MeghanaMadhuri/jetsonuarteyes/nina/controllers/hoverboard_axis_drive.py

"""
Drive Nina locomotion by tilting hoverboard driver modules via Dynamixel MX-28.

Primary Nina locomotion: lean servos on the Dynamixel bus (joint mode). API subset
matches ``NavigationManager`` as used by ``DriveController``, autonomy, and goto.

**Straight-line prime:** before each new symmetric straight FWD/BACK ``set_wheels``,
both lean servos move to ``NINA_HOVER_STRAIGHT_PRIME_POS`` (default 2048) for up to
``NINA_HOVER_STRAIGHT_PRIME_SEC`` (default 2 s). **Timed Turn left/right** do **not**
use this prime—they go straight to pivot ``set_wheels`` from the current pose.
D-pad pivots also skip the explicit prime.

After a pivot the brake pose is **already** at the prime ticks, so the prime
returns immediately and can look like it was skipped to the operator. Set
``NINA_HOVER_POST_TURN_SETTLE_SEC`` (default 0.0) to add a visible pause inside
``start_pulse_straight_forward`` / ``start_pulse_straight_backward`` after the
prime so the lean stack truly relaxes before the next pulse series fires—useful
when "Straight back" right after "Turn left/right" felt like it jumped straight
into the back stroke without slowing down.

**Pivot / turn:** lean ID ``id_left`` (often 12) and ``id_right`` (often 13) use
opposite forward/back goals. **Turn left** = left forward lean + right backward
lean. **Timed** ``turn_left`` / ``turn_right`` use full pivot goals (100% blend).
**Held** D-pad L/R use ``pulse_turn_micro_step`` at :data:`_HELD_DPAD_PIVOT_BLEND_PCT`
(30% of full pivot by default). Legacy unequal-duty path uses
``NINA_HOVER_TURN_SLOW_WHEEL_PCT`` vs outer ``speed_percent``. **Turn right** mirrors left.

**Straight FWD/BACK (drive-then-check):** ``start_pulse_straight_forward`` and
``start_pulse_straight_backward`` spawn :meth:`_drift_correct_loop` — the method
names are legacy. Each cycle: command full forward/back lean for
``NINA_HOVER_STRAIGHT_LEG_SEC`` (default **0.5 s**), brake, wait for standstill
(active settle on IMU yaw rate when wired), sample **cumulative** drift from the
integrator, run iterative left/right micro-step pivots when ``|drift|`` exceeds
``NINA_HOVER_STRAIGHT_CORR_DEADBAND_DEG``, then repeat until the operator
releases (``_halt_pulse_series``) or abort drift fires. The old coast↔forward
pulse ramp series is removed. Cancel with ``stop()`` / ``emergency_stop()`` /
``set_wheels`` / ``drive_continuous``.

**IMU hooks:** call :meth:`set_imu_hooks` once at construction with a yaw-drift
sampler, yaw-rate sampler (for active settle), and begin/end straight callbacks
(``NinaService`` wires :class:`Mpu9250DriftMonitor` here). Without hooks the
straight loop still runs 0.5 s legs but skips drift correction
(``no IMU sample, skipping drift check`` in logs). Tune standstill correction
via ``NINA_HOVER_STRAIGHT_CORR_*``; legacy ``NINA_HOVER_IMU_CORR_*`` knobs
below apply to other paths (e.g. held-turn micro-steps), not the straight loop.

Bail behaviour (defends against an un-flipped ``INVERT_SIGN`` on a new
chassis without false-tripping on momentum or correct-direction overshoot):
- The first ``NINA_HOVER_IMU_CORR_BAIL_WARMUP_STEPS`` samples are ignored
  for the bail — the bot is still bleeding off angular momentum from the
  pre-brake forward lean, so drift growth during this window does not
  imply a wrong pivot direction.
- The bail only fires when drift is **still in the same sign as the
  original drift**. If the realign over-corrects past zero, the
  ``overshoot guard`` handles it (cleanly exits with reason "over-shot
  zero"); the wrong-direction bail does not fire on opposite-sign growth
  (that would mis-attribute a too-strong-but-correct pivot as a wrong
  direction).
- Past warmup, with same-sign drift, the bail pins ``yaw_after_warmup``
  on the first qualifying sample and only fires once
  ``|drift| > |yaw_after_warmup| + NINA_HOVER_IMU_CORR_BAIL_MARGIN_DEG``
  for two consecutive same-sign samples. Margin defaults to 5° so a
  single noisy read or minor momentum overshoot can't kill an otherwise
  correct realign.

Tuning env vars (defaults make each step visibly authoritative on the
hoverboard chassis; lower them only if the realign is over-shooting):

  ``NINA_HOVER_IMU_CORR_ENABLE``                default 1
  ``NINA_HOVER_IMU_CORR_THRESHOLD_DEG``         default 4.0   (only fire when drift gets noticeable)
  ``NINA_HOVER_IMU_CORR_DEADBAND_DEG``          default 1.5   (stop realign when drift returns inside this)
  ``NINA_HOVER_IMU_CORR_PIVOT_BLEND_PCT``       (legacy; in-motion pivots use held-D-pad blend)
  ``NINA_HOVER_IMU_CORR_PIVOT_MAX_SEC``         (legacy; in-motion uses ``NINA_HOVER_TURN_STEP_*``)
  ``NINA_HOVER_IMU_CORR_STEP_MIN_SEC``          (legacy; in-motion uses ``NINA_HOVER_TURN_STEP_*``)
  ``NINA_HOVER_IMU_CORR_STEP_RATE_DEG_PER_SEC`` (legacy; in-motion uses ``NINA_HOVER_TURN_STEP_RATE``)
  ``NINA_HOVER_IMU_CORR_STEP_SETTLE_SEC``       (legacy; standstill drift-correct only)

  In-motion left/right yaw realign during forward/back pulse holds uses the **same**
  lean pacing as held D-pad L/R (``NINA_HOVER_TURN_STEP_DUR_CAP_SEC`` default 0.26 s,
  ``NINA_HOVER_TURN_STEP_MIN_SEC`` 0.10 s, ``NINA_HOVER_TURN_STEP_SETTLE_SEC`` 0.12 s,
  ``NINA_HOVER_TURN_STEP_RATE_DEG_PER_SEC`` 22 dps, 30% pivot blend,
  ``NINA_HOVER_TURN_PRE_SETTLE_SEC`` / ``NINA_HOVER_TURN_POST_SETTLE_SEC``).
  ``NINA_HOVER_IMU_CORR_MAX_STEPS``             default 15    (hard cap on micro-step iterations;
                                                                with proportional sizing typical
                                                                events terminate in 1-3 steps)
  ``NINA_HOVER_IMU_CORR_PROGRESS_CHECK_STEPS``  default 4     (check progress after N steps;
                                                                set 0 to disable)
  ``NINA_HOVER_IMU_CORR_PROGRESS_MIN_DEG``      default 1.0   (min cumulative improvement in
                                                                ``|drift|`` required by the
                                                                progress-check step; below this
                                                                the realign exits as "no progress"
                                                                so the cooldown + next event can
                                                                try fresh instead of burning
                                                                MAX_STEPS on a stuck loop)
  ``NINA_HOVER_IMU_CORR_BAIL_WARMUP_STEPS``     default 3     (steps before wrong-direction bail
                                                                can fire — absorbs pre-brake momentum)
  ``NINA_HOVER_IMU_CORR_BAIL_MARGIN_DEG``       default 5.0   (drift growth past post-warmup baseline
                                                                required to actually bail; must be
                                                                exceeded on 2 consecutive samples)
  ``NINA_HOVER_IMU_CORR_SETTLE_SEC``            default 0.25  (brake settle BEFORE the first step AND
                                                                AFTER the loop, before re-priming)
  ``NINA_HOVER_IMU_CORR_COOLDOWN_SEC``          default 1.0   (rest period after each correction before
                                                                the next IMU sample; persists across
                                                                pulse cycles so corrections don't fire
                                                                back-to-back)
  ``NINA_HOVER_IMU_CORR_POLL_HZ``               default 5     (drift sample rate inside pulse holds)
  ``NINA_HOVER_IMU_CORR_INVERT_SIGN``           default 0     (flip drift sign interpretation)
  ``NINA_HOVER_IMU_CORR_SWAP_PIVOT_DIR``        deprecated — yaw correction uses
                                                                ``NINA_HOVER_TURN_SWAP_PIVOT_DIR`` (same
                                                                as held D-pad / closed-loop turns)

Backward-direction overrides (THRESHOLD and STEP_RATE ship with their own
backward-optimised defaults baked in after field testing; COOLDOWN still
inherits from forward unless explicitly set):

  ``NINA_HOVER_IMU_CORR_BACK_THRESHOLD_DEG``     default 6.0
                                                                (vs forward 4.0; higher because the
                                                                chassis naturally drifts to a ~+8 deg
                                                                rest pose in reverse and the forward
                                                                threshold fires spuriously on that
                                                                bias. Lower this to react earlier;
                                                                raise to let small drift slide.)
  ``NINA_HOVER_IMU_CORR_BACK_COOLDOWN_SEC``      default = forward cooldown
                                                                (1.0 s works for both directions per
                                                                field testing; lower this if backward
                                                                natural drift outpaces the gap)
  ``NINA_HOVER_IMU_CORR_BACK_STEP_RATE_DEG_PER_SEC`` default 60.0
                                                                (vs forward 30.0; higher because
                                                                backward pivots are physically more
                                                                authoritative on this chassis -- the
                                                                forward 30.0 calibration over-shoots
                                                                when reused in reverse. Raise this if
                                                                backward still over-corrects; lower
                                                                if backward under-corrects.)

Stuck detector (defends against a feedback loop where the chassis is
stationary, the pivot lean can't rotate stationary wheels, every realign
exits as "no progress", and the regular short cooldown immediately fires
another equally-doomed realign — locking the bot in place):

  ``NINA_HOVER_IMU_CORR_STUCK_STREAK``           default 3     (consecutive ``no progress`` exits before
                                                                the stuck cooldown kicks in; set to 0 to
                                                                disable the detector entirely)
  ``NINA_HOVER_IMU_CORR_STUCK_COOLDOWN_SEC``     default 8.0   (cooldown applied when the detector fires;
                                                                long enough that the pulse loop gets at
                                                                least one full hold cycle to build wheel
                                                                momentum and break the chassis out of the
                                                                stationary state. Resets back to the
                                                                regular direction-aware cooldown on the
                                                                first successful realign — any non-
                                                                no-progress exit clears the streak)

Drift-abort (catastrophic-drift safety stop with spoken alert; sits
above the realign loop so a sign-flipped IMU mount, a failed wheel, or
any condition that puts the bot into a runaway spin terminates the
pulse leg cleanly instead of spending pulse cycles snaking off course):

  ``NINA_HOVER_IMU_CORR_ABORT_DRIFT_DEG``        default 30.0  (abort the pulse series when ``|drift|``
                                                                first crosses this magnitude on a fresh
                                                                IMU sample. Brakes the lean stack, sets
                                                                the pulse halt event, and queues a
                                                                single TTS announcement via
                                                                :func:`nina.services.sensor_alert_audio.maybe_speak_cant_move_alert`
                                                                — the exact phrase is
                                                                :data:`_IMU_CORR_ABORT_PHRASE`. The
                                                                operator must issue a fresh drive
                                                                command to resume — there is no
                                                                automatic retry. Set to ``0`` to
                                                                disable. Fires on both the forward
                                                                and backward pulse loops.)

Logging convention: every IMU-correction log line emitted from inside the
pulse hold (``hover IMU correction (forward): ...`` or
``hover IMU correction (backward): ...``) carries the direction tag of the
pulse loop that triggered it. The correction geometry is identical for
both directions (the pivot command is decided from the SIGN of the world-
frame drift sample, not from the chassis motion direction), but tagging
lets the operator confirm via ``grep`` that the backward pulse loop is
actually firing corrections — and at what rate / magnitude relative to
forward — without needing to cross-reference timestamps against the
``hover backward pulse series`` banner. The realign banner reports the
*effective* threshold / step_rate for the direction in which the
correction is firing, so a backward correction running under
``NINA_HOVER_IMU_CORR_BACK_THRESHOLD_DEG=3.0`` will print ``>= 3.00 deg
threshold`` even when forward is configured for 4.0.
"""

from __future__ import annotations

import logging
import math
import os
import threading
import time
import traceback
from typing import Callable, Dict, Optional, Tuple

from nina.config.settings import HoverboardAxisSettings
from nina.controllers.dynamixel_manager import REG_PRESENT_POS, DynamixelManager
from nina.services.sensor_alert_audio import maybe_speak_cant_move_alert

log = logging.getLogger("nina.hoverboard_axis")

# Spoken when the drift-abort fires; kept as a module constant so tests can
# assert on the exact phrase the operator will hear and so the bldc speech
# alerts cooldown (12 s default) coalesces repeated aborts within one leg.
_IMU_CORR_ABORT_PHRASE = "I can't move steadily any further, stopping now."

# Yaw drift sampler — returns signed degrees ``+`` = bot drifted right, ``-`` = left,
# or ``None`` when the integrator is paused / calibrating / unavailable.
ImuYawDriftFn = Callable[[], Optional[float]]
# Instantaneous yaw rate sampler — returns signed deg/s (sign convention matches
# the drift sampler) or ``None`` when the gyro is unavailable. Used by the new
# active-settle (wait-until-chassis-is-actually-still) helper in the forward
# straight loop; if not wired the loop falls back to a fixed timer.
ImuYawRateFn = Callable[[], Optional[float]]
# Optional begin/end hooks called when the drive enters / leaves a straight leg.
ImuStraightHook = Callable[[], None]

_POS_SPAN_DEG = 300.0


def _smoothstep01(t: float) -> float:
    """Hermite smoothstep; zero derivative at 0 and 1 (soft turnarounds)."""
    t = max(0.0, min(1.0, float(t)))
    return t * t * (3.0 - 2.0 * t)


def _smootherstep01(t: float) -> float:
    """Quintic Perlin smootherstep; zero 1st and 2nd derivative at 0 and 1."""
    t = max(0.0, min(1.0, float(t)))
    return t * t * t * (t * (t * 6.0 - 15.0) + 10.0)


def _cubic_ease_in_out01(t: float) -> float:
    """Symmetric cubic ease-in-out; slower ends, faster middle than smoothstep."""
    t = max(0.0, min(1.0, float(t)))
    if t < 0.5:
        return 4.0 * t * t * t
    u = 2.0 * t - 2.0
    return 1.0 + 0.5 * u * u * u


def _trapezoid_blend01(t: float, edge_frac: float) -> float:
    """Blend parameter 0->1 with trapezoidal *velocity* (ease accel / cruise / decel).

    *edge_frac* is the fraction of total time for symmetric accel+decel (each ``edge_frac``).
    """
    t = max(0.0, min(1.0, float(t)))
    e = max(0.08, min(0.35, float(edge_frac)))
    if 2.0 * e >= 0.999:
        return _smootherstep01(t)
    a = e / (2.0 * (1.0 - e))
    if t <= e:
        return a * (t / e) * (t / e)
    if t >= 1.0 - e:
        u = (1.0 - t) / e
        return 1.0 - a * u * u
    return a + (1.0 - 2.0 * a) * (t - e) / (1.0 - 2.0 * e)


def _pulse_ramp_blend_u(t: float, profile: str, trap_edge: float) -> float:
    """Map uniform time *t* in [0,1] to position blend *u* in [0,1] for servo ramps."""
    p = (profile or "smootherstep").strip().lower()
    if p == "smoothstep":
        return _smoothstep01(t)
    if p == "smootherstep":
        return _smootherstep01(t)
    if p in ("cubic_io", "cubic", "cubic-ease"):
        return _cubic_ease_in_out01(t)
    if p in ("trapezoid", "trap", "velocity"):
        return _trapezoid_blend01(t, trap_edge)
    return _smootherstep01(t)


def _nudge_goal_from_brake(goal: int, brake: int, push: int) -> int:
    """Move *goal* *push* raw ticks away from *brake* (signed).

    Positive *push* moves further from brake (i.e. MORE lean, in
    whichever direction *goal* already sits relative to *brake*).
    Negative *push* pulls back toward brake (LESS lean). ``push == 0``
    is a no-op. If *goal* is exactly at *brake* there's no defined
    "away" direction so we return *goal* unchanged regardless of
    *push*.

    Used by:
    - the forward straight branch (per-side raw delta on ``forward_pos_*``,
      then ``_STRAIGHT_FWD_EXTRA_TICKS`` away from brake),
    - the turn pivot helper (positive ``turn_push_ticks`` /
      ``_TURN_PIVOT_GOAL_OFFSET_TICKS``),
    - the backward straight branch (signed per-side
      ``_STRAIGHT_BACK_{LEFT,RIGHT}_TICKS_OFFSET`` — operator can
      either reinforce the calibrated lean (positive) or trim it back
      toward neutral (negative) without re-tuning ``backward_pos_*``).
    """
    if push == 0:
        return goal
    if goal > brake:
        return goal + push
    if goal < brake:
        return goal - push
    return goal


def apply_hoverboard_brake_positions(dxl: DynamixelManager, axis_cfg: HoverboardAxisSettings) -> None:
    """Command lean servos to the configured brake pose (boot / stopped)."""
    dxl._require_initialized()
    lid = int(axis_cfg.id_left)
    rid = int(axis_cfg.id_right)
    left = dxl._clamp_pos(int(axis_cfg.brake_pos_left))
    right = dxl._clamp_pos(int(axis_cfg.brake_pos_right))
    ms = max(0, min(1023, int(axis_cfg.moving_speed)))
    dxl.sync_write_moving_speed_subset({lid: ms, rid: ms})
    dxl.sync_write_goal_position({lid: left, rid: right})


_POS_SCALE = 4096.0 / _POS_SPAN_DEG

# Extra raw ticks past calibrated ``forward_pos_*`` toward drive (symmetric straight FWD only).
_STRAIGHT_FWD_EXTRA_TICKS = 14

# Per-side raw tick delta added to ``forward_pos_*`` before the straight
# FWD extra nudge. Matches operator bench language (±N ticks on the goal).
# Fleet bench (FWD 2022/2080, brake 2048, +14 nudge): motor 12 → 2010,
# motor 13 → 2104.
_STRAIGHT_FWD_LEFT_TICKS_OFFSET = 2
_STRAIGHT_FWD_RIGHT_TICKS_OFFSET = 10


def _straight_fwd_left_ticks_offset() -> int:
    """Raw tick delta on ``forward_pos_left`` for straight FWD (env:
    ``NINA_HOVER_STRAIGHT_FWD_LEFT_TICKS_OFFSET``, default +2 — with fleet
    ``NINA_HOVER_FWD_POS_LEFT=2022`` yields straight goal **2010**)."""
    try:
        return max(
            -50,
            min(
                50,
                int(
                    os.environ.get(
                        "NINA_HOVER_STRAIGHT_FWD_LEFT_TICKS_OFFSET",
                        str(_STRAIGHT_FWD_LEFT_TICKS_OFFSET),
                    )
                ),
            ),
        )
    except ValueError:
        return _STRAIGHT_FWD_LEFT_TICKS_OFFSET


def _straight_fwd_right_ticks_offset() -> int:
    """Signed trim on ``forward_pos_right`` for straight FWD (env:
    ``NINA_HOVER_STRAIGHT_FWD_RIGHT_TICKS_OFFSET``, default +10 — with fleet
    ``NINA_HOVER_FWD_POS_RIGHT=2080`` yields straight goal **2104**)."""
    try:
        return max(
            -50,
            min(
                50,
                int(
                    os.environ.get(
                        "NINA_HOVER_STRAIGHT_FWD_RIGHT_TICKS_OFFSET",
                        str(_STRAIGHT_FWD_RIGHT_TICKS_OFFSET),
                    )
                ),
            ),
        )
    except ValueError:
        return _STRAIGHT_FWD_RIGHT_TICKS_OFFSET


# Per-side SIGNED nudge magnitudes for the straight BACK leg, applied
# via :func:`_nudge_goal_from_brake` (same mechanism the forward branch
# uses, just with independent per-side magnitudes). Positive value =
# MORE backward lean for that side; negative = LESS lean (pulled
# toward brake). This direction-of-lean-aware nudge is required
# because ``backward_pos_left`` and ``backward_pos_right`` can sit on
# OPPOSITE sides of brake on the same chassis — a raw integer
# ``goal + offset`` would push one side's lean further out and the
# other side's lean closer to neutral for the SAME positive offset,
# which is exactly the bug that produced the "motor 12 leans, motor 13
# doesn't get pushed, chassis spins" symptom in the field.
#
# Defaults are 0 / 0 — i.e. drive the bare calibrated
# ``backward_pos_*`` straight through with no per-side trim.
# Operator's bench-validated calibration on the reference chassis
# (``backward_pos_left = 2005``, ``backward_pos_right = 1995``, both
# BELOW brake=2048) already carries the asymmetric lean it needs
# baked into the calibrated source itself, so no additional per-side
# bias is needed by default.
#
# Operators can re-tune per-bot via
# ``NINA_HOVER_STRAIGHT_BACK_LEFT_TICKS_OFFSET`` and
# ``NINA_HOVER_STRAIGHT_BACK_RIGHT_TICKS_OFFSET`` (signed, clamped to
# ``[-50, 50]``). Positive values add lean (further from brake);
# negative trim the calibrated lean closer to neutral without
# re-tuning ``backward_pos_*`` itself.
_STRAIGHT_BACK_LEFT_TICKS_OFFSET = 0
_STRAIGHT_BACK_RIGHT_TICKS_OFFSET = 0


def _straight_back_left_ticks_offset() -> int:
    """Signed raw tick offset added to ``backward_pos_left`` for the
    straight BACK leg (env: ``NINA_HOVER_STRAIGHT_BACK_LEFT_TICKS_OFFSET``,
    default :data:`_STRAIGHT_BACK_LEFT_TICKS_OFFSET`).

    Clamped to ``[-50, 50]`` so a typo can't drive the lean stack into
    a saturated corner. Garbage falls back to the documented default.
    See the module-level comment near
    :data:`_STRAIGHT_BACK_LEFT_TICKS_OFFSET` for the wheel-asymmetry
    rationale.
    """
    try:
        return max(
            -50,
            min(
                50,
                int(
                    os.environ.get(
                        "NINA_HOVER_STRAIGHT_BACK_LEFT_TICKS_OFFSET",
                        str(_STRAIGHT_BACK_LEFT_TICKS_OFFSET),
                    )
                ),
            ),
        )
    except ValueError:
        return _STRAIGHT_BACK_LEFT_TICKS_OFFSET


def _straight_back_right_ticks_offset() -> int:
    """Signed raw tick offset added to ``backward_pos_right`` for the
    straight BACK leg (env: ``NINA_HOVER_STRAIGHT_BACK_RIGHT_TICKS_OFFSET``,
    default :data:`_STRAIGHT_BACK_RIGHT_TICKS_OFFSET`).

    Clamped to ``[-50, 50]``. See the per-side asymmetric-trim notes
    near :data:`_STRAIGHT_BACK_LEFT_TICKS_OFFSET`.
    """
    try:
        return max(
            -50,
            min(
                50,
                int(
                    os.environ.get(
                        "NINA_HOVER_STRAIGHT_BACK_RIGHT_TICKS_OFFSET",
                        str(_STRAIGHT_BACK_RIGHT_TICKS_OFFSET),
                    )
                ),
            ),
        )
    except ValueError:
        return _STRAIGHT_BACK_RIGHT_TICKS_OFFSET

# Pivot only (L/R yaw): extra nudge away from each side's brake (after
# ``turn_push_ticks``). Must use directional nudge — a raw +Δ on both goals
# can land on brake and wipe blended timed-turn motion for that axis.
_TURN_PIVOT_GOAL_OFFSET_TICKS = 100

# IMU drift correction + closed-loop 90° turns: full calibrated pivot goals.
_PIVOT_MICROSTEP_BLEND_PCT = 100

# Held D-pad left/right (``pulse_turn_micro_step``) and timed turn_* fallback:
# 30% = 70% reduction from full pivot (mechanical shock).
_HELD_DPAD_PIVOT_BLEND_PCT = 30


def hover_computed_turn_pivot_goals(
    axis: HoverboardAxisSettings,
    *,
    turn_left: bool,
) -> tuple[int, int]:
    """Full pivot (id_left, id_right) raw goals from FWD/REV + push ticks + pivot offset.

    Used by :meth:`HoverboardAxisDrive._goals_for_wheels` when optional
    per-turn overrides are unset.
    """
    def _cg(t: int) -> int:
        return max(0, min(4095, int(t)))

    nl = _cg(int(axis.brake_pos_left))
    nr = _cg(int(axis.brake_pos_right))
    fl = _cg(int(axis.forward_pos_left))
    fr = _cg(int(axis.forward_pos_right))
    bl = _cg(int(axis.backward_pos_left))
    br = _cg(int(axis.backward_pos_right))
    if turn_left:
        l_tgt, r_tgt = fl, br
    else:
        l_tgt, r_tgt = bl, fr
    if axis.swap_turn_lr:
        l_tgt, r_tgt = r_tgt, l_tgt
    push = int(axis.turn_push_ticks)
    if push > 0:
        l_tgt = _nudge_goal_from_brake(l_tgt, nl, push)
        r_tgt = _nudge_goal_from_brake(r_tgt, nr, push)
    extra = int(_TURN_PIVOT_GOAL_OFFSET_TICKS)
    if extra > 0:
        l_tgt = _cg(_nudge_goal_from_brake(l_tgt, nl, extra))
        r_tgt = _cg(_nudge_goal_from_brake(r_tgt, nr, extra))
    return l_tgt, r_tgt


def _straight_prime_goal_ticks() -> int:
    try:
        return max(0, min(4095, int(os.environ.get("NINA_HOVER_STRAIGHT_PRIME_POS", "2048"))))
    except ValueError:
        return 2048


def _straight_prime_timeout_sec() -> float:
    try:
        return max(0.05, min(5.0, float(os.environ.get("NINA_HOVER_STRAIGHT_PRIME_SEC", "2.0"))))
    except ValueError:
        return 2.0


def _straight_prime_tol_ticks() -> int:
    try:
        return max(1, min(512, int(os.environ.get("NINA_HOVER_STRAIGHT_PRIME_TOL_TICKS", "32"))))
    except ValueError:
        return 32


def _post_turn_settle_sec() -> float:
    """Extra dwell after the straight prime inside ``start_pulse_straight_*``.

    When ``stop()`` from a pivot leaves the lean stack at the brake pose AND the
    prime goal equals brake, ``_prime_straight_neutral`` returns immediately on
    the first present-position read—so the operator can't see priming happen
    before the next pulse series fires. Setting this >0 inserts a visible pause
    (logged) after the prime, before the back / forward pulse begins.
    """
    raw = (os.environ.get("NINA_HOVER_POST_TURN_SETTLE_SEC") or "").strip()
    if not raw:
        return 0.0
    try:
        return max(0.0, min(2.0, float(raw)))
    except ValueError:
        return 0.0


def _imu_corr_enabled() -> bool:
    raw = (os.environ.get("NINA_HOVER_IMU_CORR_ENABLE") or "").strip().lower()
    if raw == "":
        return True  # default ON when hooks are wired
    return raw in ("1", "true", "yes", "y", "on")


def _imu_corr_threshold_deg() -> float:
    """At/above this |drift|, pause forward motion and run the incremental
    realign. Higher = less twitchy but each correction does more work.
    """
    try:
        return max(
            0.1,
            min(45.0, float(os.environ.get("NINA_HOVER_IMU_CORR_THRESHOLD_DEG", "4.0"))),
        )
    except ValueError:
        return 4.0


def _imu_corr_deadband_deg() -> float:
    """The micro-step realign exits once ``|drift| <= deadband``. Smaller =
    tighter heading hold but more micro-steps per correction.
    """
    try:
        return max(
            0.0,
            min(10.0, float(os.environ.get("NINA_HOVER_IMU_CORR_DEADBAND_DEG", "1.5"))),
        )
    except ValueError:
        return 1.5


def _imu_corr_pivot_blend_pct() -> int:
    """Per-micro-step pivot blend % — always full pivot (:data:`_PIVOT_MICROSTEP_BLEND_PCT`)."""
    return _PIVOT_MICROSTEP_BLEND_PCT


def _imu_corr_pivot_max_sec() -> float:
    """**Per-micro-step** pivot duration cap. Default 0.18 s so each step
    rotates the bot a visible 1.5-2° at the 20 % blend (the MX-28 needs
    >100 ms of commanded goal to actually slew there). The realign loop
    reads the live drift after every step, so total correction time
    auto-scales with the magnitude of the drift instead of being decided
    up-front.
    """
    try:
        return max(
            0.02,
            min(3.0, float(os.environ.get("NINA_HOVER_IMU_CORR_PIVOT_MAX_SEC", "0.18"))),
        )
    except ValueError:
        return 0.18


def _imu_corr_step_settle_sec() -> float:
    """Brake dwell BETWEEN micro-steps so the IMU re-samples on a still bot.

    Smaller = faster total realign, but the integrator can be noisy if the
    chassis is still rotating from the last step. 0.08 s is the default.
    """
    try:
        return max(
            0.0,
            min(1.0, float(os.environ.get("NINA_HOVER_IMU_CORR_STEP_SETTLE_SEC", "0.08"))),
        )
    except ValueError:
        return 0.08


def _imu_corr_max_steps() -> int:
    """Hard cap on micro-step iterations inside one realign. Worst-case the
    routine corrects ``max_steps * step_rotation`` of drift before giving
    up. Default 15 keeps the routine bounded to ~4 s at the default per-step
    timings while still giving ~20-30° of correction head-room.
    """
    try:
        return max(
            1,
            min(200, int(float(os.environ.get("NINA_HOVER_IMU_CORR_MAX_STEPS", "15")))),
        )
    except ValueError:
        return 15


def _imu_corr_step_rate_deg_per_sec() -> float:
    """Empirical chassis rotation rate (deg/s) at the configured per-step
    blend. Used to make the realign **proportional**: each step's duration
    is scaled by the remaining drift so small drifts get short pulses and
    big drifts get the full ``PIVOT_MAX_SEC`` cap. Default 30 deg/s
    matches the 20 % blend on the current hoverboard build (bench
    measured); tune up if the bot still over-shoots small drifts, or down
    if it visibly under-corrects.
    """
    try:
        return max(
            1.0,
            min(360.0, float(os.environ.get("NINA_HOVER_IMU_CORR_STEP_RATE_DEG_PER_SEC", "30.0"))),
        )
    except ValueError:
        return 30.0


def _imu_corr_step_min_sec() -> float:
    """Floor on the per-step duration. The MX-28 has ~50 ms of slew
    latency before any visible rotation; pulses below this floor are
    effectively no-ops. Default 0.08 s puts a little headroom above the
    slew latency so even the smallest proportional step produces measurable
    rotation.
    """
    try:
        return max(
            0.01,
            min(1.0, float(os.environ.get("NINA_HOVER_IMU_CORR_STEP_MIN_SEC", "0.08"))),
        )
    except ValueError:
        return 0.08


def _imu_corr_progress_check_steps() -> int:
    """Number of micro-steps the realign will run before checking that it's
    actually making progress. If, after this many steps, drift hasn't
    improved by at least ``PROGRESS_MIN_DEG``, the realign exits cleanly
    with reason "no progress" so the cooldown + next-event cycle can try
    fresh instead of burning ``MAX_STEPS`` worth of ineffective pulses.

    Set to 0 to disable the check entirely (legacy max-steps-only behaviour).
    """
    try:
        return max(
            0,
            min(50, int(float(os.environ.get("NINA_HOVER_IMU_CORR_PROGRESS_CHECK_STEPS", "4")))),
        )
    except ValueError:
        return 4


def _imu_corr_progress_min_deg() -> float:
    """Minimum improvement in ``|drift|`` (deg) the realign must show by
    step ``PROGRESS_CHECK_STEPS``, otherwise it bails as "no progress".

    Defaults to 1.0 — very lenient (only 0.25 deg/step on average after
    4 steps). Tighter than this would be too noisy.
    """
    try:
        return max(
            0.0,
            min(20.0, float(os.environ.get("NINA_HOVER_IMU_CORR_PROGRESS_MIN_DEG", "1.0"))),
        )
    except ValueError:
        return 1.0


def _imu_corr_bail_warmup_steps() -> int:
    """Micro-steps to skip at the START of a realign before the wrong-direction
    bail can fire. The bot has angular momentum from the forward lean when
    the realign brakes; the first 1-3 samples can show drift growth that
    has nothing to do with the pivot direction — they're just the chassis
    bleeding off its pre-brake rotation. Default 3 absorbs that, then the
    bail is allowed to fire on real sign-mismatch evidence.
    Set to a very large number to effectively disable the bail.
    """
    try:
        return max(
            0,
            min(50, int(float(os.environ.get("NINA_HOVER_IMU_CORR_BAIL_WARMUP_STEPS", "3")))),
        )
    except ValueError:
        return 3


def _imu_corr_bail_margin_deg() -> float:
    """How far ``|drift|`` must exceed the post-warmup baseline before the
    wrong-direction bail fires. The 2-consecutive-growth check then has to
    BOTH be growing AND beyond this margin to bail, so a single noisy
    sample or a brief momentum overshoot can't kill an otherwise correct
    realign. Default 5° (much larger than the typical per-step rotation).
    """
    try:
        return max(
            0.5,
            min(45.0, float(os.environ.get("NINA_HOVER_IMU_CORR_BAIL_MARGIN_DEG", "5.0"))),
        )
    except ValueError:
        return 5.0


def _imu_corr_settle_sec() -> float:
    """Brake settle dwell applied both before and after each correction pivot."""
    try:
        return max(
            0.0,
            min(2.0, float(os.environ.get("NINA_HOVER_IMU_CORR_SETTLE_SEC", "0.25"))),
        )
    except ValueError:
        return 0.25


def _imu_corr_cooldown_sec() -> float:
    """Mandatory primed-forward rest after each correction before sampling again.

    Persists across pulse cycles via ``self._imu_corr_next_sample_at`` so two
    corrections never fire back-to-back. The bot must spend at least this long
    actually moving forward (or backward) primed before the next pivot can be
    triggered.
    """
    try:
        return max(
            0.0,
            min(10.0, float(os.environ.get("NINA_HOVER_IMU_CORR_COOLDOWN_SEC", "1.0"))),
        )
    except ValueError:
        return 1.0


def _imu_corr_invert_sign() -> bool:
    """Flip the IMU drift sign before choosing a pivot direction.

    Defaults to off so behaviour matches the original convention
    ("positive drift = drifted right, pivot left"). Set to ``1`` on chassis
    where the MPU mount orientation and / or ``NINA_HOVER_SWAP_TURN_LR``
    combination cause every correction to **add** drift in the same
    direction (a sure sign the pivot is going the wrong way for that
    geometry).
    """
    raw = (os.environ.get("NINA_HOVER_IMU_CORR_INVERT_SIGN") or "").strip().lower()
    return raw in ("1", "true", "yes", "y", "on")


def _imu_corr_poll_hz() -> float:
    """How often the pulse hold samples yaw drift. Lower = calmer / fewer pivots."""
    try:
        return max(
            1.0,
            min(60.0, float(os.environ.get("NINA_HOVER_IMU_CORR_POLL_HZ", "5.0"))),
        )
    except ValueError:
        return 5.0


# ----------------------------------------------------------------------
# Backward-direction overrides
#
# The forward pulse and the backward pulse share the same IMU correction
# code path (see ``_imu_corrective_hold`` / ``_perform_pivot_correction``)
# because the pivot direction is derived from the SIGN of the world-frame
# drift sample, not from the chassis motion direction. The mechanics,
# however, are NOT symmetric — on a typical hoverboard build the natural
# yaw rate while reversing can be one to two orders of magnitude higher
# than while going forward (mismatched brake / coast lean per wheel in
# reverse, hub-motor freewheel asymmetry, weight transfer onto the
# trailing wheel, etc.). The forward-only tunables that work well at
# ~0.2 deg/s natural drift produce a visible "snake" pattern at the
# ~30 deg/s natural drift rate observed during reverse.
#
# THRESHOLD and STEP_RATE have their own backward-optimised defaults baked
# in after field testing on the hoverboard chassis (operator "Option B"
# run: bot translated cleanly with smooth correction cycles). COOLDOWN
# still inherits from forward because the forward 1.0 s default also gave
# healthy backward rhythm during field testing. The operator can override
# any of the three via env vars; these constants are only the fallback
# when the env is unset / unparseable.
_IMU_CORR_BACK_DEFAULT_THRESHOLD_DEG = 6.0       # vs forward 4.0
_IMU_CORR_BACK_DEFAULT_STEP_RATE_DPS = 60.0      # vs forward 30.0
# ----------------------------------------------------------------------


def _imu_corr_back_threshold_deg(default: float) -> float:
    """Backward drift threshold (env: ``NINA_HOVER_IMU_CORR_BACK_THRESHOLD_DEG``).

    When unset or unparseable, returns *default*. The call site passes
    :data:`_IMU_CORR_BACK_DEFAULT_THRESHOLD_DEG` (6.0 — backward-optimised)
    rather than the forward threshold, because the backward leg behaves
    qualitatively differently: a forward-tuned 4.0 threshold fires
    spuriously at the chassis's natural backward rest pose (typically
    ~+8 deg) and locks the bot in a thrashing loop. Lower this to react
    to drift sooner; raise it to let small drift slide.

    Clamped to ``[0.1, 45]`` (same range as the forward helper).
    """
    raw = os.environ.get("NINA_HOVER_IMU_CORR_BACK_THRESHOLD_DEG")
    if raw is None or raw.strip() == "":
        return default
    try:
        return max(0.1, min(45.0, float(raw)))
    except ValueError:
        return default


def _imu_corr_back_cooldown_sec(default: float) -> float:
    """Backward cooldown override (env: ``NINA_HOVER_IMU_CORR_BACK_COOLDOWN_SEC``).

    Unlike threshold and step_rate, cooldown still defaults to the
    *forward* value (call site passes ``self._imu_corr_cooldown_sec``)
    because field testing showed forward's 1.0 s default also produces a
    healthy backward correction rhythm. Set this env var lower if the
    chassis's natural backward drift rate is so high that 1 s lets too
    much drift accumulate between corrections.

    Clamped to ``[0.0, 10.0]`` (same range as the forward helper).
    """
    raw = os.environ.get("NINA_HOVER_IMU_CORR_BACK_COOLDOWN_SEC")
    if raw is None or raw.strip() == "":
        return default
    try:
        return max(0.0, min(10.0, float(raw)))
    except ValueError:
        return default


def _imu_corr_back_step_rate_deg_per_sec(default: float) -> float:
    """Backward per-step rotation rate (env: ``NINA_HOVER_IMU_CORR_BACK_STEP_RATE_DEG_PER_SEC``).

    The proportional micro-step duration is computed as
    ``|drift| / step_rate``, so a HIGHER rate produces SHORTER pulses.
    The call site passes :data:`_IMU_CORR_BACK_DEFAULT_STEP_RATE_DPS`
    (60.0) rather than the forward 30.0, because backward pivots on this
    chassis are physically more authoritative than forward pivots — the
    forward calibration over-shoots when reused in reverse. Raise this
    if backward still over-corrects; lower it if backward under-corrects.

    Clamped to ``[1.0, 360.0]`` (same range as the forward helper).
    """
    raw = os.environ.get("NINA_HOVER_IMU_CORR_BACK_STEP_RATE_DEG_PER_SEC")
    if raw is None or raw.strip() == "":
        return default
    try:
        return max(1.0, min(360.0, float(raw)))
    except ValueError:
        return default


# ----------------------------------------------------------------------
# Stuck detector
#
# The iterative realign assumes the pivot lean can actually rotate the
# chassis. That assumption breaks when the bot is STATIONARY (friction
# locks the wheels in place; commanded lean changes the goal positions
# but the chassis doesn't move). Symptom in the log: a streak of
# realigns that all exit with reason "no progress" and ``drift_now``
# essentially equal to ``drift_start``. With the default 1 s (forward)
# or 0.3 s (backward) cooldown, the next correction fires immediately
# after the failed one, never giving the pulse loop enough uninterrupted
# time to build wheel momentum and break the chassis free.
#
# The stuck detector counts consecutive "no progress" exits across
# realigns. When the count reaches ``STUCK_STREAK`` the next cooldown
# is replaced with ``STUCK_COOLDOWN_SEC`` (much longer) so the pulse
# loop gets a clean window to drive the chassis. Any non-no-progress
# exit (deadband reached, overshoot past zero, wrong-direction bail,
# max-steps cap) resets the streak immediately. The streak is also
# reset at the start of every fresh straight leg (see
# ``_imu_begin_straight``).
# ----------------------------------------------------------------------


def _imu_corr_stuck_streak() -> int:
    """Consecutive ``no progress`` exits before the stuck cooldown kicks in.

    Read from ``NINA_HOVER_IMU_CORR_STUCK_STREAK``. Default 3 — a single
    no-progress exit is usually a transient drift burst, but 3 in a row
    is a strong signal the pivots aren't rotating the chassis at all
    (typically because the bot is stationary). Set to 0 to disable the
    stuck detector and fall back to the legacy "always use the
    direction-aware cooldown" behaviour.

    Clamped to ``[0, 50]``.
    """
    try:
        return max(
            0,
            min(50, int(float(os.environ.get("NINA_HOVER_IMU_CORR_STUCK_STREAK", "3")))),
        )
    except ValueError:
        return 3


def _imu_corr_stuck_cooldown_sec() -> float:
    """Cooldown applied when the stuck detector fires (seconds).

    Read from ``NINA_HOVER_IMU_CORR_STUCK_COOLDOWN_SEC``. Default 8.0 —
    long enough for the pulse loop to complete at least one full hold
    cycle (typically 1-2 s per cycle on the default ``pulse_series_*``
    settings) so the chassis can actually build wheel momentum and
    break out of the stationary state. Field testing showed 8 s lets
    the bot translate noticeably further between stuck cycles than the
    previous 5 s default. Lower this if the bot ends up drifting too
    far during the stuck window; raise it if the bot still can't break
    free.

    Clamped to ``[0.0, 60.0]``.
    """
    try:
        return max(
            0.0,
            min(60.0, float(os.environ.get("NINA_HOVER_IMU_CORR_STUCK_COOLDOWN_SEC", "8.0"))),
        )
    except ValueError:
        return 8.0


# ----------------------------------------------------------------------
# Drift-corrected straight forward (replaces the pulse-series + in-motion
# realign for forward motion). The chassis drives in fixed-duration legs
# (NINA_HOVER_STRAIGHT_LEG_SEC each) separated by brake + settle dwells.
# Drift is read at standstill after every leg — much more reliable than
# during motion because the integrator is no longer racing with active
# wheel rotation. Above ABORT_DRIFT_DEG the bot speaks the cant_move
# alert and halts.
# ----------------------------------------------------------------------


def _straight_leg_sec() -> float:
    """Forward-leg duration (seconds) between brake + drift-check pauses.

    Each press of Straight forward (or D-pad forward in pulse mode)
    drives the chassis at full FWD lean for this duration, brakes,
    samples drift, optionally corrects, and repeats until the operator
    releases the button.

    Default 0.5 s. The reference chassis accumulates ~10–25° of drift
    in a 1 s leg (the 0.5 s default halves the per-cycle drift the
    correction loop has to chase, keeps each unsupervised excursion
    short, and roughly doubles the rate of drift sampling). Clamped
    to ``[0.1, 5.0]`` — override with
    ``NINA_HOVER_STRAIGHT_LEG_SEC=<seconds>``.
    """
    try:
        return max(
            0.1,
            min(5.0, float(os.environ.get("NINA_HOVER_STRAIGHT_LEG_SEC", "0.5"))),
        )
    except ValueError:
        return 0.5


def _straight_back_leg_sec() -> float:
    """Backward-leg duration (seconds) between brake + drift-check pauses.

    Mirror of :func:`_straight_leg_sec` but scoped to *backward*
    motion. Default **0.5 s** (matches forward) — once the per-side
    asymmetric trim
    (:func:`_straight_back_left_ticks_offset` /
    :func:`_straight_back_right_ticks_offset`) compensates for the
    BLDC-side wheel asymmetry, backward travels at a similar
    rate to forward and there's no reason to make legs longer.

    Independent of :func:`_straight_leg_sec` — overriding one direction
    must not bleed into the other. Clamped to ``[0.1, 5.0]``. Override
    with ``NINA_HOVER_STRAIGHT_BACK_LEG_SEC=<seconds>``.
    """
    try:
        return max(
            0.1,
            min(
                5.0,
                float(
                    os.environ.get("NINA_HOVER_STRAIGHT_BACK_LEG_SEC", "0.5")
                ),
            ),
        )
    except ValueError:
        return 0.5


def _straight_brake_settle_sec() -> float:
    """Brake settle dwell after each forward leg, before sampling drift.

    Lets the chassis stop rotating from any residual motion so the IMU
    integrator sample is a clean post-leg drift measurement. Default
    0.30 s. Clamped to ``[0.0, 2.0]``.
    """
    try:
        return max(
            0.0,
            min(
                2.0,
                float(os.environ.get("NINA_HOVER_STRAIGHT_BRAKE_SETTLE_SEC", "0.30")),
            ),
        )
    except ValueError:
        return 0.30


def _imu_corr_swap_pivot_dir() -> bool:
    """Deprecated alias for :func:`_imu_turn_swap_pivot_dir`.

    Yaw correction (standstill and in-motion) picks pivot goals with the
    same ``remaining``-sign rule as held D-pad L/R. Prefer
    ``NINA_HOVER_TURN_SWAP_PIVOT_DIR``; this env var is ignored unless set
    explicitly for backward compatibility on older deploys.
    """
    if "NINA_HOVER_IMU_CORR_SWAP_PIVOT_DIR" not in os.environ:
        return _imu_turn_swap_pivot_dir()
    val = os.environ["NINA_HOVER_IMU_CORR_SWAP_PIVOT_DIR"]
    return val.strip().lower() not in ("0", "false", "no", "off", "")


def _explicit_yaw_corr_swap_pivot() -> Optional[bool]:
    """Legacy per-path swap overrides; ``None`` → use turn swap default."""
    if "NINA_HOVER_STRAIGHT_CORR_SWAP_PIVOT_DIR" in os.environ:
        return _straight_corr_swap_pivot_dir()
    if "NINA_HOVER_IMU_CORR_SWAP_PIVOT_DIR" in os.environ:
        return _imu_corr_swap_pivot_dir()
    return None


def _straight_corr_swap_pivot_dir() -> bool:
    """Deprecated alias for :func:`_imu_turn_swap_pivot_dir`.

    Standstill drift correction uses the same pivot-goal rule as held
    D-pad L/R. Prefer ``NINA_HOVER_TURN_SWAP_PIVOT_DIR``; this env var is
    only honoured when set explicitly (remove ``=1`` from older deploys
    that added it while debugging wrong-way correction).
    """
    if "NINA_HOVER_STRAIGHT_CORR_SWAP_PIVOT_DIR" not in os.environ:
        return _imu_turn_swap_pivot_dir()
    val = os.environ["NINA_HOVER_STRAIGHT_CORR_SWAP_PIVOT_DIR"]
    return val.strip().lower() not in ("0", "false", "no", "off", "")


def _straight_settle_rate_dps() -> float:
    """Yaw-rate threshold (deg/s) below which the chassis is "still".

    The drift-corrected forward loop polls the IMU's instantaneous yaw
    rate after braking; once ``|rate|`` drops below this for
    ``SETTLE_STABLE_SEC`` continuous, the chassis is treated as
    stationary and we can sample drift / start a correction step.
    Default **3.0 °/s** — small enough that any residual rotation
    won't corrupt the drift sample over the next sampling window,
    large enough not to chase gyro noise on a quiet IMU. Clamped to
    ``[0.1, 30.0]``.
    """
    try:
        return max(
            0.1,
            min(
                30.0,
                float(os.environ.get("NINA_HOVER_STRAIGHT_SETTLE_RATE_DPS", "3.0")),
            ),
        )
    except ValueError:
        return 3.0


def _straight_settle_stable_sec() -> float:
    """Continuous window (seconds) the yaw rate must stay below the
    settle threshold before the chassis is declared still.

    Default **0.10 s** — a 100 ms quiet window filters out brief gyro
    noise dips without forcing the loop to wait excessively after a
    real stop. Clamped to ``[0.0, 2.0]`` (set to 0 to declare stillness
    on a single sub-threshold sample).
    """
    try:
        return max(
            0.0,
            min(
                2.0,
                float(
                    os.environ.get("NINA_HOVER_STRAIGHT_SETTLE_STABLE_SEC", "0.10")
                ),
            ),
        )
    except ValueError:
        return 0.10


def _straight_settle_max_sec() -> float:
    """Hard cap (seconds) on the active-settle wait before bailing.

    If the chassis hasn't settled within this many seconds after a
    brake command, the loop logs a warning, skips the drift sample
    for this cycle, and moves on to the next forward leg rather than
    sampling stale / moving-chassis drift. Default **1.50 s** —
    several times longer than a normal hoverboard stops but short
    enough that a stuck wheel or runaway condition doesn't block the
    loop indefinitely. Clamped to ``[0.05, 10.0]``.
    """
    try:
        return max(
            0.05,
            min(
                10.0,
                float(os.environ.get("NINA_HOVER_STRAIGHT_SETTLE_MAX_SEC", "1.50")),
            ),
        )
    except ValueError:
        return 1.50


def _straight_settle_poll_sec() -> float:
    """Polling interval (seconds) for the active-settle yaw-rate loop.

    Default **0.02 s** = 50 Hz. Matches the typical MPU-9250 sample
    cadence so we don't oversample stale values nor under-sample and
    miss a brief sub-threshold window. Clamped to ``[0.001, 0.5]``.
    """
    try:
        return max(
            0.001,
            min(
                0.5,
                float(os.environ.get("NINA_HOVER_STRAIGHT_SETTLE_POLL_SEC", "0.02")),
            ),
        )
    except ValueError:
        return 0.02


def _straight_corr_blend_pct() -> int:
    """Standstill drift-correction micro-step blend % — always full pivot."""
    return _PIVOT_MICROSTEP_BLEND_PCT


def _straight_corr_step_dur_cap_sec() -> float:
    """Per-step pivot duration cap (seconds) for drift correction.

    Each correction step pivots at the configured blend for
    ``min(cap, max(step_min, |drift| / step_rate_dps))`` seconds.

    Default **0.030 s** — matches ``step_min`` so every correction
    step is the same controlled magnitude. Bigger drifts converge
    by doing *more* equal-sized kicks (with active-settle + drift
    re-sample between each) rather than one over-strong kick. The
    earlier 0.05 s cap meant a 7° drift fired one 0.05 s kick that,
    with the chassis's pre-correction momentum getting released,
    produced 10–26° of rotation and badly overshot. Forcing every
    kick to 0.030 s caps that release energy regardless of drift
    magnitude.

    The legacy ``NINA_HOVER_IMU_CORR_PIVOT_MAX_SEC`` (0.18 s, for
    the 20%-blend in-motion backward correction) is **not** changed
    by this knob. Bump back up if a chassis pivots so slowly that
    even 0.030 s isn't enough to make progress; reduce further if
    it over-rotates per step. Clamped to ``[0.005, 1.0]``.
    """
    try:
        return max(
            0.005,
            min(
                1.0,
                float(
                    os.environ.get("NINA_HOVER_STRAIGHT_CORR_STEP_DUR_CAP_SEC", "0.030")
                ),
            ),
        )
    except ValueError:
        return 0.030


def _straight_corr_step_min_sec() -> float:
    """Per-step pivot duration floor (seconds) for drift correction.

    Default **0.030 s** — empirically the smallest single kick that
    reliably overcomes chassis static friction + asymmetric
    forward-leg residual on the reference chassis. Field log showed
    a 0.044 s kick achieving 5.23° of clean rotation (cycle 1 of a
    test run), while clusters of 0.015 s kicks rocked the chassis
    unpredictably — some steps moved the right way, others the wrong
    way, often netting a *worse* drift after 15 attempts. The 0.030 s
    floor sits in the proven-reliable regime.

    Paired with the target-zero step-duration formula and the 3.0°
    deadband, every correction that fires is a single decisive kick
    (or at most two for drifts >7°) instead of a 15-step chase that
    fights the chassis bias. Slight overshoot into the opposite-
    direction half of the deadband is bounded and absorbed on the
    next leg's drift sample.

    The legacy ``NINA_HOVER_IMU_CORR_STEP_MIN_SEC`` (0.08 s, tuned
    for 20%-blend in-motion correction) is **not** changed by this
    knob. Clamped to ``[0.005, 1.0]``.
    """
    try:
        return max(
            0.005,
            min(
                1.0,
                float(
                    os.environ.get("NINA_HOVER_STRAIGHT_CORR_STEP_MIN_SEC", "0.030")
                ),
            ),
        )
    except ValueError:
        return 0.030


def _straight_corr_back_step_dur_cap_sec() -> float:
    """Per-step pivot duration cap (seconds) for **backward** drift correction.

    Mirror of :func:`_straight_corr_step_dur_cap_sec` but scoped to
    correction cycles that fire after a *backward* leg. Default
    **0.020 s** vs the forward default **0.030 s** — field testing
    on the reference chassis showed the same 0.030 s kick that
    produces a clean ~2.5° rotation when correcting from a forward
    leg produces 5–8° of rotation when correcting from a backward
    leg (same step blend, step rate, brake settle — only the prior
    leg direction differs). The mechanical explanation: the
    pre-pivot momentum profile is asymmetric on this chassis, so
    the calibrated 84 dps step rate underestimates the actual
    backward-correction rotation rate, and the empirical floor of
    0.030 s ends up over-pushing per step on backward.

    Independent of :func:`_straight_corr_step_dur_cap_sec` so the
    operator can tune forward and backward correction separately —
    the forward path is unaffected by overrides to this knob, and
    vice versa. Forward defaults stay 0.030 s; backward defaults
    drop to 0.020 s.

    Pair with :func:`_straight_corr_back_step_min_sec` (default
    0.015 s) so the proportional formula
    ``max(min, min(cap, |drift|/rate))`` actually shrinks for small
    drifts on backward (with the forward 0.030/0.030 the formula
    floors and caps at the same value, defeating proportional
    scaling). Clamped to ``[0.005, 1.0]``.
    """
    try:
        return max(
            0.005,
            min(
                1.0,
                float(
                    os.environ.get(
                        "NINA_HOVER_STRAIGHT_CORR_BACK_STEP_DUR_CAP_SEC", "0.020"
                    )
                ),
            ),
        )
    except ValueError:
        return 0.020


def _straight_corr_back_step_min_sec() -> float:
    """Per-step pivot duration floor (seconds) for **backward** drift correction.

    Mirror of :func:`_straight_corr_step_min_sec` but scoped to
    correction cycles that fire after a *backward* leg. Default
    **0.015 s** vs the forward default **0.030 s**. See
    :func:`_straight_corr_back_step_dur_cap_sec` for the chassis-
    asymmetry rationale; in short, the backward correction
    over-pushes at the forward floor, so backward needs a lower
    floor to let the proportional formula actually scale small
    drifts down.

    Independent of :func:`_straight_corr_step_min_sec` — the forward
    path is unaffected by overrides here. Clamped to ``[0.005, 1.0]``.
    """
    try:
        return max(
            0.005,
            min(
                1.0,
                float(
                    os.environ.get(
                        "NINA_HOVER_STRAIGHT_CORR_BACK_STEP_MIN_SEC", "0.015"
                    )
                ),
            ),
        )
    except ValueError:
        return 0.015


def _straight_corr_step_rate_dps() -> float:
    """Expected chassis pivot rate (deg/s) used to size each step's duration.

    The standstill correction picks each step's duration as
    ``|drift| / step_rate_dps`` (clamped to ``[step_min, step_dur_cap]``).
    Default **84 °/s** — empirical 140 °/s at 100% lean scaled by
    the 60% default blend (``140 × 0.60 = 84``). Tune per chassis
    *and* per blend: do one full-blend pivot pulse at the blend
    you're using, measure ``Δyaw / pulse_sec``, plug it in.

    Note this value is mostly cosmetic now that ``step_min`` and
    ``step_dur_cap`` are both 0.030 s by default — every kick is
    clamped to 0.030 s regardless of what the formula computes. The
    rate still matters if you raise the cap or lower the floor.

    The legacy ``NINA_HOVER_IMU_CORR_STEP_RATE_DPS`` (30 °/s, tuned
    for 20%-blend in-motion backward correction) is **not** changed
    by this knob. Clamped to ``[1.0, 500.0]``.
    """
    try:
        return max(
            1.0,
            min(
                500.0,
                float(
                    os.environ.get("NINA_HOVER_STRAIGHT_CORR_STEP_RATE_DPS", "84.0")
                ),
            ),
        )
    except ValueError:
        return 84.0


def _straight_corr_residual_deg() -> float:
    """Drift magnitude (deg) at which the correction loop EXITS.

    Decouples the *trigger* threshold (``deadband``) from the *exit*
    threshold so the bot doesn't stop correcting at the deadband
    edge and leave 2–3° of residual heading drift that compounds
    cycle-after-cycle into a mild curve. Once correction fires
    (because ``|drift| > deadband``), it continues until
    ``|drift| <= residual`` — i.e. all the way back to near zero.

    Default **1.0°**. This is hysteresis: drift can wander up to
    ``deadband`` (3.0°) before correction fires, then is pulled
    back inside ``residual`` (1.0°) — giving a 2° "buffer" before
    the next correction can fire and preventing chattering at the
    boundary.

    Should be < ``deadband`` (otherwise correction enters then
    immediately exits). Clamped to ``[0.1, 30.0]``.

    Override via ``NINA_HOVER_STRAIGHT_CORR_RESIDUAL_DEG=<deg>``.
    """
    try:
        return max(
            0.1,
            min(
                30.0,
                float(
                    os.environ.get("NINA_HOVER_STRAIGHT_CORR_RESIDUAL_DEG", "1.0")
                ),
            ),
        )
    except ValueError:
        return 1.0


def _straight_corr_deadband_deg() -> float:
    """Drift magnitude (deg) below which no correction step fires.

    Default **3.0°** — a compromise between responsiveness (catch
    drifts before they're visible to the operator: steady-state
    per-leg drift on the reference chassis is ±1–2°, so 3.0° is
    well above noise) and not chasing noise.

    Paired with the **target-zero** step-duration formula (aim to
    land at zero drift, not at half-deadband short of zero) the
    minimum auto-computed step duration at deadband-edge is now
    3.0° / 140 dps = 0.021 s — comfortably above the 0.015 s floor,
    so every correction that DOES fire is a single decisive kick
    that overcomes chassis stiction. Slight overshoot past zero is
    bounded by the deadband (next sample exits naturally).

    Historical defaults: legacy in-motion 1.5°; this knob shipped at
    2.5° (chased noise); then 3.5° (catch the wobble at fag-end);
    now 3.0° + zero-target formula.

    The legacy ``NINA_HOVER_IMU_CORR_DEADBAND_DEG`` (1.5°) is **not**
    changed by this knob — backward and the in-motion correction
    keep their finer deadband. Clamped to ``[0.1, 30.0]``.
    """
    try:
        return max(
            0.1,
            min(
                30.0,
                float(
                    os.environ.get("NINA_HOVER_STRAIGHT_CORR_DEADBAND_DEG", "3.0")
                ),
            ),
        )
    except ValueError:
        return 3.0


def _straight_bench_cycles() -> int:
    """Forward-leg cycle count used to size the Straight bench watchdog.

    The drift-corrected forward loop has no natural upper bound — it
    cycles for as long as the operator holds the button. The bench
    "Straight forward" command still needs a max-duration watchdog,
    so we cap it at ``NINA_HOVER_STRAIGHT_BENCH_CYCLES``
    (default **12**) × ``(leg + brake_settle)``. Clamped to
    ``[1, 60]``.
    """
    try:
        return max(
            1,
            min(
                60,
                int(os.environ.get("NINA_HOVER_STRAIGHT_BENCH_CYCLES", "12")),
            ),
        )
    except ValueError:
        return 12


def _straight_abort_drift_deg() -> float:
    """Drift magnitude (deg) above which the straight loop halts + speaks.

    When the post-leg drift sample crosses this threshold, the loop
    brakes the chassis, queues the bundled ``cant_move.mp3`` alert via
    :func:`nina.services.sensor_alert_audio.maybe_speak_cant_move_alert`,
    sets the pulse halt event, and exits. The operator must issue a
    fresh drive command to resume. Default 90° — the bot can't
    realistically come back from a half-rotation accumulated in one
    1 s leg, and continuing would only spin further. Set 0 to disable
    the abort. Clamped to ``[0.0, 180.0]``.
    """
    try:
        return max(
            0.0,
            min(
                180.0,
                float(os.environ.get("NINA_HOVER_STRAIGHT_ABORT_DRIFT_DEG", "90.0")),
            ),
        )
    except ValueError:
        return 90.0


def _imu_corr_abort_drift_deg() -> float:
    """Drift magnitude (deg) above which a pulse leg aborts with a spoken alert.

    Read from ``NINA_HOVER_IMU_CORR_ABORT_DRIFT_DEG``. Default 30.0 — well
    past the largest drift the iterative realign has been observed to
    recover from on the production chassis (~26°), but small enough to
    catch a runaway spin within one or two correction cycles. Set to
    ``0`` (or any non-positive value) to disable the abort entirely and
    fall back to the legacy "let the realign keep retrying" behaviour.

    When the abort fires, ``_imu_corrective_hold`` brakes, sets the pulse
    halt event so the pulse loop exits cleanly, and queues a single
    :data:`_IMU_CORR_ABORT_PHRASE` TTS announcement via
    :func:`nina.services.sensor_alert_audio.maybe_speak_cant_move_alert` (which
    enforces its own per-message cooldown so back-to-back aborts in the
    same leg do not chatter). The operator must issue a fresh drive
    command to resume — there is no automatic retry.

    Clamped to ``[0.0, 180.0]``.
    """
    try:
        return max(
            0.0,
            min(
                180.0,
                float(
                    os.environ.get("NINA_HOVER_IMU_CORR_ABORT_DRIFT_DEG", "30.0")
                ),
            ),
        )
    except ValueError:
        return 30.0


def _hover_turn_slow_wheel_pct() -> int:
    """Backward-side lean for held D-pad pivots (1–100, default 8)."""
    try:
        return max(1, min(100, int(os.environ.get("NINA_HOVER_TURN_SLOW_WHEEL_PCT", "8"))))
    except ValueError:
        return 8


def _drive_turn_micro_step_deg() -> float:
    """Yaw budget (deg) for one held D-pad L/R step or one Turn left/right click."""
    deg_raw = (os.environ.get("NINA_DRIVE_TURN_PIVOT_DEG") or "15").strip()
    if deg_raw:
        try:
            return max(1.0, min(45.0, float(deg_raw)))
        except ValueError:
            pass
    return 15.0


def _timed_turn_pivot_blend_pct() -> int:
    """Timed ``turn_left`` / ``turn_right`` blend % — always full pivot."""
    return _PIVOT_MICROSTEP_BLEND_PCT


# ----------------------------------------------------------------------
# Closed-loop 90° turn (Drive screen "Turn left" / "Turn right" buttons)
#
# These knobs configure :meth:`HoverboardAxisDrive.pulse_turn_90`, which
# reuses the iterative proportional micro-step algorithm from
# :meth:`_perform_pivot_correction` — same per-step geometry
# (``_goals_for_wheels`` with opposite leans), same per-step duration
# formula (``rotation_target / step_rate_dps`` clamped to
# ``[step_min, step_dur_cap]``), same brake-between-steps for clean IMU
# re-sampling — but DRIVEN BY A YAW BUDGET (target ±90°) rather than
# straight-line drift correction.
#
# Defaults are intentionally close to the forward straight-leg correction
# values so a fresh deploy inherits the tuning the operator has already
# validated for forward motion; only knobs that are genuinely
# turn-specific (target deg, step cap headroom, settle dwells, progress
# / fallback) get their own env name.
# ----------------------------------------------------------------------


def _imu_turn_target_deg() -> float:
    """Yaw budget (deg) the closed-loop turn must traverse.

    Default 90.0 — the operator-facing "Turn left" / "Turn right" buttons
    are documented as 90° turns. Override only for special calibration
    runs (e.g. 45° staircase profiles); clamped to ``[5.0, 180.0]`` so a
    typo can't request more than half a full rotation.
    """
    try:
        return max(
            5.0,
            min(180.0, float(os.environ.get("NINA_HOVER_TURN_TARGET_DEG", "90.0"))),
        )
    except ValueError:
        return 90.0


def _imu_turn_max_steps() -> int:
    """Hard cap on micro-steps inside one closed-loop 90° turn.

    A 90° target at the default 30 deg/s step rate × 0.18 s cap rotates
    up to ~5.4°/step at saturation, so ~17 saturated steps would cover
    90° before any deceleration / fine-tuning at the end. Default 40
    leaves comfortable headroom for proportional slow-down near the
    target plus a few extra for noisy IMU samples or a sticky chassis.
    """
    try:
        return max(
            1,
            min(200, int(float(os.environ.get("NINA_HOVER_TURN_MAX_STEPS", "40")))),
        )
    except ValueError:
        return 40


def _imu_turn_step_rate_deg_per_sec() -> float:
    """Empirical chassis rotation rate (deg/s) for closed-loop turns.

    Default **22 dps** (gentler than in-motion IMU correction's 30 dps).
    Override with ``NINA_HOVER_TURN_STEP_RATE_DEG_PER_SEC``.
    """
    raw = (os.environ.get("NINA_HOVER_TURN_STEP_RATE_DEG_PER_SEC") or "").strip()
    if raw:
        try:
            return max(1.0, min(360.0, float(raw)))
        except ValueError:
            pass
    return 22.0


def _turn_step_dur_cap_sec() -> float:
    """Per-micro-step lean hold cap for D-pad / Turn closed-loop pivots.

    Default **0.26 s** (vs ``NINA_HOVER_IMU_CORR_PIVOT_MAX_SEC`` 0.18 s for
    in-motion correction). Override ``NINA_HOVER_TURN_STEP_DUR_CAP_SEC``.
    """
    try:
        return max(
            0.02,
            min(3.0, float(os.environ.get("NINA_HOVER_TURN_STEP_DUR_CAP_SEC", "0.26"))),
        )
    except ValueError:
        return 0.26


def _turn_step_min_sec() -> float:
    """Floor on per-step lean hold for closed-loop turns. Default **0.10 s**."""
    try:
        return max(
            0.01,
            min(1.0, float(os.environ.get("NINA_HOVER_TURN_STEP_MIN_SEC", "0.10"))),
        )
    except ValueError:
        return 0.10


def _turn_step_settle_sec() -> float:
    """Brake dwell between closed-loop turn micro-steps. Default **0.12 s**."""
    try:
        return max(
            0.0,
            min(1.0, float(os.environ.get("NINA_HOVER_TURN_STEP_SETTLE_SEC", "0.12"))),
        )
    except ValueError:
        return 0.12


def _imu_turn_step_blend_pct() -> int:
    """Closed-loop 90° turn micro-step blend % — always full pivot."""
    return _PIVOT_MICROSTEP_BLEND_PCT


def _held_dpad_pivot_blend_pct() -> int:
    """Blend % for held D-pad L/R micro-steps (``pulse_turn_micro_step``)."""
    return _HELD_DPAD_PIVOT_BLEND_PCT


def _straight_corr_max_drift_correct_deg() -> float:
    """Skip standstill micro-pivots during saved sequences when |drift| exceeds this.

    After a bad turn the cumulative heading error can be tens or hundreds of
    degrees; iterative correction pivots every 0.5 s leg will overload the
    BLDC motors. During :meth:`HoverboardAxisDrive.begin_saved_sequence` the
    straight loop logs a warning and skips correction until the next leg.

    Default **45°**. Override ``NINA_HOVER_STRAIGHT_CORR_MAX_DRIFT_CORRECT_DEG``.
    """
    try:
        return max(
            5.0,
            min(
                180.0,
                float(
                    os.environ.get(
                        "NINA_HOVER_STRAIGHT_CORR_MAX_DRIFT_CORRECT_DEG", "45.0"
                    )
                ),
            ),
        )
    except ValueError:
        return 45.0


def _sequence_turn_max_steps_for_deg(target_deg: float) -> int:
    """Cap closed-loop turn steps during saved movement sequences.

    Uses the same per-step yaw budget as straight drift correction
    (``NINA_HOVER_STRAIGHT_CORR_STEP_DEG``) so a 180° U-turn needs at most
    ~36 micro-steps, not the 160 steps a raw 360°/90° scaling would allow.
    """
    per_step = _straight_corr_step_deg()
    return max(3, min(80, int(round(float(target_deg) / per_step)) + 2))


def _hold_turn_dir_for_remaining(remaining_intent_deg: float) -> str:
    """Map signed remaining yaw (intent frame) to ``'left'`` / ``'right'`` micro-step.

    Must follow the sign of ``remaining``, not the operator's original turn
    label — otherwise a saved U-turn that overshoots keeps applying the same
    pivot direction and the chassis can spin in place at high speed.
    """
    swap = _imu_turn_swap_pivot_dir()
    pivot_right = float(remaining_intent_deg) > 0.0
    apply_right = not pivot_right if swap else pivot_right
    return "right" if apply_right else "left"


def _turn_overshoot_abort_margin_deg(target_deg: float, *, sequence: bool) -> float:
    """Max |yaw| past the turn target before the spin guard fires.

    Default: sequence **+35°** on top of target (180° → stop by 215° intent yaw);
    manual turns **+50°**. Override ``NINA_HOVER_TURN_OVERSHOOT_ABORT_DEG`` or
    ``NINA_HOVER_SEQUENCE_TURN_OVERSHOOT_ABORT_DEG``.
    """
    env_key = (
        "NINA_HOVER_SEQUENCE_TURN_OVERSHOOT_ABORT_DEG"
        if sequence
        else "NINA_HOVER_TURN_OVERSHOOT_ABORT_DEG"
    )
    default = 35.0 if sequence else 50.0
    try:
        return max(10.0, min(120.0, float(os.environ.get(env_key, str(default)))))
    except ValueError:
        return default


def _spin_abort_rate_dps() -> float:
    """Abort closed-loop turns when |yaw rate| stays above this (deg/s).

    Catches runaway in-place spins that outpace per-step settle. Default **45**.
    Set ``0`` to disable. Override ``NINA_HOVER_SPIN_ABORT_RATE_DPS``.
    """
    try:
        return max(
            0.0,
            min(
                200.0,
                float(os.environ.get("NINA_HOVER_SPIN_ABORT_RATE_DPS", "45.0")),
            ),
        )
    except ValueError:
        return 45.0


def _sequence_straight_abort_drift_deg() -> float:
    """Straight-leg drift abort during saved sequences (tighter than kiosk default).

    Default **45°** vs ``NINA_HOVER_STRAIGHT_ABORT_DRIFT_DEG`` 90° on Drive.
    Override ``NINA_HOVER_SEQUENCE_STRAIGHT_ABORT_DRIFT_DEG``.
    """
    try:
        return max(
            0.0,
            min(
                180.0,
                float(
                    os.environ.get(
                        "NINA_HOVER_SEQUENCE_STRAIGHT_ABORT_DRIFT_DEG", "45.0"
                    )
                ),
            ),
        )
    except ValueError:
        return 45.0


def _straight_corr_step_deg() -> float:
    """Yaw budget per standstill drift-correction step (straight FWD/BACK only).

    Smaller than :func:`_drive_turn_micro_step_deg` (held D-pad L/R and Turn click)
    so each correction bite is gentler and less likely to oscillate past zero.
    Lean goals still match held L/R at 30% blend; only hold duration scales with
    this angle via :func:`_hold_turn_step_duration_sec`.

    Default **2.5°** (half the prior 5° default; vs 15° operator turn micro-step).
    Override ``NINA_HOVER_STRAIGHT_CORR_STEP_DEG``.
    """
    raw = (os.environ.get("NINA_HOVER_STRAIGHT_CORR_STEP_DEG") or "").strip()
    if raw:
        try:
            return max(1.0, min(15.0, float(raw)))
        except ValueError:
            pass
    return 2.5


def _hold_turn_step_duration_sec(rotation_deg: Optional[float] = None) -> float:
    """Lean-hold duration from a yaw budget, turn step rate, cap, and floor.

    Held L/R and Turn micro-steps pass ``NINA_DRIVE_TURN_PIVOT_DEG`` (default 15°).
    Straight FWD/BACK drift correction passes :func:`_straight_corr_step_deg`
    (default 2.5°) so each correction rotates less per step than operator turns.
    """
    if rotation_deg is None:
        rotation_deg = _drive_turn_micro_step_deg()
    target = max(0.5, abs(float(rotation_deg)))
    rate = _imu_turn_step_rate_deg_per_sec()
    cap = _turn_step_dur_cap_sec()
    floor = _turn_step_min_sec()
    return max(floor, min(cap, target / rate))


def _imu_turn_pre_settle_sec() -> float:
    """Brake dwell BEFORE the first micro-step fires.

    Lets any forward / backward pulse leg we just halted bleed off
    chassis momentum so the integrator anchors a stable zero. Default
    0.28 s — long enough for the MX-28 to land on brake before the first
    lean step without feeling sluggish on held D-pad turns.
    """
    try:
        return max(
            0.0,
            min(2.0, float(os.environ.get("NINA_HOVER_TURN_PRE_SETTLE_SEC", "0.28"))),
        )
    except ValueError:
        return 0.28


def _imu_turn_post_settle_sec() -> float:
    """Brake dwell AFTER the last micro-step fires.

    Holds the bot stationary after reaching the target so the chassis
    doesn't keep rotating from residual lean momentum (the lean servos
    are commanded to brake but the wheels coast a touch). Default
    0.40 s.
    """
    try:
        return max(
            0.0,
            min(2.0, float(os.environ.get("NINA_HOVER_TURN_POST_SETTLE_SEC", "0.40"))),
        )
    except ValueError:
        return 0.40


def _imu_turn_progress_check_steps() -> int:
    """Steps to run before the closed-loop turn checks for progress.

    Same idea as :func:`_imu_corr_progress_check_steps` but tuned for
    the much larger angular budget (90° vs ~5°): default 6 lets the
    realign do real work before bailing on "no progress" exits. Set 0
    to disable the check entirely.
    """
    try:
        return max(
            0,
            min(50, int(float(os.environ.get("NINA_HOVER_TURN_PROGRESS_CHECK_STEPS", "6")))),
        )
    except ValueError:
        return 6


def _imu_turn_progress_min_deg() -> float:
    """Minimum |yaw| advance (deg) required by ``PROGRESS_CHECK_STEPS``.

    Default 3.0° — at the saturated 5.4°/step rotation rate this is half
    a step's worth; if the chassis hasn't moved that much in 6 steps the
    pivots aren't actually rotating it (stuck wheel, no torque, etc.).
    """
    try:
        return max(
            0.0,
            min(45.0, float(os.environ.get("NINA_HOVER_TURN_PROGRESS_MIN_DEG", "3.0"))),
        )
    except ValueError:
        return 3.0


def _imu_turn_swap_pivot_dir() -> bool:
    """Swap the pivot-direction-to-goals mapping in the closed-loop 90° turn.

    Same chassis-physics fix as :func:`_straight_corr_swap_pivot_dir`,
    but scoped to :meth:`HoverboardAxisDrive.pulse_turn_90` and the
    timed :meth:`HoverboardAxisDrive.turn_left` /
    :meth:`HoverboardAxisDrive.turn_right` fallback. On the reference
    chassis, commanding what the code labels "pivot LEFT" (L=FWD,
    R=BACK at the dynamixel-lean level) physically rotates the
    chassis to the **RIGHT** (CW), not the left as the label
    suggests. The 90° turn is in-place, so the same mapping question
    applies — without the swap, pressing "Turn Left" on the operator
    UI commands ``L=FWD, R=BACK`` and the chassis rotates right
    (then the no-progress safeguard bails the turn).

    When True, a turn-LEFT request applies ``L=BACK, R=FWD`` goals and a
    turn-RIGHT request applies ``L=FWD, R=BACK`` goals — i.e. the
    label-to-goals mapping is inverted relative to the conventional
    convention. Default **off** after the fleet hall FWD/REV swap;
    set ``NINA_HOVER_TURN_SWAP_PIVOT_DIR=1`` if timed / closed-loop
    turns still rotate the wrong way.

    Independent of :func:`_straight_corr_swap_pivot_dir` so the
    operator can tune turn vs standstill correction separately;
    defaults match because the same chassis-physics fix applies to
    both.

    Unrelated to ``NINA_HOVER_IMU_CORR_INVERT_SIGN`` — that knob
    flips the **integrator sign interpretation** (whether positive
    yaw means CW or CCW). This knob flips the **pivot command
    mapping** (whether a chassis-frame "right" turn uses one set of
    goals or the other). On chassis with both inversions you'd set
    both.
    """
    val = os.environ.get("NINA_HOVER_TURN_SWAP_PIVOT_DIR", "0")
    return val.strip().lower() not in ("0", "false", "no", "off", "")


def _counter_drift_pivot_remaining_deg(effective_drift_deg: float) -> float:
    """Intent-frame remaining yaw for one counter-drift micro-pivot.

    Positive *effective_drift_deg* means the chassis has yawed right and
    needs a physical left correction. On the reference mount with
    ``NINA_HOVER_TURN_SWAP_PIVOT_DIR=0`` (the default), that physical
    left rotation is a **positive** remaining (``L=BACK, R=FWD`` via
    :meth:`HoverboardAxisDrive._pivot_step_goals_for_remaining`); with
    swap enabled the same pose is a **negative** remaining. Mapping through
    remaining keeps counter-yaw correct regardless of the D-pad label swap.
    """
    if _imu_turn_swap_pivot_dir():
        return -effective_drift_deg
    return effective_drift_deg


def estimate_forward_pulse_series_duration_sec(axis: HoverboardAxisSettings) -> float:
    """Bench watchdog upper-bound for the drift-corrected forward loop.

    The new :meth:`HoverboardAxisDrive.start_pulse_straight_forward`
    has no fixed series count — it cycles forward-leg → brake → drift
    check until the operator releases the button (or the 90° abort
    fires). For bench tests we still need a finite watchdog, so this
    helper returns::

        prime_timeout + bench_cycles × (leg_sec + brake_settle_sec)

    using the new ``NINA_HOVER_STRAIGHT_*`` env getters. Increase
    ``NINA_HOVER_STRAIGHT_BENCH_CYCLES`` (default 12) for a longer
    run, or set ``NINA_STRAIGHT_TEST_MS`` to bypass this estimate
    entirely from the bench UI.

    The ``axis`` argument is unused (kept for signature compatibility
    with :func:`estimate_backward_pulse_series_duration_sec`, which
    now uses the same drift-corrected algorithm and the same formula).
    """
    _ = axis  # reserved for compatibility
    cycles = _straight_bench_cycles()
    leg = _straight_leg_sec()
    settle = _straight_brake_settle_sec()
    prime = _straight_prime_timeout_sec()
    return prime + float(cycles) * (leg + settle)


def estimate_backward_pulse_series_duration_sec(axis: HoverboardAxisSettings) -> float:
    """Upper-bound seconds for ``start_pulse_straight_backward`` until the loop exits.

    The backward path now uses the **exact same drift-corrected
    algorithm** as forward (cumulative IMU tracking, drive-then-check
    cycles with at-standstill micro-step pivot correction), so the
    duration model is identical to
    :func:`estimate_forward_pulse_series_duration_sec`. The ``axis``
    argument is kept for signature compatibility but is no longer
    consulted.
    """
    _ = axis  # reserved for compatibility
    cycles = _straight_bench_cycles()
    leg = _straight_leg_sec()
    settle = _straight_brake_settle_sec()
    prime = _straight_prime_timeout_sec()
    return prime + float(cycles) * (leg + settle)
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
