MeghanaMadhuri/jetsonuarteyes/nina/controllers/dynamixel_manager.py

import json
import logging
import threading
import time
from pathlib import Path
from typing import Any, Dict, List, Optional

from nina.config.motor_ids import ACTION_MOTOR_IDS
from nina.models.types import HealthReport


log = logging.getLogger("nina.dynamixel")


HEADER = 0xFF
PING = 0x01
READ_DATA = 0x02
WRITE_DATA = 0x03
SYNC_WRITE = 0x83
BROADCAST_ID = 0xFE

REG_TORQUE_ENABLE = (24, 1)
# Protocol 1.0: joint limits (L, H). Both zero => wheel/endless-turn mode — Goal
# Position drives speed, not angle; position-style hover commands appear dead.
REG_CW_ANGLE_LIMIT = (6, 2)
REG_CCW_ANGLE_LIMIT = (8, 2)
REG_GOAL_POSITION = (30, 2)
REG_MOVING_SPEED = (32, 2)
REG_PRESENT_POS = (36, 2)

POS_MIN = 0
POS_MAX = 4095

BUS_SETTLE_SEC = 0.25
INTER_PACKET_SEC = 0.004
PING_RETRIES = 3
READ_RETRIES = 4
PING_TIMEOUT_SEC = 0.08
READ_TIMEOUT_SEC = 0.05
WRITE_STATUS_TIMEOUT_SEC = 0.03


class DynamixelManager:
    """
    High-level arm motor manager for Nina's Dynamixel Protocol 1.0 bus.
    """

    def __init__(self, serial_port: str, baudrate: int, expected_motor_ids: List[int]) -> None:
        self.serial_port = serial_port
        self.baudrate = baudrate
        self.expected_motor_ids = expected_motor_ids
        self._serial: Optional[Any] = None
        self._is_initialized = False

    def initialize_bus(self) -> None:
        if self._serial and getattr(self._serial, "is_open", False):
            return

        serial = self._load_serial_module()
        self._serial = serial.Serial(port=self.serial_port, baudrate=self.baudrate, timeout=0.1)
        self._serial.reset_input_buffer()
        self._serial.reset_output_buffer()
        time.sleep(BUS_SETTLE_SEC)
        self._robust_clear()
        self._is_initialized = True

    def close(self) -> None:
        if self._serial and getattr(self._serial, "is_open", False):
            self._serial.close()
        self._is_initialized = False

    def ensure_joint_mode_for_ids(self, motor_ids: List[int]) -> None:
        """If any listed servo is in wheel mode (CW/CCW limits both 0), set joint limits.

        MX / AX servos on Protocol 1 share this layout. Torque is toggled off only
        for motors that need a limit rewrite, then the caller should run
        ``set_torque_all(True)`` again.
        """
        self._require_initialized()
        for sid in motor_ids:
            if sid not in self.expected_motor_ids:
                continue
            cw = self.read_reg(sid, *REG_CW_ANGLE_LIMIT)
            ccw = self.read_reg(sid, *REG_CCW_ANGLE_LIMIT)
            if cw is None or ccw is None:
                log.warning(
                    "Dynamixel id=%s: cannot read angle limits (id/baud/wiring or "
                    "non-Protocol 1.0 device)",
                    sid,
                )
                continue
            if cw != 0 or ccw != 0:
                continue
            log.warning(
                "Dynamixel id=%s: wheel/endless mode (angle limits 0/0); "
                "enabling joint mode 0..%s for position control",
                sid,
                POS_MAX,
            )
            self.write_reg(sid, *REG_TORQUE_ENABLE, 0)
            time.sleep(0.02)
            self.write_reg(sid, *REG_CW_ANGLE_LIMIT, 0)
            self.write_reg(sid, *REG_CCW_ANGLE_LIMIT, POS_MAX)
            time.sleep(0.02)

    def run_health_check(self) -> HealthReport:
        self._require_initialized()
        reachable = [sid for sid in self.expected_motor_ids if self.ping(sid)]
        missing = [sid for sid in self.expected_motor_ids if sid not in reachable]
        connected = len(missing) == 0
        detail = "All expected motors reachable." if connected else f"Missing motor IDs: {missing}"
        return HealthReport(
            connected=connected,
            detected_motors=len(reachable),
            expected_motors=len(self.expected_motor_ids),
            detail=detail,
        )

    def set_torque_for_ids(self, motor_ids: List[int], enable: bool) -> None:
        """Broadcast SyncWrite to flip torque on the given motor IDs."""
        self._require_initialized()
        value = 1 if enable else 0
        payload = {
            sid: [value]
            for sid in motor_ids
            if sid in self.expected_motor_ids
        }
        if payload:
            self.sync_write(*REG_TORQUE_ENABLE, payload)

    def set_torque_all(self, enable: bool) -> None:
        """Broadcast a single SyncWrite to flip torque on every motor.

        Earlier this looped through `write_reg` once per motor. On a
        slightly noisy bus (typical when running off a Jetson Nano with
        a long FTDI lead) any one of those 11 individual writes could
        be missed - the affected motor would then keep holding torque,
        which made manual posing during a recording impossible. A
        SyncWrite is a single bus packet, so either every motor sees
        the update or none do. Use `set_torque_all_verified()` if you
        need the stronger "every motor confirms" guarantee.
        """
        self.set_torque_for_ids(self.expected_motor_ids, enable)

    def set_torque_for_ids_verified(
        self,
        motor_ids: List[int],
        enable: bool,
        *,
        max_attempts: int = 4,
    ) -> List[int]:
        """Like `set_torque_for_ids`, but read back and retry stragglers.

        Returns motor IDs that could not be confirmed after `max_attempts`.
        """
        self._require_initialized()
        ids = [sid for sid in motor_ids if sid in self.expected_motor_ids]
        if not ids:
            return []
        target = 1 if enable else 0
        for attempt in range(max(1, max_attempts)):
            self.set_torque_for_ids(ids, enable)
            time.sleep(0.01)
            stragglers: List[int] = []
            for sid in ids:
                actual = self.read_reg(sid, *REG_TORQUE_ENABLE)
                if actual is None or actual != target:
                    stragglers.append(sid)
            if not stragglers:
                return []
            for sid in stragglers:
                self.write_reg(sid, *REG_TORQUE_ENABLE, target)
            time.sleep(0.01 * (attempt + 1))
        unresolved: List[int] = []
        for sid in ids:
            actual = self.read_reg(sid, *REG_TORQUE_ENABLE)
            if actual is None or actual != target:
                unresolved.append(sid)
        return unresolved

    def set_torque_all_verified(
        self,
        enable: bool,
        *,
        max_attempts: int = 4,
    ) -> List[int]:
        """Like `set_torque_all`, but read back and retry stragglers.

        Returns the list of motor IDs that we could not confirm were in
        the requested state after `max_attempts` rounds. The bus stays
        usable either way; the caller can decide whether to abort or
        continue with a warning.
        """
        return self.set_torque_for_ids_verified(
            self.expected_motor_ids, enable, max_attempts=max_attempts
        )

    def execute_action_file(self, action_path: Path) -> None:
        self._require_initialized()
        action = json.loads(action_path.read_text(encoding="utf-8"))
        frames = action.get("frames", [])
        for frame in frames:
            self._execute_frame(frame)

    def play_smooth(
        self,
        action_path: Path,
        sub_hz: float = 50.0,
        max_speed: int = 1023,
        warmup_sec: float = 0.5,
        speed: float = 1.0,
        *,
        stop_event: Optional[threading.Event] = None,
        release_neutral_path: Optional[Path] = None,
        release_ramp_sec: float = 1.5,
        release_max_speed: Optional[int] = None,
    ) -> bool:
        """
        Smoothly play back a recorded action.

        Between every pair of recorded keyframes we linearly interpolate goal
        positions and push them as one SyncWrite per tick at `sub_hz` Hz.
        The motor's internal trapezoidal profile is bypassed by raising
        `Moving Speed` once at the start, so the trajectory shape is set by
        the interpolated goal stream rather than by the per-frame "step + wait"
        used in `execute_action_file`.

        `speed` is a playback-time multiplier:
          1.0 -> play at the recorded tempo
          0.5 -> half speed (twice as long)
          2.0 -> double speed (half as long)
        Interpolation density (sub_hz) is unchanged, so smoothness is preserved
        at any tempo.

        When ``stop_event`` is set during playback and ``release_neutral_path``
        is provided, motion eases from the live present positions into the
        neutral pose over ``release_ramp_sec`` instead of stopping abruptly.

        Returns ``True`` when the action completes normally, ``False`` when
        playback was interrupted (including after a release ramp).
        """
        self._require_initialized()
        action = json.loads(action_path.read_text(encoding="utf-8"))
        frames = action.get("frames", [])
        if not frames:
            return True

        sub_hz = max(1.0, float(sub_hz))
        sub_dt = 1.0 / sub_hz
        speed = max(0.05, float(speed))

        self.set_moving_speed_for_ids(ACTION_MOTOR_IDS, max_speed)

        present: Dict[int, int] = {}
        for sid in ACTION_MOTOR_IDS:
            v = self.read_reg(sid, *REG_PRESENT_POS)
            if v is not None:
                present[sid] = self._clamp_pos(v)

        first_goals = self._frame_goals(frames[0])
        warmup = max(float(warmup_sec), float(frames[0].get("duration", 0.0)) / speed)
        if warmup > 0 and first_goals:
            if self._interpolate_segment(
                present, first_goals, warmup, sub_dt, stop_event=stop_event
            ):
                return self._ramp_to_neutral_on_release(
                    release_neutral_path,
                    release_ramp_sec,
                    sub_dt,
                    release_max_speed or max_speed,
                )
        elif first_goals:
            self.sync_write_goal_position(first_goals)

        for i in range(len(frames) - 1):
            if stop_event is not None and stop_event.is_set():
                return self._ramp_to_neutral_on_release(
                    release_neutral_path,
                    release_ramp_sec,
                    sub_dt,
                    release_max_speed or max_speed,
                )
            a = frames[i]
            b = frames[i + 1]
            delay = float(b.get("delay", 0.0)) / speed
            if delay > 0 and self._wait_interruptible(delay, stop_event):
                return self._ramp_to_neutral_on_release(
                    release_neutral_path,
                    release_ramp_sec,
                    sub_dt,
                    release_max_speed or max_speed,
                )
            duration = max(0.001, float(b.get("duration", 0.05)) / speed)
            a_goals = self._frame_goals(a) or first_goals
            b_goals = self._frame_goals(b)
            if self._interpolate_segment(
                a_goals, b_goals, duration, sub_dt, stop_event=stop_event
            ):
                return self._ramp_to_neutral_on_release(
                    release_neutral_path,
                    release_ramp_sec,
                    sub_dt,
                    release_max_speed or max_speed,
                )
        return True

    def goals_from_action_file(self, action_path: Path) -> Dict[int, int]:
        """Absolute goal positions from the last keyframe of an action file."""
        action = json.loads(action_path.read_text(encoding="utf-8"))
        frames = action.get("frames", [])
        if not frames:
            return {}
        for frame in reversed(frames):
            goals = self._frame_goals(frame)
            if goals:
                return goals
        return {}

    def ramp_present_to_goals(
        self,
        target_goals: Dict[int, int],
        duration_sec: float,
        *,
        sub_hz: float = 50.0,
        max_speed: int = 1023,
    ) -> None:
        """Ease from live present positions into ``target_goals``."""
        self._require_initialized()
        if not target_goals or duration_sec <= 0:
            if target_goals:
                self.sync_write_goal_position(target_goals)
            return
        present = self._read_present_goals()
        sub_dt = 1.0 / max(1.0, float(sub_hz))
        self.set_moving_speed_for_ids(ACTION_MOTOR_IDS, max_speed)
        self._interpolate_segment(present, target_goals, duration_sec, sub_dt)

    def sync_write(self, addr: int, size: int, payload: Dict[int, List[int]]) -> None:
        """Broadcast SyncWrite to many servos at once. No status return."""
        if not payload:
            return
        params: List[int] = [addr, size]
        for sid, data in payload.items():
            params.append(int(sid) & 0xFF)
            for byte in data[:size]:
                params.append(int(byte) & 0xFF)
        pkt = self._build(BROADCAST_ID, SYNC_WRITE, params)
        self._serial.write(pkt)
        self._serial.flush()
        time.sleep(max(INTER_PACKET_SEC, len(pkt) * 10.0 / self.baudrate))

    def sync_write_goal_position(self, positions: Dict[int, int]) -> None:
        if not positions:
            return
        payload: Dict[int, List[int]] = {}
        for sid, val in positions.items():
            if sid not in self.expected_motor_ids:
                continue
            v = self._clamp_pos(int(val))
            payload[sid] = [v & 0xFF, (v >> 8) & 0xFF]
        self.sync_write(*REG_GOAL_POSITION, payload)

    def sync_write_moving_speed_subset(self, speeds: Dict[int, int]) -> None:
        """SyncWrite moving speed (0..1023) for a subset of IDs (e.g. lean axes only)."""
        if not speeds:
            return
        payload: Dict[int, List[int]] = {}
        for sid, speed in speeds.items():
            if sid not in self.expected_motor_ids:
                continue
            sp = max(0, min(1023, int(speed)))
            payload[sid] = [sp & 0xFF, (sp >> 8) & 0xFF]
        self.sync_write(*REG_MOVING_SPEED, payload)

    def set_moving_speed_for_ids(self, motor_ids: List[int], speed: int) -> None:
        speed = max(0, min(1023, int(speed)))
        lo = speed & 0xFF
        hi = (speed >> 8) & 0xFF
        payload = {
            sid: [lo, hi]
            for sid in motor_ids
            if sid in self.expected_motor_ids
        }
        if payload:
            self.sync_write(*REG_MOVING_SPEED, payload)

    def set_moving_speed_all(self, speed: int) -> None:
        self.set_moving_speed_for_ids(self.expected_motor_ids, speed)

    def capture_frame(self, duration: float, speed: int = 200, delay: float = 0.0) -> Dict[str, Any]:
        """Sample present positions for action recording (arm/neck only, not lean axes)."""
        self._require_initialized()
        servos = {}
        for sid in ACTION_MOTOR_IDS:
            present = self.read_reg(sid, *REG_PRESENT_POS)
            if present is not None:
                servos[str(sid)] = {"type": "absolute", "value": self._clamp_pos(present)}
        return {
            "delay": delay,
            "duration": duration,
            "speed": speed,
            "servos": servos,
        }

    def ping(self, sid: int) -> bool:
        pkt = self._build(sid, PING)
        for attempt in range(PING_RETRIES):
            self._robust_clear()
            self._serial.write(pkt)
            self._serial.flush()
            time.sleep(max(INTER_PACKET_SEC, len(pkt) * 10.0 / self.baudrate))
            if self._recv(sid, timeout=PING_TIMEOUT_SEC) is not None:
                return True
            if attempt < PING_RETRIES - 1:
                time.sleep(0.015)
        return False

    def read_reg(self, sid: int, addr: int, size: int) -> Optional[int]:
        pkt = self._build(sid, READ_DATA, [addr, size])
        for attempt in range(READ_RETRIES):
            self._robust_clear()
            self._serial.write(pkt)
            self._serial.flush()
            time.sleep(max(INTER_PACKET_SEC, len(pkt) * 10.0 / self.baudrate))
            resp = self._recv(sid, timeout=READ_TIMEOUT_SEC)
            if resp is not None and len(resp[1]) >= size:
                data = resp[1]
                return data[0] if size == 1 else (data[0] | (data[1] << 8))
            if attempt < READ_RETRIES - 1:
                time.sleep(0.01)
        return None

    def write_reg(self, sid: int, addr: int, size: int, value: int) -> bool:
        value = int(value) & (0xFF if size == 1 else 0xFFFF)
        params = [addr, value & 0xFF] if size == 1 else [addr, value & 0xFF, (value >> 8) & 0xFF]
        pkt = self._build(sid, WRITE_DATA, params)
        self._serial.reset_input_buffer()
        self._serial.write(pkt)
        self._serial.flush()
        time.sleep(max(INTER_PACKET_SEC, len(pkt) * 10.0 / self.baudrate))
        self._recv(sid, timeout=WRITE_STATUS_TIMEOUT_SEC)
        return True

    def _read_present_goals(self) -> Dict[int, int]:
        present: Dict[int, int] = {}
        for sid in ACTION_MOTOR_IDS:
            v = self.read_reg(sid, *REG_PRESENT_POS)
            if v is not None:
                present[sid] = self._clamp_pos(v)
        return present

    def _wait_interruptible(
        self,
        duration: float,
        stop_event: Optional[threading.Event],
        poll_sec: float = 0.02,
    ) -> bool:
        """Wait up to ``duration``. Returns ``True`` when ``stop_event`` is set."""
        if duration <= 0:
            return stop_event is not None and stop_event.is_set()
        deadline = time.monotonic() + duration
        while time.monotonic() < deadline:
            if stop_event is not None and stop_event.is_set():
                return True
            remaining = deadline - time.monotonic()
            if remaining <= 0:
                break
            time.sleep(min(poll_sec, remaining))
        return stop_event is not None and stop_event.is_set()

    def _ramp_to_neutral_on_release(
        self,
        release_neutral_path: Optional[Path],
        release_ramp_sec: float,
        sub_dt: float,
        max_speed: int,
    ) -> bool:
        if release_neutral_path is None or not release_neutral_path.exists():
            return False
        neutral_goals = self.goals_from_action_file(release_neutral_path)
        if not neutral_goals:
            return False
        present = self._read_present_goals()
        ramp = max(0.05, float(release_ramp_sec))
        self.set_moving_speed_for_ids(ACTION_MOTOR_IDS, max_speed)
        self._interpolate_segment(present, neutral_goals, ramp, sub_dt)
        return False

    def _interpolate_segment(
        self,
        a_goals: Dict[int, int],
        b_goals: Dict[int, int],
        duration: float,
        sub_dt: float,
        *,
        stop_event: Optional[threading.Event] = None,
    ) -> bool:
        """Interpolate ``a_goals`` → ``b_goals``. Returns ``True`` if interrupted."""
        ids = sorted(set(a_goals.keys()) | set(b_goals.keys()))
        if not ids or duration <= 0:
            if b_goals:
                self.sync_write_goal_position(b_goals)
            if duration > 0:
                return self._wait_interruptible(duration, stop_event)
            return False

        steps = max(1, int(round(duration / sub_dt)))
        start = time.monotonic()
        for k in range(1, steps):
            if stop_event is not None and stop_event.is_set():
                return True
            t = k / steps
            interp: Dict[int, int] = {}
            for sid in ids:
                av = a_goals.get(sid, b_goals.get(sid))
                bv = b_goals.get(sid, av)
                if av is None or bv is None:
                    continue
                interp[sid] = int(round(av + (bv - av) * t))
            if interp:
                self.sync_write_goal_position(interp)
            target = start + k * sub_dt
            sleep_for = target - time.monotonic()
            if sleep_for > 0:
                if self._wait_interruptible(sleep_for, stop_event):
                    return True

        if b_goals:
            self.sync_write_goal_position(b_goals)
        target = start + duration
        sleep_for = target - time.monotonic()
        if sleep_for > 0:
            return self._wait_interruptible(sleep_for, stop_event)
        return False

    def _frame_goals(self, frame: Dict[str, Any]) -> Dict[int, int]:
        goals: Dict[int, int] = {}
        for raw_sid, spec in frame.get("servos", {}).items():
            try:
                sid = int(raw_sid)
            except (TypeError, ValueError):
                continue
            if sid not in ACTION_MOTOR_IDS:
                continue
            if spec.get("type", "absolute") != "absolute":
                continue
            value = spec.get("value")
            if value is None:
                continue
            goals[sid] = self._clamp_pos(int(value))
        return goals

    def _execute_frame(self, frame: Dict[str, Any]) -> None:
        delay = float(frame.get("delay", 0.0))
        duration = float(frame.get("duration", 1.0))
        speed = int(frame.get("speed", 200))
        servos = frame.get("servos", {})

        if delay > 0:
            time.sleep(delay)

        for sid in ACTION_MOTOR_IDS:
            self.write_reg(sid, *REG_MOVING_SPEED, speed)

        for raw_sid, spec in servos.items():
            sid = int(raw_sid)
            if sid not in ACTION_MOTOR_IDS:
                continue
            if spec.get("type", "absolute") != "absolute":
                raise ValueError(f"Unsupported servo command type for S{sid}: {spec.get('type')}")
            value = spec.get("value")
            if value is None:
                continue
            self.write_reg(sid, *REG_GOAL_POSITION, self._clamp_pos(value))

        if duration > 0:
            time.sleep(duration)

    def _recv(self, servo_id: int, timeout: float = 0.1):
        deadline = time.time() + timeout
        buf = bytearray()
        while time.time() < deadline:
            if self._serial.in_waiting:
                buf.extend(self._serial.read(self._serial.in_waiting))
                if len(buf) >= 6:
                    for i in range(len(buf) - 1):
                        if buf[i] == HEADER and buf[i + 1] == HEADER:
                            chunk = buf[i:]
                            if len(chunk) >= 4:
                                length = chunk[3]
                                if len(chunk) >= 4 + length:
                                    full = chunk[: 4 + length]
                                    if self._checksum(full[:-1]) == full[-1] and full[2] == servo_id:
                                        return full[4], list(full[5:-1])
            time.sleep(0.001)
        return None

    def _robust_clear(self) -> None:
        self._serial.reset_input_buffer()
        time.sleep(0.005)
        self._serial.reset_input_buffer()

    @staticmethod
    def _build(servo_id: int, instr: int, params: Optional[List[int]] = None) -> bytes:
        params = params or []
        pkt = [HEADER, HEADER, servo_id, 2 + len(params), instr] + params
        pkt.append(DynamixelManager._checksum(pkt))
        return bytes(pkt)

    @staticmethod
    def _checksum(pkt: List[int]) -> int:
        return (~sum(pkt[2:])) & 0xFF

    @staticmethod
    def _clamp_pos(value: int) -> int:
        return max(POS_MIN, min(POS_MAX, int(value)))

    def _require_initialized(self) -> None:
        if not self._is_initialized or self._serial is None:
            raise RuntimeError("Dynamixel bus is not initialized.")

    @staticmethod
    def _load_serial_module():
        try:
            import serial  # type: ignore
        except ImportError as exc:
            raise RuntimeError("pyserial is required. Install with: pip install pyserial") from exc
        return serial
