MeghanaMadhuri/jetsonuarteyes/pi_motor_bridge/navigation_bldc.py

"""
Raspberry Pi BLDC navigation module for the Sirena Nina bot (legacy path).

**Production:** the Jetson Orin Nano runs `NavigationManager` on the
40-pin header. This file is the motor backend for
**`pi_motor_bridge/motor_bridge.py`** when a Pi drives the JYQDs during
bench bring-up (pigpio on the Pi only).

Originally from `/Downloads/navigation_bldc.py` in the RPi prototype: it
runs on the Pi. A historical setup sent ASCII **`SET`** lines from the
Jetson over UART; **Nina on the Jetson no longer uses that path.**

Hardware: two JYQD_V7.3E2 BLDC drivers (one per wheel), powered from a
24 V battery (driver power) and 5 V from either the Pi or Jetson (logic
power). On the Pi, EL / DIR / PWM are driven via pigpio.

Pin map (Raspberry Pi 40-pin header in **`motor_bridge.py` / this module**;
**Jetson direct wiring** uses different BCMs — see
`nina.controllers.navigation_manager.DEFAULT_PINS`):

    Function       BCM    Physical pin    Notes
    L-EL           18     12              digital out
    L-DIR (Z/F)    25     22              digital out
    L-PWM (VR)     12     32              hardware PWM0
    R-EL           10     19              digital out
    R-DIR (Z/F)    22     15              digital out
    R-PWM (VR)     13     33              hardware PWM (pigpio; Jetson labels this pad pwm2)
    Status RED     21     40              digital out (active-low)
    Status GREEN   20     38              digital out (active-low)
    Status BLUE    16     36              digital out (active-low)
    E-stop 1       17     11              digital in
    E-stop 2        5     29              digital in
    5 V to JYQDs    -      2 or 4         power (logic only)
    GND for L-JYQD  -     39              power
    GND for R-JYQD  -     34              power
    24 V to JYQDs   -      -              external battery to VCC screws

Direction polarity (matches the original prototype):
    Left  forward  =>  L_DIR HIGH
    Right forward  =>  R_DIR LOW    (right side is mirrored)

The polarity inversion lives in `control_speed()` below. If a wheel
spins the wrong way after a wiring change, flip the side's mapping
there - or, better, set NINA_NAV_INVERT_LEFT / NINA_NAV_INVERT_RIGHT
on the Jetson side so this file stays as-is.

Differences from the very first prototype version:
  * `set_wheels(...)` convenience helper added so the bridge can update
    both wheels in a single call. The original two-call sequence still
    works exactly the same.
  * `soft_stop()` added: PWM=0 on both sides, EL stays HIGH. The bridge
    uses this for the regular `STOP` command so the chip stays armed
    and the next direction change is instant. (`stop()` in the original
    is identical and is kept as an alias.)
  * `disable_drivers()` added: used by the bridge for `ESTOP` - sets
    PWM=0, drops EL LOW on both sides, but does NOT call pigpio.stop()
    (so the daemon stays alive and the bridge can re-arm without a
    full teardown).
  * pigpio connection lives in module state (`object_pi`) exactly like
    the original, so `motor_bridge.py` and the original `motor_control.py`
    can share this module unchanged.
"""

from __future__ import annotations

import logging
import time

import pigpio

# Module logger only - we deliberately do NOT call `logging.basicConfig`
# at import time. Doing so would hijack the root logger for any process
# that imports this module (e.g. `motor_bridge.py --verbose`'s argparse-
# driven log setup, or the unit tests). Callers that want the legacy
# `/tmp/ila_bot.log` file behaviour can opt in by calling
# `enable_legacy_file_log()` after configuring their own root logger.
log = logging.getLogger("nina.pi.bldc")


def enable_legacy_file_log(path: str = "/tmp/ila_bot.log") -> None:
    """Opt-in: tee this module's log records to the legacy file path.

    Kept so the original RPi prototype's `/tmp/ila_bot.log` workflow
    still works for anyone debugging directly on the Pi. Adds a
    handler to *this module's* logger only, so it never touches the
    root logger or other modules' configuration.
    """
    handler = logging.FileHandler(path)
    handler.setFormatter(
        logging.Formatter("%(asctime)-15s %(levelname)s %(message)s")
    )
    log.addHandler(handler)
    log.setLevel(logging.INFO)

RED = 21
GREEN = 20
BLUE = 16

ESP1 = 17
ESP2 = 5

R_EN = 10
R_DIR = 22
L_EN = 18
L_DIR = 25

PWM_R = 13
PWM_L = 12

PWM_FREQ_HZ = 2000

# JYQD speed-feedback signal lines (one tachometer-style pulse per
# commutation step). The OLD Sirena_Humanoid prototype configures these
# as INPUT at module load and we mirror that here. We don't read them
# yet, but leaving them un-configured caused enough drift in the JYQD
# wake-up sequence on at least one bench Pi to be worth fixing.
R_SIG = 27
L_SIG = 24

# Kick parameters - see kick_and_set() docstring. Tuned to match what
# the OLD prototype produced via two consecutive forward_forever() calls.
KICK_PWM_PERCENT = 15      # warm-up PWM duty; below the JYQD's torque threshold
KICK_DWELL_SEC = 0.1       # matches OLD's stop()/forward_forever() sleep

# Reverse warm-start parameters - see warm_reverse_and_set() docstring.
# Cheap BLDC hub motors with non-canonical hall-sensor wiring can fail
# to commutate in reverse from a stopped rotor. Briefly puffing the
# wheel forward gives the rotor enough momentum that the JYQD's
# fallback commutation table can latch onto the reverse hall sequence
# at the moment the kick re-arms the chip.
PUFF_PWM_PERCENT = 25      # forward puff duty; above static stiction on free wheels
PUFF_FWD_SEC = 0.15        # how long the forward puff stays on
PUFF_COAST_SEC = 0.05      # coast at PWM=0 before reversing the kick

object_pi: "pigpio.pi | None" = None


def setup_gpio() -> bool:
    """Connect to pigpiod and configure all motor / LED / E-stop pins.

    Idempotent; safe to call repeatedly (will reuse an already-open
    pigpio handle). Returns True on success, False if the daemon
    isn't reachable.
    """
    global object_pi

    if object_pi is not None and object_pi.connected:
        return True

    print("[GPIO] Connecting to pigpio...")
    object_pi = pigpio.pi()

    if not object_pi.connected:
        print("[ERROR] pigpio connection failed (is pigpiod running?)")
        return False

    object_pi.set_mode(ESP1, pigpio.INPUT)
    object_pi.set_mode(ESP2, pigpio.INPUT)

    object_pi.set_mode(RED, pigpio.OUTPUT)
    object_pi.set_mode(GREEN, pigpio.OUTPUT)
    object_pi.set_mode(BLUE, pigpio.OUTPUT)

    object_pi.set_mode(R_EN, pigpio.OUTPUT)
    object_pi.set_mode(R_DIR, pigpio.OUTPUT)
    object_pi.set_mode(L_EN, pigpio.OUTPUT)
    object_pi.set_mode(L_DIR, pigpio.OUTPUT)

    # JYQD speed-feedback signal lines - input only, mirrors the OLD
    # Sirena_Humanoid prototype's GPIO.setup(...,GPIO.IN) for these pins.
    object_pi.set_mode(L_SIG, pigpio.INPUT)
    object_pi.set_mode(R_SIG, pigpio.INPUT)

    # Park in a known-safe state: both EL HIGH (chip armed), both DIR
    # forward, both PWM 0. Identical to what stop() would leave us in.
    object_pi.write(L_EN, 1)
    object_pi.write(R_EN, 1)
    object_pi.write(L_DIR, 1)
    object_pi.write(R_DIR, 0)
    object_pi.hardware_PWM(PWM_L, PWM_FREQ_HZ, 0)
    object_pi.hardware_PWM(PWM_R, PWM_FREQ_HZ, 0)

    print("[GPIO] Setup complete")
    return True


def control_speed(side: str, enable: str, speed: int, direction: str) -> None:
    """Set a single wheel.

    side       : 'left' | 'right'
    enable     : 'enable' (EL HIGH, chip armed) | 'disable' (EL LOW, chip off)
    speed      : 0..100 (percent of PWM duty cycle)
    direction  : 'front' | 'back'  (logical wheel direction)

    Right-side polarity is mirrored here so callers can think in plain
    'front'/'back' terms without worrying about how the right motor is
    wired relative to the left one.
    """
    if object_pi is None:
        print("[ERROR] pigpio not initialized!")
        return

    speed = max(0, min(100, int(speed)))
    duty = int(speed * 10000)  # pigpio hardware_PWM range is 0..1_000_000

    if side == "left":
        object_pi.write(L_EN, 1 if enable == "enable" else 0)
        object_pi.write(L_DIR, 1 if direction == "front" else 0)
        object_pi.hardware_PWM(PWM_L, PWM_FREQ_HZ, duty)

    elif side == "right":
        object_pi.write(R_EN, 1 if enable == "enable" else 0)
        # Right side is mirrored - "front" wants R_DIR LOW.
        object_pi.write(R_DIR, 0 if direction == "front" else 1)
        object_pi.hardware_PWM(PWM_R, PWM_FREQ_HZ, duty)

    else:
        print(f"[ERROR] control_speed: unknown side '{side}'")


def set_wheels(
    left_speed: int,
    left_direction: str,
    right_speed: int,
    right_direction: str,
) -> None:
    """Update both wheels in one call. Both EL stay HIGH (chip armed)."""
    control_speed("left", "enable", left_speed, left_direction)
    control_speed("right", "enable", right_speed, right_direction)


def kick_and_set(
    left_speed: int,
    left_direction: str,
    right_speed: int,
    right_direction: str,
) -> None:
    """JYQD startup kick - guarantees the rotor begins commutating.

    The JYQD_V7.3E2 drivers we ship with Nina need a very specific
    edge sequence on EL and PWM to start spinning a stopped rotor.
    Without it the chip happily accepts a (EL HIGH, PWM=N>0) command
    but never commutates - the wheel just sits there with a faint
    buzz. This was the "I have to send forward TWICE before it
    moves" behaviour we observed on the OLD Sirena_Humanoid prototype.

    For each wheel that's being commanded to non-zero speed, this
    function reproduces the verified-working sequence:

        1. Warm-up   : EL HIGH, PWM 0 -> KICK_PWM_PERCENT, target DIR.
                       Pushes a non-zero PWM level into the chip so we
                       have a real falling edge to give it next.
        2. Falling   : EL HIGH -> LOW, PWM KICK_PWM_PERCENT -> 0.
                       Hard stop. The DIR pin is left at its target
                       value (the JYQD samples DIR on the EL rising
                       edge, not while it's HIGH).
        3. Rising    : EL LOW -> HIGH, PWM 0 -> requested speed.
                       The actual go command. The chip sees a clean
                       LOW->HIGH on EL *and* a 0 -> N rising edge on
                       PWM, both within the same control cycle, and
                       reliably starts commutation.

    Wheels whose target speed is 0 are left alone during the warm-up
    and falling-edge steps - we don't want to twitch a wheel the
    caller explicitly wants stopped (e.g. a one-wheel pivot). They
    still get their final EL/PWM written in step 3 so the chip is
    in a known-safe (PWM=0, EL HIGH) state at exit.

    Total wall time is ~2 * KICK_DWELL_SEC (default 200 ms) when at
    least one wheel is being kicked, near-zero otherwise. The bridge
    only calls this on transitions out of a stopped state or on
    direction changes - steady-state SETs that are just nudging
    the speed call set_wheels() instead and stream at full rate.
    """
    left_needs_kick = left_speed > 0
    right_needs_kick = right_speed > 0

    if left_needs_kick:
        control_speed("left", "enable", KICK_PWM_PERCENT, left_direction)
    if right_needs_kick:
        control_speed("right", "enable", KICK_PWM_PERCENT, right_direction)
    if left_needs_kick or right_needs_kick:
        time.sleep(KICK_DWELL_SEC)

    if left_needs_kick:
        control_speed("left", "disable", 0, left_direction)
    if right_needs_kick:
        control_speed("right", "disable", 0, right_direction)
    if left_needs_kick or right_needs_kick:
        time.sleep(KICK_DWELL_SEC)

    control_speed("left", "enable", left_speed, left_direction)
    control_speed("right", "enable", right_speed, right_direction)


def warm_reverse_and_set(
    left_speed: int,
    left_direction: str,
    right_speed: int,
    right_direction: str,
) -> None:
    """JYQD startup that handles cold-start reverse on hub motors.

    Cheap BLDC hub motors don't always have hall sensors wired in the
    sequence the JYQD assumes (ABC). The chip can fudge forward via a
    fallback commutation table, but starting reverse from a stopped
    rotor frequently fails - the wheel jerks once or twice and stalls,
    no matter how high the PWM duty.

    The trick is to give the rotor a tiny bit of forward momentum
    *first*. A spinning rotor is easier for the chip to track in
    either direction because it can sample multiple hall transitions
    in quick succession, so the moment the kick re-arms the chip in
    reverse, commutation latches cleanly.

    Sequence per wheel that's commanded to non-zero REVERSE speed:

        1. Forward puff : EL HIGH, DIR=front, PWM=PUFF_PWM_PERCENT.
                          Wheel spins forward briefly to build rotor
                          momentum.
        2. Coast        : PWM=0, EL HIGH, DIR=front. Lets the rotor
                          coast (no electrical brake) so it still has
                          RPM when the kick re-arms.
        3. Standard kick: hand off to kick_and_set() which does the
                          warm-up / falling / rising sequence in the
                          requested (reverse) direction.

    Wheels commanded to FORWARD or zero speed bypass the puff entirely
    and go straight to step 3, so this function is a drop-in
    replacement for kick_and_set() for any SET that involves a kick.
    Pure-forward kicks pay zero extra cost.

    Total wall time when at least one wheel is being warmed in
    reverse: ~PUFF_FWD_SEC + PUFF_COAST_SEC + 2 * KICK_DWELL_SEC
    (default ~400 ms). For pure-forward kicks the cost is the same as
    kick_and_set() (~200 ms).
    """
    left_needs_warm = left_speed > 0 and left_direction != "front"
    right_needs_warm = right_speed > 0 and right_direction != "front"

    if left_needs_warm or right_needs_warm:
        if left_needs_warm:
            control_speed("left", "enable", PUFF_PWM_PERCENT, "front")
        if right_needs_warm:
            control_speed("right", "enable", PUFF_PWM_PERCENT, "front")
        time.sleep(PUFF_FWD_SEC)

        if left_needs_warm:
            control_speed("left", "enable", 0, "front")
        if right_needs_warm:
            control_speed("right", "enable", 0, "front")
        time.sleep(PUFF_COAST_SEC)

    kick_and_set(left_speed, left_direction, right_speed, right_direction)


def soft_stop() -> None:
    """PWM=0 on both wheels, EL HIGH. Chip stays armed.

    This is what we want for a normal `STOP` from the Jetson - the
    next SET command can change direction instantly without an arm
    delay.

    Write PWM=0 twice with a short pause: a single write occasionally
    leaves one JYQD channel crawling at very low duty (often the
    right/ mirrored side after long pulses).
    """
    control_speed("left", "enable", 0, "front")
    control_speed("right", "enable", 0, "front")
    time.sleep(0.02)
    control_speed("left", "enable", 0, "front")
    control_speed("right", "enable", 0, "front")


# Original prototype name; kept for backwards compat with motor_control.py.
def stop() -> None:
    soft_stop()
    time.sleep(0.1)
    log.info("Stopped")


def disable_drivers() -> None:
    """PWM=0 + EL LOW on both wheels. Chip is fully off (no torque).

    Used by the bridge's `ESTOP` command. Unlike `emergency_stop()`
    below this does NOT tear down the pigpio connection, so the
    bridge can re-arm with the next SET command.
    """
    control_speed("left", "disable", 0, "front")
    control_speed("right", "disable", 0, "front")


def forward_forever() -> None:
    """Both wheels forward at the prototype default of 15%."""
    print("[MOVE] Forward")
    stop()
    time.sleep(0.1)

    control_speed("left", "enable", 15, "front")
    control_speed("right", "enable", 15, "front")

    time.sleep(1)


def backward_forever() -> None:
    """Both wheels backward at the prototype default of 15%."""
    print("[MOVE] Backward")
    stop()
    time.sleep(0.1)

    control_speed("left", "enable", 15, "back")
    control_speed("right", "enable", 15, "back")

    time.sleep(1)


def turn_left() -> None:
    """In-place left spin (L back, R front) for ~2.3 s, then stop."""
    print("[MOVE] Turn Left")
    stop()
    time.sleep(0.1)

    control_speed("left", "enable", 15, "back")
    control_speed("right", "enable", 15, "front")

    time.sleep(2.3)
    stop()


def turn_right() -> None:
    """In-place right spin (L front, R back) for ~2.3 s, then stop."""
    print("[MOVE] Turn Right")
    stop()
    time.sleep(0.1)

    control_speed("left", "enable", 15, "front")
    control_speed("right", "enable", 15, "back")

    time.sleep(2.3)
    stop()


def emergency_stop() -> None:
    """Hard stop AND tear down pigpio. Use only at process exit."""
    global object_pi

    print("[EMERGENCY] STOP!")

    try:
        stop()
        disable_drivers()

        if object_pi:
            object_pi.write(RED, 1)
            object_pi.write(GREEN, 1)
            object_pi.write(BLUE, 1)

    except Exception as e:
        print("[ERROR]", e)

    finally:
        try:
            if object_pi:
                object_pi.stop()
        except Exception:
            pass
        object_pi = None

    print("[EMERGENCY] Safe shutdown complete")


def notifier(mode: str) -> None:
    """Status LED. mode in {'CONNECTED', 'ERROR', 'WAITING', 'OFF'}."""
    if object_pi is None:
        return

    object_pi.write(RED, 1)
    object_pi.write(GREEN, 1)
    object_pi.write(BLUE, 1)

    if mode == "CONNECTED":
        object_pi.write(GREEN, 0)
    elif mode == "ERROR":
        object_pi.write(RED, 0)
    elif mode == "WAITING":
        object_pi.write(BLUE, 0)
    elif mode == "OFF":
        pass  # already off (set HIGH above)
