MeghanaMadhuri/jetsonuarteyes/nina/controllers/action_runner.py

import json
import os
import threading
from pathlib import Path
from typing import Any, Dict, List, Optional, Union

from nina.controllers.dynamixel_manager import DynamixelManager


# Manifest entry can be either a plain string (the action's JSON file
# relative to actions_dir) or a dict like
#     {"file": "recordings/namaste.json", "audio": "audio/namaste.mp3"}
# Both forms are read/written transparently so existing manifests keep
# working.
ManifestEntry = Union[str, Dict[str, Any]]


def action_playback_speed() -> float:
    """Tempo multiplier for smooth action playback (UI + ESP32 + tablet).

    ``1.0`` = recorded frame timing; ``0.5`` = half speed (default — matches
    the Actions screen ``PlaybackWorker``). Override with
    ``NINA_ACTION_PLAYBACK_SPEED``.
    """
    try:
        return max(0.05, float(os.environ.get("NINA_ACTION_PLAYBACK_SPEED", "0.5")))
    except ValueError:
        return 0.5


class ActionRunner:
    def __init__(self, manifest_path: Path, actions_dir: Path, dxl: DynamixelManager) -> None:
        self.manifest_path = manifest_path
        self.actions_dir = actions_dir
        self.dxl = dxl

    def list_actions(self) -> Dict[str, str]:
        """Return {name: relative_action_file_path}, normalizing dict entries."""
        manifest = self._load_manifest()
        return {
            name: self._extract_file(value)
            for name, value in manifest.get("actions", {}).items()
        }

    def get_action_audio(self, action_name: str) -> Optional[str]:
        """Return the relative audio path for an action, if one is registered."""
        manifest = self._load_manifest()
        raw = manifest.get("actions", {}).get(action_name)
        if isinstance(raw, dict):
            audio = raw.get("audio")
            if isinstance(audio, str) and audio.strip():
                return audio
        return None

    def get_action_audio_offset(self, action_name: str) -> float:
        """
        Seconds to wait after the action starts before firing the audio
        clip. Defaults to 0.0 (audio fires immediately).
        """
        manifest = self._load_manifest()
        raw = manifest.get("actions", {}).get(action_name)
        if isinstance(raw, dict):
            offset = raw.get("audio_offset")
            if isinstance(offset, (int, float)):
                return max(0.0, float(offset))
        return 0.0

    @staticmethod
    def _parse_eye_expression_id(raw: Any) -> Optional[int]:
        if raw is None or isinstance(raw, bool):
            return None
        try:
            eid = int(raw)
        except (TypeError, ValueError):
            return None
        if 0 <= eid <= 36:
            return eid
        return None

    def get_action_eye_expression(self, action_name: str) -> Optional[int]:
        """Manifest ``eye_expression`` (0–36) for UART eye display, or None."""
        manifest = self._load_manifest()
        raw = manifest.get("actions", {}).get(action_name)
        if isinstance(raw, dict):
            return self._parse_eye_expression_id(raw.get("eye_expression"))
        return None

    def get_action_eye_offset(self, action_name: str) -> float:
        """Seconds after motion starts before sending the eye expression."""
        manifest = self._load_manifest()
        raw = manifest.get("actions", {}).get(action_name)
        if isinstance(raw, dict):
            off = raw.get("eye_offset")
            if isinstance(off, (int, float)):
                return max(0.0, float(off))
        return 0.0

    def run_named_action(
        self,
        action_name: str,
        *,
        smooth: bool = True,
        sub_hz: float = 50.0,
        max_speed: int = 1023,
        speed: Optional[float] = None,
        stop_event: Optional[threading.Event] = None,
        release_neutral_name: Optional[str] = None,
        release_ramp_sec: float = 1.5,
        release_max_speed: Optional[int] = None,
    ) -> Path:
        actions = self.list_actions()
        if action_name not in actions:
            raise ValueError(f"Unknown action '{action_name}'.")
        action_path = self.actions_dir / actions[action_name]
        if not action_path.exists():
            raise FileNotFoundError(f"Action file not found: {action_path}")
        release_path: Optional[Path] = None
        if release_neutral_name:
            rel = actions.get(release_neutral_name)
            if rel:
                candidate = self.actions_dir / rel
                if candidate.exists():
                    release_path = candidate
        if smooth:
            self.dxl.play_smooth(
                action_path,
                sub_hz=sub_hz,
                max_speed=max_speed,
                speed=action_playback_speed() if speed is None else speed,
                stop_event=stop_event,
                release_neutral_path=release_path,
                release_ramp_sec=release_ramp_sec,
                release_max_speed=release_max_speed,
            )
        else:
            self.dxl.execute_action_file(action_path)
        return action_path

    def _load_manifest(self) -> Dict:
        if not self.manifest_path.exists():
            raise FileNotFoundError(f"Manifest not found: {self.manifest_path}")
        return json.loads(self.manifest_path.read_text(encoding="utf-8"))

    def set_action_audio(
        self,
        action_name: str,
        audio_name: Optional[str],
        audio_offset: Optional[float] = None,
    ) -> None:
        """
        Update only the audio fields of an existing manifest entry.

        - The action's `file` is left untouched.
        - `audio_name=None` (or empty) removes the audio mapping (and the
          offset) and collapses the entry back to a plain string.
        - `audio_offset=None` preserves any existing offset; passing 0
          (or a negative number) clears it.
        """
        manifest = self._load_manifest()
        actions = manifest.setdefault("actions", {})
        existing = actions.get(action_name)
        if existing is None:
            raise ValueError(f"Action '{action_name}' is not in the manifest.")

        if isinstance(existing, dict):
            file_name = str(existing.get("file", ""))
            existing_offset = existing.get("audio_offset")
            eye_id = existing.get("eye_expression")
            eye_off = existing.get("eye_offset")
        else:
            file_name = str(existing)
            existing_offset = None
            eye_id = None
            eye_off = None

        if not audio_name or not str(audio_name).strip():
            if isinstance(existing, dict) and (
                eye_id is not None or eye_off is not None
            ):
                entry = {"file": file_name}
                if eye_id is not None:
                    entry["eye_expression"] = eye_id
                if isinstance(eye_off, (int, float)) and float(eye_off) > 0:
                    entry["eye_offset"] = float(eye_off)
                actions[action_name] = entry
            else:
                actions[action_name] = file_name
        else:
            entry: Dict[str, Any] = {"file": file_name, "audio": str(audio_name)}
            if audio_offset is not None:
                if audio_offset > 0:
                    entry["audio_offset"] = float(audio_offset)
            elif isinstance(existing_offset, (int, float)) and float(existing_offset) > 0:
                entry["audio_offset"] = float(existing_offset)
            if eye_id is not None:
                entry["eye_expression"] = eye_id
            if isinstance(eye_off, (int, float)) and float(eye_off) > 0:
                entry["eye_offset"] = float(eye_off)
            actions[action_name] = entry

        self.manifest_path.write_text(json.dumps(manifest, indent=2), encoding="utf-8")

    def set_action_eye(
        self,
        action_name: str,
        expression_id: Optional[int],
        *,
        eye_offset: Optional[float] = None,
    ) -> None:
        """Set or clear ``eye_expression`` / ``eye_offset`` on a manifest entry."""
        from nina.jetson_net.manifest_eye import set_action_eye as _set_eye

        _set_eye(
            self.manifest_path,
            action_name,
            expression_id,
            eye_offset=eye_offset,
        )

    def delete_action(
        self,
        action_name: str,
        *,
        delete_recording: bool = True,
        delete_audio: bool = False,
    ) -> Dict[str, Any]:
        """Remove an action from the manifest, optionally deleting its files.

        Returns a summary of what was actually changed so the caller can
        surface it to the user:
            {
              "removed_from_manifest": bool,
              "deleted_recording": Optional[str],   # path that was deleted
              "deleted_audio":     Optional[str],
              "skipped_audio_shared_with": list[str],
            }

        Audio files are kept by default because two manifest entries can
        legitimately share the same clip (e.g. variants of the same
        action). Set `delete_audio=True` to also remove the MP3, but only
        if no other manifest entry references it.
        """
        manifest = self._load_manifest()
        actions = manifest.setdefault("actions", {})
        if action_name not in actions:
            raise ValueError(f"Action '{action_name}' is not in the manifest.")

        entry = actions[action_name]
        rel_file = self._extract_file(entry)
        rel_audio: Optional[str] = None
        if isinstance(entry, dict):
            audio_val = entry.get("audio")
            if isinstance(audio_val, str) and audio_val.strip():
                rel_audio = audio_val.strip()

        del actions[action_name]
        self.manifest_path.write_text(
            json.dumps(manifest, indent=2), encoding="utf-8"
        )

        deleted_recording: Optional[str] = None
        if delete_recording and rel_file:
            recording_path = self.actions_dir / rel_file
            if recording_path.exists() and recording_path.is_file():
                try:
                    recording_path.unlink()
                    deleted_recording = str(recording_path)
                except OSError:
                    # The manifest is already updated; surfacing a hard
                    # failure here would just confuse the operator.
                    deleted_recording = None

        deleted_audio: Optional[str] = None
        skipped_audio_shared_with: List[str] = []
        if delete_audio and rel_audio:
            others = [
                other_name
                for other_name, other_entry in actions.items()
                if isinstance(other_entry, dict)
                and isinstance(other_entry.get("audio"), str)
                and other_entry["audio"].strip() == rel_audio
            ]
            if others:
                skipped_audio_shared_with = others
            else:
                audio_path = self.actions_dir / rel_audio
                if audio_path.exists() and audio_path.is_file():
                    try:
                        audio_path.unlink()
                        deleted_audio = str(audio_path)
                    except OSError:
                        deleted_audio = None

        return {
            "removed_from_manifest": True,
            "deleted_recording": deleted_recording,
            "deleted_audio": deleted_audio,
            "skipped_audio_shared_with": skipped_audio_shared_with,
        }

    def register_action(
        self,
        action_name: str,
        file_name: str,
        audio_name: Optional[str] = None,
        audio_offset: Optional[float] = None,
    ) -> None:
        """
        Add or update a manifest entry. Existing audio / audio_offset values
        are preserved unless the caller provides new ones.
        """
        manifest = self._load_manifest()
        actions = manifest.setdefault("actions", {})
        existing = actions.get(action_name)
        existing_audio: Optional[str] = None
        existing_offset: Optional[float] = None
        existing_eye: Optional[int] = None
        existing_eye_off: Optional[float] = None
        if isinstance(existing, dict):
            if isinstance(existing.get("audio"), str):
                existing_audio = existing["audio"]
            if isinstance(existing.get("audio_offset"), (int, float)):
                existing_offset = float(existing["audio_offset"])
            existing_eye = self._parse_eye_expression_id(
                existing.get("eye_expression")
            )
            if isinstance(existing.get("eye_offset"), (int, float)):
                existing_eye_off = float(existing["eye_offset"])

        audio_to_keep = audio_name if audio_name is not None else existing_audio
        offset_to_keep = audio_offset if audio_offset is not None else existing_offset

        if audio_to_keep or existing_eye is not None:
            entry: Dict[str, Any] = {"file": file_name}
            if audio_to_keep:
                entry["audio"] = audio_to_keep
            if offset_to_keep is not None and offset_to_keep > 0:
                entry["audio_offset"] = float(offset_to_keep)
            if existing_eye is not None:
                entry["eye_expression"] = existing_eye
            if existing_eye_off is not None and existing_eye_off > 0:
                entry["eye_offset"] = float(existing_eye_off)
            actions[action_name] = entry
        else:
            actions[action_name] = file_name
        self.manifest_path.write_text(json.dumps(manifest, indent=2), encoding="utf-8")

    @staticmethod
    def _extract_file(value: ManifestEntry) -> str:
        if isinstance(value, dict):
            return str(value.get("file", ""))
        return str(value)
