MeghanaMadhuri/jetsonuarteyes/nina/services/audio_player.py

"""
Lightweight audio playback used by Nina to speak greetings while
performing actions.

The class delegates to whichever ALSA-compatible CLI player is on the
Jetson (`aplay` for WAV, `mpg123` for MP3, `ffplay` as a final
fallback). No Python audio dependencies are required, so this works on
a fresh JetPack image without extra pip installs.

Before starting a clip, ``AudioPlayer.play`` can optionally run a **volume
preroll**: save sink/Master level, set **0%**, dwell (``NINA_AUDIO_MUTE_PREROLL_SEC``),
then restore (ALSA ``amixer`` first, else PulseAudio). **Default dwell is 0**
(disabled): the old default (**4 s**) muted the amp before every clip and
caused long silence / stutter — especially with USB DACs, dmix, or when
the mixer control does not match the PCM device mpg123 uses. Set
``NINA_AUDIO_MUTE_PREROLL_SEC=0.15`` (or similar) only on hardware that
needs a brief mute to avoid power-on thump. If volume preroll cannot run,
``NINA_AUDIO_PREROLL_MS`` can inject digital silence via ``aplay`` instead.

When mute preroll is **off** (the default), ``play_silence_preroll_blocking``
still **clears Pulse/ALSA mute** and plays a very short digital silence
(``NINA_AUDIO_OUTPUT_WARMUP_MS``, default **100** ms) on the same device as
greetings — many dmix / USB DAC paths fail or pop if mpg123 is the first
client with no prior open. Set ``NINA_AUDIO_OUTPUT_WARMUP_MS=0`` to skip.
If Master was left at **0%%** from an interrupted old preroll, set
``NINA_AUDIO_RECOVER_ZERO_MASTER=1`` so we restore ``NINA_AUDIO_RESTORE_VOLUME_PCT``.

For MP3, set ``NINA_AUDIO_MPG123_DEVICE`` or ``NINA_GREET_APLAY_DEVICE`` so
``mpg123`` opens the **same** ALSA device the preroll mutes; otherwise the
decoder may use a different PCM path and volume changes won't prevent
startup glitches / underrun noise.

Output sample rate: **gTTS / Google greeting MP3s are mono at 24000 Hz**
(ffprobe on ``nina/actions/audio/*.mp3``). ``NINA_AUDIO_OUTPUT_RATE`` defaults
to **24000** so preroll silence and ``mpg123 -r`` match that stream (no extra
decoder resampling; ALSA ``plug``/dmix still upsamples to the DAC if needed).
Use **48000** if your sink only accepts 48 kHz PCM from mpg123, **44100** for
CD-rate music MP3s, or **auto** for decoder-native rate (no ``-r``) with a
**24000 Hz** preroll so warmup still matches typical greetings.

**Idle silence (anti-hiss):** by default Nina keeps a single raw ``aplay`` pipe
open (``NINA_AUDIO_PERSISTENT_PIPE=1``, the default). A background writer feeds
~20 ms stereo silence when nothing is playing; MP3/WAV clips are decoded to PCM
and written on the same stream. On HDMI (``CARD=HDA``), ``NINA_AUDIO_IDLE_OUTPUT_MUTE=1``
(default) also soft-mutes the sink while idle so monitor amp hiss stays off.
Disable with ``NINA_AUDIO_PERSISTENT_PIPE=0`` or ``NINA_AUDIO_IDLE_OUTPUT_MUTE=0``.

Install hint on the Jetson:
    sudo apt install -y alsa-utils mpg123
"""

from __future__ import annotations

import os
import re
import shutil
import subprocess
import sys
import tempfile
import threading
import time
import wave
from collections import deque
from pathlib import Path
from typing import Deque, List, Optional, Tuple

# gTTS (``AudioGenerator``) and Google Translate speech MP3s used for greetings
# and action clips in this repo decode as mono ~64 kb/s at this rate (verify with
# ``ffprobe -show_entries stream=sample_rate`` on any ``*.mp3``).
_GREETING_MP3_SAMPLE_RATE_HZ = 24000
_AMP_LOCK = threading.Lock()
_AMP_GPIO = None
_AMP_PIN: Optional[int] = None
_AMP_ACTIVE_HIGH = True
_AMP_USERS = 0
_AMP_SETUP_FAILED = False
_SILENCE_KEEPALIVE_LOCK = threading.RLock()
_SILENCE_KEEPALIVE_STOP = threading.Event()
_SILENCE_KEEPALIVE_THREAD: Optional[threading.Thread] = None
_SILENCE_KEEPALIVE_PROC: Optional[subprocess.Popen] = None
_SILENCE_KEEPALIVE_REAL_AUDIO_USERS = 0
_PERSISTENT_PIPE = None
_IDLE_OUTPUT_MUTED = False
_IDLE_OUTPUT_MUTE_LOCK = threading.Lock()


def _repo_root() -> Path:
    return Path(__file__).resolve().parents[2]


def _mute_preroll_sec() -> float:
    try:
        return max(0.0, float(os.environ.get("NINA_AUDIO_MUTE_PREROLL_SEC", "0")))
    except ValueError:
        return 0.0


def _preroll_ms() -> int:
    try:
        return max(0, int(os.environ.get("NINA_AUDIO_PREROLL_MS", "0")))
    except ValueError:
        return 0


def _output_warmup_ms() -> int:
    """Short silence before real audio so dmix/DAC sees an open PCM stream first."""
    raw = (os.environ.get("NINA_AUDIO_OUTPUT_WARMUP_MS") or "").strip()
    if raw:
        try:
            return max(0, min(2000, int(raw)))
        except ValueError:
            return 100
    return 100


def _recover_zero_master_enabled() -> bool:
    v = (os.environ.get("NINA_AUDIO_RECOVER_ZERO_MASTER") or "").strip().lower()
    return v in ("1", "true", "yes", "on")


def _env_bool(name: str, default: bool) -> bool:
    raw = (os.environ.get(name) or "").strip().lower()
    if not raw:
        return default
    return raw in ("1", "true", "yes", "y", "on")


def _env_int(name: str, default: int, lo: int, hi: int) -> int:
    raw = (os.environ.get(name) or "").strip()
    if not raw:
        return default
    try:
        return max(lo, min(hi, int(raw)))
    except ValueError:
        return default


def _alsa_output_device_hint() -> str:
    return (
        os.environ.get("NINA_GREET_APLAY_DEVICE")
        or os.environ.get("NINA_AUDIO_MPG123_DEVICE")
        or ""
    ).strip().lower()


def _i2s_amp_audio_output() -> bool:
    """True on MAX98357A / APE routes where ALSA idle mute is wrong or useless."""
    dev = _alsa_output_device_hint()
    if "max98357" in dev or ",card=ape" in dev or dev.startswith("hw:ape") or dev.startswith("plughw:ape"):
        return True
    if _amp_enable_gpio_pin() is not None:
        return True
    return _env_bool("NINA_AUDIO_APE_ROUTE", False)


def _hdmi_audio_output() -> bool:
    dev = _alsa_output_device_hint()
    if "hda" in dev or "hdmi" in dev:
        return True
    # Fleet kiosks often fall back to ALSA "default" (HDMI monitor speakers).
    if dev in ("default", "sysdefault", "sysdefault:"):
        return not _i2s_amp_audio_output()
    return False


def _persistent_pipe_enabled() -> bool:
    """Keep one ``aplay`` stream open; idle = digital silence, clips = injected PCM.

    Default **on** so HDMI/I2S DACs stay clocked and idle hiss stays low. Set
    ``NINA_AUDIO_PERSISTENT_PIPE=0`` to use one-shot ``mpg123``/``aplay`` per clip.
    """
    return _env_bool("NINA_AUDIO_PERSISTENT_PIPE", True)


def _idle_output_mute_enabled() -> bool:
    """Soft-mute ALSA/Pulse while the persistent pipe plays idle silence."""
    raw = (os.environ.get("NINA_AUDIO_IDLE_OUTPUT_MUTE") or "").strip()
    if raw:
        return _env_bool("NINA_AUDIO_IDLE_OUTPUT_MUTE", False)
    if not _persistent_pipe_enabled():
        return False
    # Default on for HDMI/default monitor paths; off for I2S amp bots.
    return not _i2s_amp_audio_output()


def _persistent_pipe_sample_rate_hz() -> int:
    """PCM rate for the always-open ``aplay`` pipe (HDMI prefers 48 kHz)."""
    rate = _preroll_wav_sample_rate_hz()
    if _i2s_amp_audio_output():
        return rate
    if _hdmi_audio_output() and rate < 48000:
        return 48000
    return rate


def _silence_keepalive_enabled() -> bool:
    if _persistent_pipe_enabled():
        return False
    return _env_bool("NINA_AUDIO_SILENCE_KEEPALIVE", False)


def _silence_keepalive_loop_seconds() -> int:
    return _env_int("NINA_AUDIO_SILENCE_KEEPALIVE_SEC", 2, 1, 30)


def _audio_edge_silence_ms() -> int:
    default = 80 if _silence_keepalive_enabled() else 0
    return _env_int("NINA_AUDIO_EDGE_SILENCE_MS", default, 0, 2000)


def _amp_enable_gpio_pin() -> Optional[int]:
    raw = (os.environ.get("NINA_AUDIO_AMP_ENABLE_GPIO") or "").strip()
    if not raw:
        return None
    try:
        pin = int(raw)
    except ValueError:
        return None
    return pin if pin >= 0 else None


def _amp_pre_enable_delay_sec() -> float:
    return _env_int("NINA_AUDIO_AMP_PRE_ENABLE_MS", 40, 0, 1000) / 1000.0


def _amp_post_disable_delay_sec() -> float:
    return _env_int("NINA_AUDIO_AMP_POST_DISABLE_MS", 80, 0, 5000) / 1000.0


def _amp_gpio_setup() -> bool:
    """Configure optional MAX98357A SD/enable GPIO. No-op unless env is set."""
    global _AMP_ACTIVE_HIGH, _AMP_GPIO, _AMP_PIN, _AMP_SETUP_FAILED
    pin = _amp_enable_gpio_pin()
    if pin is None:
        return False
    with _AMP_LOCK:
        if _AMP_GPIO is not None and _AMP_PIN == pin:
            return True
        if _AMP_SETUP_FAILED:
            return False
        try:
            import Jetson.GPIO as GPIO  # type: ignore

            GPIO.setmode(GPIO.BCM)
            GPIO.setwarnings(False)
            _AMP_ACTIVE_HIGH = _env_bool("NINA_AUDIO_AMP_ENABLE_ACTIVE_HIGH", True)
            inactive = GPIO.LOW if _AMP_ACTIVE_HIGH else GPIO.HIGH
            GPIO.setup(pin, GPIO.OUT, initial=inactive)
        except Exception as exc:
            _AMP_SETUP_FAILED = True
            print(f"[audio] amp enable GPIO setup failed for BCM {pin}: {exc}")
            return False
        _AMP_GPIO = GPIO
        _AMP_PIN = pin
        return True


def _amp_set_enabled(enabled: bool) -> None:
    if not _amp_gpio_setup():
        return
    gpio = _AMP_GPIO
    pin = _AMP_PIN
    if gpio is None or pin is None:
        return
    level = gpio.HIGH if (enabled == _AMP_ACTIVE_HIGH) else gpio.LOW
    try:
        gpio.output(pin, level)
    except Exception as exc:
        print(f"[audio] amp enable GPIO write failed for BCM {pin}: {exc}")


def _amp_begin_playback() -> bool:
    """Enable amp for one playback. Returns True when this call owns a user ref."""
    global _AMP_USERS
    if _silence_keepalive_enabled():
        return False
    if _amp_enable_gpio_pin() is None:
        return False
    with _AMP_LOCK:
        first = _AMP_USERS == 0
        _AMP_USERS += 1
    if first:
        _amp_set_enabled(True)
        delay = _amp_pre_enable_delay_sec()
        if delay > 0:
            time.sleep(delay)
    return True


def _amp_end_playback() -> None:
    global _AMP_USERS
    if _amp_enable_gpio_pin() is None:
        return
    with _AMP_LOCK:
        if _AMP_USERS <= 0:
            _AMP_USERS = 0
            return
        _AMP_USERS -= 1
        last = _AMP_USERS == 0
    if last:
        delay = _amp_post_disable_delay_sec()
        if delay > 0:
            time.sleep(delay)
        _amp_set_enabled(False)


def _mp3_via_aplay_enabled() -> bool:
    """Decode MP3 to a temporary WAV first, then play it with ``aplay``.

    Some Jetson APE/I2S paths (notably Orin Nano -> MAX98357A) play a clean
    sine wave through ``aplay`` but fail or produce garbage when ``mpg123`` is
    asked to write directly to ALSA. The decode-to-WAV path uses ``mpg123`` only
    as a file decoder, then lets ``aplay`` own the ALSA stream. Enable with:

        NINA_AUDIO_MP3_VIA_APLAY=1
    """
    raw = (os.environ.get("NINA_AUDIO_MP3_VIA_APLAY") or "").strip().lower()
    return raw in ("1", "true", "yes", "on")


def _aplay_stereo_mode() -> str:
    """Stereo channel layout for MP3-via-aplay temporary WAV playback.

    ``none`` keeps the decoded WAV as-is. ``left`` / ``right`` / ``dual``
    convert decoded PCM to 2-channel WAV, placing mono source audio into the
    requested I2S slot. This is needed for MAX98357A breakouts strapped to a
    specific slot: the reference Orin Nano build only plays the left slot, while
    right-only WAVs are silent.
    """
    raw = (os.environ.get("NINA_AUDIO_APLAY_STEREO_MODE") or "none").strip().lower()
    if raw in ("left", "right", "dual", "both", "stereo"):
        return "dual" if raw in ("both", "stereo") else raw
    return "none"


def _digital_gain_pct() -> int:
    """App-level gain for decoded WAV playback.

    MAX98357A has no software mixer, and Jetson APE often exposes no useful
    ``Master`` control for this path. This gain is applied while generating the
    temporary WAV used by ``NINA_AUDIO_MP3_VIA_APLAY=1``.
    """
    raw = (os.environ.get("NINA_AUDIO_GAIN_PCT") or "100").strip()
    try:
        pct = int(raw)
    except ValueError:
        return 100
    return max(0, min(100, pct))


def _restore_volume_default_pct() -> int:
    try:
        return max(1, min(100, int(os.environ.get("NINA_AUDIO_RESTORE_VOLUME_PCT", "75"))))
    except ValueError:
        return 75


def _aplay_device_flag() -> Optional[str]:
    d = (os.environ.get("NINA_GREET_APLAY_DEVICE") or "").strip()
    return d or None


def _pcm_output_rate_hz() -> Optional[int]:
    """Sample rate (Hz) for preroll WAV and ``mpg123 -r``.

    * **Default** 24000 — matches typical gTTS / greeting MP3s in-repo.
    * ``48000`` / ``44100`` / etc. — force decoder output and preroll to that rate.
    * ``auto`` / ``native`` — do not pass ``-r`` to mpg123; preroll still uses
      :data:`_GREETING_MP3_SAMPLE_RATE_HZ` so the warmup matches greeting clips.
    """
    raw = (
        os.environ.get("NINA_AUDIO_OUTPUT_RATE") or str(_GREETING_MP3_SAMPLE_RATE_HZ)
    ).strip().lower()
    if raw in ("auto", "native"):
        return None
    try:
        hz = int(raw)
    except ValueError:
        return _GREETING_MP3_SAMPLE_RATE_HZ
    if hz <= 0:
        return None
    return max(8000, min(192000, hz))


def _preroll_wav_sample_rate_hz() -> int:
    """Warmup / silence WAV rate (must match the PCM rate mpg123 will send next)."""
    forced = _pcm_output_rate_hz()
    return _GREETING_MP3_SAMPLE_RATE_HZ if forced is None else forced


def _parse_volume_pct_from_text(text: str) -> Optional[int]:
    """First ``NN%`` in pactl/amixer output (e.g. 50% / ... dB)."""
    if not text:
        return None
    m = re.search(r"(\d{1,3})%", text)
    if not m:
        return None
    v = int(m.group(1))
    return v if 0 <= v <= 150 else None


def _ensure_preroll_wav(ms: int, sample_rate: int) -> Optional[Path]:
    if ms <= 0:
        return None
    cache = _repo_root() / "nina" / "data" / ".cache"
    try:
        cache.mkdir(parents=True, exist_ok=True)
    except OSError:
        return None
    path = cache / f"preroll_silence_{ms}ms_{sample_rate}.wav"
    if path.exists() and path.stat().st_size > 0:
        return path
    nframes = max(1, int(sample_rate * (ms / 1000.0)))
    try:
        with wave.open(str(path), "wb") as w:
            w.setnchannels(1)
            w.setsampwidth(2)
            w.setframerate(sample_rate)
            w.writeframes(b"\x00\x00" * nframes)
    except OSError:
        return None
    return path


def _ensure_silence_keepalive_wav() -> Optional[Path]:
    sample_rate = _preroll_wav_sample_rate_hz()
    seconds = _silence_keepalive_loop_seconds()
    cache = _repo_root() / "nina" / "data" / ".cache"
    try:
        cache.mkdir(parents=True, exist_ok=True)
    except OSError:
        return None
    path = cache / f"keepalive_silence_{seconds}s_{sample_rate}_stereo.wav"
    if path.exists() and path.stat().st_size > 0:
        return path
    try:
        with wave.open(str(path), "wb") as w:
            w.setnchannels(2)
            w.setsampwidth(2)
            w.setframerate(sample_rate)
            w.writeframes(b"\x00\x00\x00\x00" * sample_rate * seconds)
    except OSError:
        return None
    return path


def _silence_pcm_bytes(ms: int, sample_rate: int) -> bytes:
    frames = max(0, int(sample_rate * (ms / 1000.0)))
    return b"\x00\x00\x00\x00" * frames


def _wav_to_stereo_pcm_bytes(
    path: Path,
    *,
    edge_ms: Optional[int] = None,
    sample_rate: Optional[int] = None,
) -> Optional[bytes]:
    mode = _aplay_stereo_mode()
    gain = max(0.0, min(1.0, _digital_gain_pct() / 100.0))
    expected_rate = (
        sample_rate if sample_rate is not None else _preroll_wav_sample_rate_hz()
    )
    try:
        with wave.open(str(path), "rb") as r:
            channels = r.getnchannels()
            sampwidth = r.getsampwidth()
            rate = r.getframerate()
            frames = r.readframes(r.getnframes())
    except (OSError, wave.Error):
        return None
    if sampwidth != 2 or rate != expected_rate:
        return None

    edge = _audio_edge_silence_ms() if edge_ms is None else max(0, int(edge_ms))
    out = bytearray(_silence_pcm_bytes(edge, rate))

    def scale_sample(sample: bytes) -> bytes:
        if gain == 1.0:
            return sample
        v = int.from_bytes(sample, "little", signed=True)
        return int(round(v * gain)).to_bytes(2, "little", signed=True)

    if channels == 1:
        for i in range(0, len(frames), sampwidth):
            s = scale_sample(frames[i:i + sampwidth])
            z = b"\x00" * sampwidth
            if mode == "left":
                out.extend(s)
                out.extend(z)
            elif mode == "right":
                out.extend(z)
                out.extend(s)
            else:
                out.extend(s)
                out.extend(s)
    else:
        frame_width = channels * sampwidth
        for i in range(0, len(frames), frame_width):
            frame = frames[i:i + frame_width]
            if len(frame) < frame_width:
                continue
            left = scale_sample(frame[0:sampwidth])
            right = scale_sample(frame[sampwidth:2 * sampwidth])
            z = b"\x00" * sampwidth
            if mode == "left":
                out.extend(left)
                out.extend(z)
            elif mode == "right":
                out.extend(z)
                out.extend(right)
            else:
                out.extend(left)
                out.extend(right)
    if edge:
        out.extend(_silence_pcm_bytes(edge, rate))
    return bytes(out)


def _mp3_to_stereo_pcm_bytes(path: Path, *, sample_rate: Optional[int] = None) -> Optional[bytes]:
    mpg = shutil.which("mpg123")
    if not mpg:
        return None
    if sample_rate is None:
        rate = (
            _persistent_pipe_sample_rate_hz()
            if _persistent_pipe_enabled()
            else _preroll_wav_sample_rate_hz()
        )
    else:
        rate = sample_rate
    tmp = tempfile.NamedTemporaryFile(prefix="nina-audio-pipe-", suffix=".wav", delete=False)
    tmp_path = Path(tmp.name)
    tmp.close()
    try:
        r = subprocess.run(
            [mpg, "-q", "-r", str(rate), "-w", str(tmp_path), str(path)],
            stdin=subprocess.DEVNULL,
            stdout=subprocess.DEVNULL,
            stderr=subprocess.DEVNULL,
            timeout=15.0,
            check=False,
        )
        if r.returncode != 0:
            return None
        return _wav_to_stereo_pcm_bytes(tmp_path, sample_rate=rate)
    except (OSError, subprocess.TimeoutExpired):
        return None
    finally:
        try:
            tmp_path.unlink()
        except OSError:
            pass


class _PersistentAudioHandle:
    def __init__(self) -> None:
        self._done = threading.Event()
        self._terminated = False
        self.returncode: Optional[int] = None

    def wait(self, timeout: Optional[float] = None) -> Optional[int]:
        if not self._done.wait(timeout):
            raise subprocess.TimeoutExpired("nina-audio-persistent-pipe", timeout)
        return self.returncode

    def poll(self) -> Optional[int]:
        return self.returncode if self._done.is_set() else None

    def terminate(self) -> None:
        self._terminated = True
        self.returncode = -15
        self._done.set()

    def _finish(self, returncode: int = 0) -> None:
        if self._terminated:
            return
        self.returncode = returncode
        self._done.set()


class _PersistentAudioPipe:
    def __init__(self) -> None:
        self._rate = _persistent_pipe_sample_rate_hz()
        self._aplay = shutil.which("aplay")
        self._proc: Optional[subprocess.Popen] = None
        self._queue: Deque[Tuple[bytes, _PersistentAudioHandle]] = deque()
        self._cv = threading.Condition()
        self._stop = False
        self._thread: Optional[threading.Thread] = None
        self._logged_open = False
        self._write_failures = 0

    def start(self) -> bool:
        if not _persistent_pipe_enabled() or not self._aplay:
            return False
        if _amp_enable_gpio_pin() is not None:
            _amp_set_enabled(True)
        with self._cv:
            if self._thread is not None and self._thread.is_alive():
                return True
            self._stop = False
            self._thread = threading.Thread(
                target=self._writer,
                name="nina-audio-persistent-pipe",
                daemon=True,
            )
            self._thread.start()
            return True

    def enqueue(self, pcm: bytes) -> _PersistentAudioHandle:
        handle = _PersistentAudioHandle()
        with self._cv:
            self._queue.append((pcm, handle))
            self._cv.notify_all()
        self.start()
        return handle

    def stop(self) -> None:
        with self._cv:
            self._stop = True
            self._cv.notify_all()
        if self._proc is not None and self._proc.poll() is None:
            try:
                self._proc.terminate()
            except Exception:
                pass
        _set_idle_output_muted(False)

    def _start_aplay(self) -> Optional[subprocess.Popen]:
        if not self._aplay:
            return None
        cmd = [
            self._aplay,
            "-q",
            "-t",
            "raw",
            "-f",
            "S16_LE",
            "-c",
            "2",
            "-r",
            str(self._rate),
        ]
        dev = _aplay_device_flag()
        if dev:
            cmd.extend(["-D", dev])
        cmd.append("-")
        try:
            proc = subprocess.Popen(
                cmd,
                stdin=subprocess.PIPE,
                stdout=subprocess.DEVNULL,
                stderr=subprocess.DEVNULL,
            )
        except Exception as exc:
            print(f"[audio] persistent pipe failed to start: {exc}")
            return None
        if not self._logged_open:
            dev = _aplay_device_flag() or "default"
            idle_mute = "on" if _idle_output_mute_enabled() else "off"
            print(
                f"[audio] persistent pipe opened rate={self._rate}Hz "
                f"device={dev} idle_mute={idle_mute}",
                flush=True,
            )
            if dev in ("default", "sysdefault") and _hdmi_audio_output():
                print(
                    "[audio] WARNING: using ALSA 'default' for HDMI — hiss may "
                    "persist; run: sudo ./scripts/setup-hdmi-audio.sh --list "
                    "then --device plughw:CARD=HDA,DEV=N",
                    flush=True,
                )
            self._logged_open = True
        return proc

    def _write_all(self, data: bytes) -> bool:
        proc = self._proc
        if proc is None or proc.stdin is None or proc.poll() is not None:
            self._proc = self._start_aplay()
            proc = self._proc
        if proc is None or proc.stdin is None:
            return False
        try:
            proc.stdin.write(data)
            proc.stdin.flush()
            return True
        except (BrokenPipeError, OSError):
            try:
                proc.kill()
            except Exception:
                pass
            self._proc = None
            return False

    def _writer(self) -> None:
        chunk = _silence_pcm_bytes(20, self._rate)
        _set_idle_output_muted(True)
        while True:
            with self._cv:
                if self._stop:
                    break
                item = self._queue.popleft() if self._queue else None
            if item is None:
                _set_idle_output_muted(True)
                if not self._write_all(chunk):
                    self._write_failures += 1
                    if self._write_failures in (1, 25) or self._write_failures % 100 == 0:
                        dev = _aplay_device_flag() or "default"
                        print(
                            f"[audio] persistent pipe idle write failed "
                            f"({self._write_failures}x); device={dev}"
                        )
                    time.sleep(0.2)
                else:
                    self._write_failures = 0
                continue
            pcm, handle = item
            if handle.poll() is not None:
                continue
            _set_idle_output_muted(False)
            ok = self._write_all(pcm)
            handle._finish(0 if ok else 1)
        if self._proc is not None and self._proc.poll() is None:
            try:
                self._proc.terminate()
            except Exception:
                pass


def start_persistent_audio_pipe() -> bool:
    """Start the one-open-forever raw PCM aplay pipe, if enabled."""
    global _PERSISTENT_PIPE
    if not _persistent_pipe_enabled():
        return False
    if _PERSISTENT_PIPE is None:
        _PERSISTENT_PIPE = _PersistentAudioPipe()
    started = _PERSISTENT_PIPE.start()
    if started and _idle_output_mute_enabled():
        _set_idle_output_muted(True)
    return started


def _persistent_audio_pipe_play(path: Path) -> Optional[_PersistentAudioHandle]:
    if not _persistent_pipe_enabled():
        return None
    pcm: Optional[bytes]
    ext = path.suffix.lower()
    if ext == ".mp3":
        pcm = _mp3_to_stereo_pcm_bytes(path)
    elif ext == ".wav":
        pcm = _wav_to_stereo_pcm_bytes(path)
    else:
        return None
    if not pcm:
        return None
    if not start_persistent_audio_pipe() or _PERSISTENT_PIPE is None:
        return None
    return _PERSISTENT_PIPE.enqueue(pcm)


def _silence_keepalive_cmd() -> Optional[List[str]]:
    aplay = shutil.which("aplay")
    if not aplay:
        return None
    wav = _ensure_silence_keepalive_wav()
    if wav is None:
        return None
    cmd: List[str] = [aplay, "-q"]
    dev = _aplay_device_flag()
    if dev:
        cmd.extend(["-D", dev])
    cmd.append(str(wav))
    return cmd
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
