MeghanaMadhuri/jetsonuarteyes/(commit log)

2026-05-08 fix(nav): straight bench + pivot breakaway from rest
    - drive_wheels: on symmetric forward/back entry, run drive_continuous +
    kick/cruise like D-pad W/S so Straight 10s moves on first use after boot.
    - Local + remote set_wheels: apply start_kick_sec hold for symmetric pivots
    even when pivot_turn_left_extra_pp already lifts duty above kick %, so
    left/right spins are not stuck until a physical nudge.
    [drive_controller.py, navigation_manager.py]
2026-05-08 feat(vision): ArUco marker approach replaces face follow
    Remove FaceFollowController and Person follow UI. Add ArucoFollowController:
    servo toward a chosen ArUco ID on the RGB preview at Straight-bench speed
    (NINA_STRAIGHT_TEST_SPEED_PCT), with lateral correction and configurable
    stop via NINA_ARUCO_STOP_AREA_FRAC / NINA_ARUCO_DICT.
    Extract straight_bench_speed module (no PyQt import) and share with
    drive_screen Straight test; add unit test.
    [aruco_follow_controller.py, drive_screen.py, face_follow_controller.py, straight_bench_speed.py, test_straight_bench_speed.py, vision_screen.py]
2026-05-08 data: printable ArUco marker ID0 DICT_4X4_50 for vision approach
    Matches default NINA_ARUCO_DICT and Vision screen marker ID 0; 400px PNG
    from cv2.aruco.generateImageMarker for laser/inkjet printing.
2026-05-08 fix(drive): clear stale motion state after stop and bridge watchdog
    - DriveController: always clear _active_drive in finally for stop and
    e-stop so heartbeat cannot replay a wedged Straight command.
    - turn_90: finally block calls nav.stop and clears _active_drive on errors.
    - RemoteNavigationManager: EVT WATCHDOG resets last PWM / straight flags
    so Jetson rest logic matches Pi soft-stop.
    [drive_controller.py]
2026-05-08 nav: remote Pi bridge defaults align with RPi TCP reference
    When NINA_NAV_MODE=remote, load_settings now seeds default speed 13%,
    DIR/PWM settle 0.1 s, and post-STOP chain gap 0.25 s (Sirena_Humanoid-2 /
    UBOT_app timing). Local GPIO defaults unchanged. RemoteNavigationConfig
    defaults and navigation_factory docs updated; add regression tests.
2026-05-08 nav: Jetson GPIO default; Pi bridge legacy
    - systemd: nina-ui-kiosk + nina-link use NINA_NAV_MODE=local; drop
    NINA_NAV_REMOTE_* from stock units. navigation.env example matches.
    - installers: install-nina-link-jetson embedded unit + kiosk script comments.
    - docs: README, REQUIREMENTS (reordered §5 bring-up), COMPANION_APP, NINA_APP;
    PINMAP + pi_motor_bridge module docs clarify Jetson production vs Pi path.
    - settings + navigation_factory: document local as production default.
    - drive: NINA_DRIVE_LEFT_FWD_EXTRA_PP optional left forward trim; test.
2026-05-08 docs: as-built JYQD harness pin map + navigation env overrides
    - PINMAP: 40-pin field wiring (LEL/REL/LZF/RZF, PWM signals, GND) with BCM
    and NINA_NAV_*; note on shared VR on pin 33.
    - nina-link-navigation.env.example: commented NINA_NAV_* block for that loom.
2026-05-08 ui: Jetson-first BLDC copy + nav mode in drive state
    - Drive pill: "Jetson GPIO" vs "motor bridge (port)"; state carries navigation_mode.
    - Straight-test and remote PING errors steer operators to NINA_NAV_MODE=local
    when JYQDs are on the Jetson; Health BLDC row notes GPIO vs UART backend.
    - NinaService passes navigation settings into DriveController.
    [drive_controller.py, drive_screen.py, health_collector.py, nina_service.py]
2026-05-08 drive: surface BLDC init errors, retry init, Jetson PWM guidance
    - DriveController: set init-attempted only after success; shutdown partial
    nav on failure; driver_message BLDC init failed — … for UI.
    - Drive screen: amber pill shows any disconnect message + tooltip; manual
    hints for motor bring-up; keyboard brake/disconnect feedback (prior).
    - JetsonBackend: PWM error text points to BCM 12/13, jetson-io, wiring.
    - PINMAP + navigation.env.example: VR must use HW PWM pins on Jetson.
    [drive_controller.py, drive_screen.py, gpio_backend.py]
2026-05-08 systemd: NINA_NAV_MODE=local after navigation.env (no stale remote UART)
    /etc/nina-link/navigation.env was loaded after unit defaults, so old
    NINA_NAV_MODE=remote + NINA_NAV_REMOTE_PORT=/dev/ttyTHS1 overrode Jetson GPIO
    and made the GUI try the Pi bridge.
    - nina-link + kiosk + install heredoc: defaults, optional file, then
    re-assert local mode (Pi fleets use systemctl edit override).
    - env example: document shared file + ttyTHS1 pitfall.
2026-05-08 settings: Pi UART bridge opt-in (ignore stale NINA_NAV_MODE=remote)
    RemoteNavigationManager only activates when NINA_NAV_LEGACY_PI_BRIDGE=1.
    Otherwise remote+ttyTHS1 exports from old configs/shells coerce to local GPIO.
    - Tests + env example + systemd comments updated for Pi fleets.
2026-05-08 fix(Drive): Straight test restore — remove accidental recursion
    _restore_after_straight_test wrongly called itself and inlined stop logic,
    which blew the stack / wedged the UI (Straight stayed disabled). Restore
    _finish_straight_test for Space/brake/empty-segment paths.
    [drive_screen.py]
2026-05-08 Jetson Orin Nano: canonical JYQD wiring docs and pin diagnostics
    - Document production loom in PINMAP.md and navigation.env.example; add
    JETSON_ORIN_NANO_BOARD_BY_BCM + jetson_orin_nano_board_pin() helper.
    - Fix motor_direction_test and pin_probe messaging/examples for DEFAULT_PINS.
    - Default HC-SR04 rear_right TRIG to BCM 27 (avoid L-DIR on BCM 6); update docs.
    - REQUIREMENTS: jetson-io pwm0/pwm2 wording; Drive BLDC pill readiness tooltip.
    [drive_screen.py, hcsr04.py, motor_direction_test.py, navigation_manager.py, pin_probe.py]
2026-05-08 docs: align BLDC pin narrative with Jetson defaults and Pi bridge
    - navigation_manager: clarify protocol vs pin map; fix Note C for HC-SR04;
    tighten NavigationPins docstring and DEFAULT_PINS comment.
    - PINMAP: note Pi L_SIG/R_SIG BCM 24/27 vs Jetson roles.
    - navigation_bldc: clarify R-PWM Jetson pwm2 naming.
    [navigation_bldc.py, navigation_manager.py]
2026-05-08 BLDC: spoken alerts on failures; clearer GPIO EBUSY hint
    - Add bldc_speech_alerts (espeak-ng) and wire DriveController init/drop paths.
    - Document NINA_BLDC_ALERT_SPEECH / COOLDOWN in NINA_APP.md; add unit tests.
    - JetsonBackend: map Errno 16 (device busy) to actionable stop-kiosk/link message.
    [bldc_speech_alerts.py, drive_controller.py, gpio_backend.py, test_bldc_speech_alerts.py]
2026-05-08 fix(gpio): remove invalid 'from exc' after return in busy helper
    [gpio_backend.py]
2026-05-08 CLI: nav-diag-forward for no-motion bring-up; PINMAP troubleshooting
    Minimal symmetric forward (raw _control_speed / remote SET) rules out
    stop+nudge sequencing. Document 24 V, nav-test-pin, custom carrier.
2026-05-08 Add nav-probe-eldir for EL/ZF bench checks
    - diag_arm_forward_pwm_zero_hold on local and remote nav managers
    - CLI nav-probe-eldir with --hold (default 15s) and pin cheat sheet
    - PINMAP troubleshooting step for steady-state EL/ZF probing
2026-05-11 Add NINA_NAV_EL_ACTIVE_LOW for JYQD EL polarity
    Local NavigationManager maps armed/disabled to GPIO via _el_gpio();
    NavigationSettings + factory + load_settings wire the env var.
    nav-probe-eldir text, PINMAP note, motor_direction_test parity,
    unit tests for active-high vs active-low mapping.
2026-05-11 Docs: DIR-to-GND symptom is Z/F polarity, not EL active-low
    Clarify PINMAP troubleshooting; note NINA_NAV_EL_ACTIVE_LOW is EL-only;
    prefer NINA_NAV_INVERT_* when direction line behavior suggests wrong F/R sense.
    [navigation_manager.py, settings.py]
2026-05-11 CLI: nav-print-config + clarify invert vs no-motion
    Print resolved nav flags/pins; nav-test-direction uses get_invert_* and
    explains invert only swaps F/R; PINMAP same-polarity drivers + env check.
    [main.py]
2026-05-11 nav-print-config: restore full output; clarify forward Z/F line
2026-05-11 fix: nav-diag-forward uses _start_both_wheels (kick + DIR gap)
    diag_symmetric_forward previously called _control_speed only and skipped
    prepare, dir_pwm_gap, start_kick, and pwm reassert — hubs often stalled
    from rest. Align with forward() path; document NUDGE_SEC=0 for bench.
    [main.py, navigation_manager.py]
2026-05-11 CLI: nav-probe-wiring — sequential EL/ZF toggle + VR PWM for harness debug
2026-05-11 PINMAP: Orin jetson-io pwm7/pwm5 naming for pins 32/33
2026-05-11 Remove Pi UART remote navigation; Jetson GPIO only
    Drop RemoteNavigationManager, nav_bridge_test, and remote settings fields.
    NavigationFactory always builds NavigationManager. Simplify UI health/drive
    copy, CLI probes, systemd env examples, and docs. Pi motor bridge docs point
    to serial_test client for bench UART. Delete remote navigation tests.
2026-05-11 Scrub obsolete Pi UART nav env vars (NINA_NAV_MODE et al.)
    load_settings pops legacy keys so processes never see remote mode.
    launch-sirena.sh unsets them before GUI start. systemd units use
    UnsetEnvironment after navigation.env. Installer strips keys from
    /etc/nina-link/navigation.env with backup. Update comments and Pi README.
2026-05-12 Add nav-diag-forward --side for single-hub bench bring-up
    Expose NavigationManager.diag_single_side_forward: one wheel forward with
    the opposite driver EL disabled (PWM 0). CLI --side left|right|both
    (default both preserves prior symmetric behavior).
2026-05-12 Add Arduino Uno JYQD dual-motor bridge sketch
    ZF/turn polarity matches NavigationManager (Nina). Serial F/B/L/R + speed;
    extras path for bench bring-up without Jetson.
2026-05-12 arduino JYQD: document no pull-up required; add ZF settle + kick; legacy polarity switch
    - Clarify 4.7k pull-up is optional hardware, not used by logic
    - enableBothMotorsWithKick mirrors Nina DIR settle and breakaway PWM
    - JYQD_LEGACY_ZF_POLARITY for harness that matched the pre-Nina table
    - Help text shows which build is flashed
2026-05-12 arduino JYQD: harden Z/F for flaky LOW (park, HIGH-first, longer settle)
    - Default LEGACY Z/F polarity to 1 (complementary bench table)
    - Park EL off + VR=0 before each start; refresh pinMode each move
    - When L/R Z/F differ, assert HIGH net before LOW; reassert + delays
    - Stronger kick defaults; stop path zeroes VR before parking Z/F
    - Docs on forward/back asymmetric reliability = marginal LOW at screw
2026-05-12 arduino JYQD: reduce stiction — opposite blip, stronger kick, PWM reassert
    - Optional JYQD_OPPOSITE_BLIP_MS/PWM preload (Nina-style) before target dir
    - kKickMinPwm 118, kKickHoldMs 700, kPwmReassertGapMs second VR write
    - Document tunables; fix file header comment close
    [jyqd_dual_uno.ino]
2026-05-12 arduino JYQD: bump all stiction timings — stronger blip, kick, settles, triple PWM reassert
2026-05-12 arduino JYQD: Pi-style kick_and_set EL/PWM edge sequence for cold start
    - jyqdElEdgeKickThenCruise: warm PWM, EL fall with VR=0, EL rise then kick
    - Matches navigation_bldc.py; JYQD_USE_EL_EDGE_KICK to disable A/B
    - Fix stopMotors missing #if JYQD_LEGACY_ZF_POLARITY
    [jyqd_dual_uno.ino]
2026-05-12 arduino JYQD: fix LEGACY pivot Z/F (L/R were using straight F/B pairs)
    Pivot left needs L back + R fwd (both HIGH in legacy table); pivot right
    both LOW. Nina branch unchanged (both LOW / both HIGH).
    [jyqd_dual_uno.ino]
2026-05-13 feat(nina): hoverboard locomotion via Dynamixel AX-18 lean axes only
    Replace JYQD/GPIO branching with HoverboardAxisDrive on the shared bus
    (IDs 12/13 by default). Wire UI, motor_control CLI, main build_navigation,
    and link robot_bridge through the same path. Add motor_ids EXPECTED list,
    sync-write subset for profile speed, and remove NINA_DRIVE_HOVERBOARD_AXES toggle.
    [drive_controller.py, dynamixel_manager.py, hoverboard_axis_drive.py, main.py, motor_control.py, motor_ids.py, nina_service.py, settings.py]
2026-05-13 feat(nina): hoverboard brake pose defaults + Drive UI copy
    - Config: brake_pos_left/right (515/510), env NINA_HOVER_BRAKE_POS_* with
    legacy NINA_HOVER_NEUTRAL_* fallback; apply on startup and first ensure_bus
    - Rename idle helper to apply_hoverboard_brake_positions; engage_brake uses
    brake reference in code/docs
    - Drive screen: document Dynamixel backend; fix Straight-test not-ready dialog
    [drive_screen.py, hoverboard_axis_drive.py, main.py, nina_service.py, settings.py, startup_service.py]
2026-05-13 config: default hoverboard brake positions 525 / 520
    Raise NINA_HOVER_BRAKE_POS_* and legacy NINA_HOVER_NEUTRAL_* defaults
    from 515/510 to 525/520.
2026-05-13 feat(nina): fixed Dynamixel goals for straight forward (600/605)
    Add forward_pos_left/right with env NINA_HOVER_FWD_POS_*; symmetric
    forward commands use these ticks while reverse and turns keep tilt-from-brake.
    [hoverboard_axis_drive.py, settings.py]
2026-05-13 config: hoverboard brake 525/500, forward lean 540/485
    Defaults for NINA_HOVER_BRAKE_POS_RIGHT and forward FWD_POS_*.
2026-05-13 config: default hoverboard brake left position 515 (13 stays 500)
2026-05-13 feat(ui): Straight back 10s + hoverboard fixed reverse goals
    - HoverboardAxisSettings: backward_pos defaults 505/510 (NINA_HOVER_REV_POS_*)
    - Symmetric backward commands use fixed goals; pivots still use tilt deltas
    - Drive screen: Straight back button, NINA_STRAIGHT_BACK_TEST_MS duration
    [drive_screen.py, hoverboard_axis_drive.py, settings.py]
2026-05-13 config: hoverboard reverse lean defaults 500 / 500
    [settings.py]
2026-05-13 config: hoverboard reverse right default 510 (left 500)
    [settings.py]
2026-05-13 feat(nina): pivot turns from FWD/REV goals + NINA_HOVER_SWAP_TURN_LR
    - Opposite-wheel pivots use forward/back axis goals; optional swap env
    - Drive screen tooltips/docs for turn buttons and hoverboard lean targets
    [drive_screen.py, hoverboard_axis_drive.py, settings.py]
2026-05-13 feat(nina): pivot turn extra lean via NINA_HOVER_TURN_PUSH_TICKS
    Default +5 ticks away from brake per side on in-place pivots; clamp 0–100.
    Drive tooltips document the env var.
2026-05-13 config: default NINA_HOVER_SWAP_TURN_LR on (swap pivot L/R goals)
    Matches hoverboard mount; set NINA_HOVER_SWAP_TURN_LR=0 if reversed.
    Update Drive screen copy/tooltips.
    [drive_screen.py, settings.py]
2026-05-13 feat(android+jetson): Android companion app + lidar/power forward-port
    Squashes 24 commits from nina-arm into a single integration commit
    for forward-porting onto feature/nina-app. Covers:
    * Android companion app (Sirena UI parity: Drive, Map, Vision,
    Find Robot, Settings)
    * Embedded HTTP gateway in sirena_ui/android_gateway/ (replaces
    nina/link_daemon/)
    * jetson_net config + host_control for in-app shutdown/reboot
    * Lidar S2E driver hardening + 'disabled' model + diagnostic
    error formatter
    * Install scripts: install-sirena-companion-jetson.sh,
    install-nina-host-power.sh
    * APK build scripts and Jetson tablet bring-up
    Original 24 commits preserved at tag pre-migration-nina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
    [LinkClient.kt]
2026-05-13 docs(config): spell out hoverboard idle/brake defaults in settings
2026-05-14 Set default hoverboard brake and FWD/REV goals for IDs 12/13
    Brake defaults are 2046 (left) and 2059 (right). Forward and backward
    defaults keep the same tick offsets from the previous 515/500 center.
2026-05-14 feat(hoverboard): optional GPIO relay to cut pack power on brake
    - Add HoverboardPowerRelay (lazy Jetson.GPIO) and env-driven settings
    - engage_brake/release_brake/emergency_stop mirror brake to GPIO when
    NINA_HOVER_POWER_RELAY_BCM is set; initialize() allows power first
    - Docs: docs/HOVERBOARD_POWER_RELAY.md + kiosk drop-in example
    - Unit tests for build_power_relay; fix bcm<=0 disabled
    [hoverboard_axis_drive.py, settings.py]
2026-05-14 Hoverboard: set motor 13 brake default to 2066
    Shift right FWD/REV defaults (+0 / +10 vs brake) to stay aligned with the new brake pose.
2026-05-14 Hoverboard: set motor 13 brake default to 2064
    Keep right FWD/REV at +0 / +10 ticks vs brake (2064 / 2074).
2026-05-14 Hoverboard: set motor 13 brake default to 2063
    Adjust right FWD/REV defaults (+0 / +10 vs brake) to 2063 / 2073.
2026-05-14 Hoverboard: set motor 13 brake default to 2065
    Keep right FWD/REV at +0 / +10 vs brake (2065 / 2075).
2026-05-14 Hoverboard relay: cut at kiosk boot, BCM 26 in unit, singleton GPIO
    Prime pack cut in NinaService before UI; GPIO setup defaults to cut;
    initialize() no longer energises pack before brake pose; process-wide
    relay singleton. Ship NINA_HOVER_POWER_RELAY_BCM=26 in nina-ui-kiosk.service
    (pin 37). Update docs and relay drop-in example; extend relay tests.
    [hoverboard_axis_drive.py, nina_service.py]
2026-05-14 Hoverboard: brake defaults 2051 (L) / 2068 (R)
    Shift FWD/REV defaults with same tick offsets vs brake (+10/-15 left, +0/+10 right).
2026-05-14 Hoverboard relay: pin-37 env, logs; pack only on operator brake release
    - NINA_HOVER_RELAY_HEADER_PIN=37 maps to relay line; kiosk unit uses it
    - INFO on GPIO edge; docs lead with header pin 37
    - set_brake(..., energize_pack=): autonomy/pilots clear software brake
    without energising pack; UI/HTTP release still allows pack power
    - DriveScreen syncs brake pill from controller state; nav release_brake kw
2026-05-14 Hoverboard relay: status LED env, tick test script, diagnostics
    Add NINA_HOVER_RELAY_STATUS_LED_BCM optional GPIO (HIGH=pack allowed).
    Extend HoverboardPowerRelay singleton key and wiring from settings,
    axis drive, and boot prime. Document onboard vs external LED; example
    drop-in and tests. Add Jetson relay tick test and relay diagnostics
    scripts; mention them in bring-up banner.
2026-05-14 Hoverboard: motor 13 brake default 2056 (12 unchanged 2051)
    Right FWD/REV 2056 / 2066 (+0 / +10 vs brake).
2026-05-14 hoverboard_relay_tick_test: default BOARD pin 37, reject bcm 37 mistake
    Use GPIO.BOARD + header pin 37 by default so relay IN matches physical
    wiring; keep --numbering bcm --bcm 26 for Orin Nano. Warn when bcm=37.
2026-05-14 Hoverboard: brake defaults 2053 (L) / 2065 (R)
    FWD/REV shifted with +10/-15 left and +0/+10 right vs brake.
2026-05-14 Hoverboard: brake defaults 2054 (L) / 2072 (R)
    FWD/REV +10/-15 left, +0/+10 right vs brake.
2026-05-14 Hoverboard: brake defaults 1934 (L) / 2162 (R)
    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
2026-05-14 Hoverboard: brake defaults 2048 for motors 12 and 13
    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
2026-05-14 Add Arduino IDE sketch to bench-test 5V relay IN at 5V logic
2026-05-14 Remove hoverboard pack power relay (Jetson + Android)
    Drop GPIO relay module, env parsing, kiosk NINA_HOVER_RELAY_* lines,
    scripts, docs, and bench sketches. HoverboardAxisDrive brake paths are
    servo-only again; DriveController.set_brake(on) without energize_pack;
    NavigationManager.release_brake() simplified. Update pilots, gateway
    docstrings, LinkClient KDoc, and tests.
2026-05-14 feat(hover): MX-28 lean axes, hall-idle brake at 2048/2048
    - Default brake/neutral and FWD/REV goals for joint-mode ticks; pivots unchanged in logic
    - Docs and UI strings: AX-18 -> MX-28 for IDs 12/13
2026-05-14 fix(drive): ensure_bus before hover init; scale MX-28 lean deltas
    - Drive on_enter: open Dynamixel bus before DriveController init to avoid races
    - NINA_HOVER FWD/REV defaults use ~4x tick delta (angle match to legacy AX tuning)
    [drive_screen.py, settings.py]
2026-05-15 fix(dxl): force hover lean MX servos out of wheel mode
    - ensure_joint_mode_for_ids: if CW/CCW limits are 0, set joint range before torque on
    - Call from NinaService.ensure_bus and StartupService.boot (IDs 12/13)
    [dynamixel_manager.py, nina_service.py, startup_service.py]
2026-05-15 fix(hover): drop kiosk straight-tilt override; faster lean Moving Speed
    - Remove NINA_HOVER_STRAIGHT_TILT_DEG from kiosk (it scaled lean to near-zero at 5% cruise)
    - Default NINA_HOVER_MOVING_SPEED 0 (max joint slew on P1)
    - Clarify navigation.env.example for tilt-deg vs FWD/REV tick goals
    [settings.py]
2026-05-15 config(hover): forward FWD trim — ID12 −5, ID13 +5 (2023/2073)
2026-05-15 Add Motion calibration UI for hoverboard lean servos.
    Introduce a Drive-screen entry that opens Motion calibration with
    forward/backward sliders, live preview, JSON persistence under
    ~/.config/sirena/, and merge into load_settings. Persisting
    calibration rebuilds the drive controller and rebinds face follow
    and autonomy. Add a Neutral button to park servos at brake pose.
2026-05-15 Motion calibration: replace sliders with -/+ step buttons.
    Each motor goal adjusts by one Dynamixel tick per click (0–4095)
    with live preview; copy and tooltips updated accordingly.
2026-05-15 Fix kiosk OOM after motion calibration save
    Saving FWD/REV goals was recreating DriveController without shutting
    down the old worker threads (exit 137). Apply new axis settings in
    place via update_axis_config instead of invalidating drive.
    [drive_controller.py, drive_screen.py, hoverboard_axis_drive.py, nina_service.py]
2026-05-15 Fix kiosk UI lag: stop blocking the Qt event loop
    - Home hero pills: run health collect on a worker thread; timer only
    while Home is visible (was every 5s on GUI thread from any screen).
    - Health screen: async collect on Run all checks.
    - MainWindow: ensure_bus on a background thread at startup.
    - Tablet HTTP polls (drive status, robot health, vision status) no longer
    marshal through the GUI thread; drive status stops calling ensure_hardware
    on every poll.
    - QtCommandPlane: cap GUI work to 2 jobs per event-loop tick.
    - Drive camera preview throttled (~15 fps); vision preview coalesce default 33ms.
    - Skip redundant ensure_bus on Drive/calibration when bus already up.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
    [background_tasks.py, drive_screen.py, health_screen.py, home_screen.py]
2026-05-15 Optimize Drive screen for Jetson kiosk responsiveness.
    Defer BLDC/camera init, lazy autonomy, coalesced HUD updates, lighter camera preview, and skip duplicate drive state signals.
    [drive_controller.py, drive_screen.py]
2026-05-15 feat(hoverboard): forward pulse for manual drive (default on)
    Alternate calibrated FWD lean with brake for D-pad/Straight 10s forward;
    env NINA_HOVER_PULSE_*; heartbeat-safe; tests.
2026-05-15 Add Jetson vision installer and wire it into bring-up.
    Install ultralytics into .venv-link for YOLO object detection and point the Vision error dialog at the correct Python.
    [vision_screen.py]
2026-05-15 test(drive): fix FakeNav.drive_continuous for positional args
    DriveController calls drive_continuous(left, right, kick); **kwargs-only
    stub raised TypeError on Jetson where full polarity tests run.
    [test_drive_controller_polarity.py]
2026-05-15 Fix kiosk crash after vision install (OpenCV Qt vs PyQt5).
    Pin Qt platform plugins after PYTHONPATH is set, force opencv-python-headless, and strip cv2/qt if present.
2026-05-15 Make Perception and Map screens open instantly when sensors are offline.
    Defer on_enter, lazy-load SLAM/autonomy, and start lidar/depth/camera work after the UI paints.
2026-05-15 feat(hover): smooth bidirectional forward pulse ramps
    - Ramp brake<->forward both ways with smoothstep easing; ~33Hz steps
    - Default transition NINA_HOVER_PULSE_RETURN_RAMP_SEC 1.5s
    - Docs in settings and env example; tests updated for HoverboardAxisSettings
2026-05-15 fix(hover): lockstep pulse ramps for MX 12/13, linear lerp, resync speed
    - Replace smoothstep+float round with integer lerp so short-travel axis (e.g. ID12) steps every cycle
    - Re-sync Moving Speed at each ramp segment; same 50Hz step schedule both directions
    - Allow 0s forward/brake hold for continuous motion; guard all-zero phases against busy-loop
    - Log pulse FWD/brake targets once for calibration verification
    [hoverboard_axis_drive.py, settings.py]
2026-05-15 config(hover): default pulse FWD/brake dwell to 0 (ramp-only without env)
2026-05-15 feat(hover): coast blend + smoothstep pulse for continuous smooth motion
    - Oscillate between full FWD and coast pose (blend toward brake, default 22%) not full brake
    - Ramps use smoothstep with monotonic rounding; avoids stop-go jerk at reversal
    - If ramp and both holds are 0, apply 0.35s minimum ramp instead of useless busy-loop
    - NINA_HOVER_PULSE_COAST_BLEND; tests/env updated
    [hoverboard_axis_drive.py, settings.py, test_hover_forward_pulse.py]
2026-05-15 feat(hover): optional present-position sync on forward pulse ramp steps
    - NINA_HOVER_PULSE_SYNC_PRESENT waits until Present within TOL of goal or step timeout
    - Polls REG_PRESENT_POS under bus lock; default off to avoid slower ramps / bus load
    - Document env vars; FakeDxl tracks present for tests
    [hoverboard_axis_drive.py, settings.py, test_hover_forward_pulse.py]
2026-05-15 fix(ui): define _BusInitThread so Dynamixel ensure_bus actually runs
    ae9862a moved bus init to a worker thread but never added the QThread
    subclass, so initialize_bus() was never called and Drive saw 'Dynamixel bus
    is not initialized'. Run ensure_bus in _BusInitThread.run and emit health/errors.
2026-05-15 config(hover): ID12 FWD -3 ticks, 3s pulse ramps, 15s straight bench
    - Default forward_pos_left 2020 (was 2023); ramp 3s each way, dwell 0/0 for steady coast↔FWD
    - Denser ramp steps (~59Hz) for long ramps; Straight bench defaults/UI 15s
2026-05-15 feat(hover): pulse ramp profiles, trapezoid velocity, pulse-only MS
    - Quintic smootherstep default; optional smoothstep, cubic_io, trapezoid blend
    - NINA_HOVER_PULSE_RAMP_TRAP_EDGE for trapezoid accel/decel fraction
    - NINA_HOVER_PULSE_RAMP_MOVING_SPEED overrides MX speed only during ramps
    - Restore axis moving_speed after each ramp segment; monotonic blend test
2026-05-15 Hover pulse: cosine/dual_ramp, 1.5s cycle defaults, straight 20s bench
    - Default RETURN_RAMP_SEC 0.75 (1.5s full cosine coast↔FWD↔coast); cosine vs dual_ramp in drive loop
    - Cap inter-cycle coast dwell (NINA_HOVER_PULSE_BRAKE_SEC) at 0.5s in settings and loop
    - Straight bench default 20s; UI label Straight 20s; env example updates
    - Restore AutonomySettings dataclass; pulse_waveform in tests; drive docstrings
2026-05-15 Pulse: default 4s cycle (2s forward hold + 2s coast), ramp 0; remove 0.5s coast cap
    - NINA_HOVER_PULSE_FWD_SEC/BRAKE_SEC defaults 2; RETURN_RAMP_SEC default 0 for exact 4s timing
    - Revert coast dwell max 0.5s; allow up to 10s from env again
    - Docs and env.example updated
    [hoverboard_axis_drive.py, settings.py]
2026-05-15 Remove hover forward pulse; restore continuous forward in UI
    - HoverboardAxisDrive: drop pulse thread/ramps; stub pulse API, start_pulse -> forward()
    - DriveController: D-pad forward from stop uses kick/cruise like back; comment pulse bench hooks
    - DriveScreen: Straight bench always drive_wheels (pulse path commented)
    - Settings/env: document NINA_HOVER_PULSE_* as legacy compatibility only
    - Skip hover pulse tests; polarity test expects kick/cruise not start_pulse
    [drive_controller.py, drive_screen.py, hoverboard_axis_drive.py, settings.py, test_drive_controller_polarity.py, test_hover_forward_pulse.py]
2026-05-15 Hoverboard: +5 raw ticks past FWD goals on symmetric straight forward
    Nudge calibrated forward_pos L/R further from each brake pose so the
    driver is more likely to trigger; clamped to valid MX range.
2026-05-15 Hoverboard: symmetric straight FWD nudge 5→8 ticks past calibrated goals
2026-05-15 Hoverboard: symmetric straight FWD nudge 8→10 ticks past calibrated goals
2026-05-15 Hoverboard: symmetric straight FWD nudge 10→30 ticks past calibrated goals
2026-05-15 Hoverboard: symmetric straight FWD nudge 30→40 ticks past calibrated goals
2026-05-15 Hoverboard: symmetric straight FWD nudge 40→35 ticks past calibrated goals
2026-05-15 Hoverboard: symmetric straight FWD nudge 35→30 ticks past calibrated goals
2026-05-15 Hoverboard: symmetric straight FWD nudge 30→20 ticks past calibrated goals
2026-05-15 Hoverboard: symmetric straight FWD nudge 20→8 ticks past calibrated goals
2026-05-15 Hoverboard: symmetric straight FWD nudge 8→17 ticks past calibrated goals
2026-05-15 Hoverboard: symmetric straight FWD nudge 17→14 ticks past calibrated goals
2026-05-15 Hoverboard: symmetric straight FWD nudge 14→16 ticks past calibrated goals
2026-05-15 Hoverboard: symmetric straight FWD nudge 16→14 ticks past calibrated goals
2026-05-15 Add obstacle and battery monitors; straight lean prime before FWD/BACK
    - HC-SR04 obstacle stop: debounced threshold, drive stop, neutral action,
    hover brake, US gTTS; HCSR04Channel + is_jetson_gpio_available; env pins
    default trig BCM 4 (avoid physical pin 35 / audio).
    - ADS1115 I2C pack voltage monitor: low-V TTS, neutral, lean goal; smbus2.
    - Hoverboard: symmetric straight FWD/BACK prime servos 12/13 to 2048
    (configurable) up to 2s before applying lean drive; pivots unchanged.
    - NinaService/MainWindow wiring and tests for debounce and straight prime.
    [ads1115.py, battery_ads1115_monitor.py, hcsr04.py, hoverboard_axis_drive.py, nina_service.py, settings.py, test_battery_ads1115_debounce.py]
2026-05-15 Hoverboard forward pulse: UI wiring and five-pulse series
    Re-enable DriveController and DriveScreen integration for straight
    forward pulse when enabled. Replace infinite pulse loop with a
    finite series: fixed forward holds, near-brake dwell increasing by
    0.2s per pulse, smooth profiled ramps, full brake after five pulses.
    Add HoverboardAxisSettings pulse_series_* fields and env tunables.
    Update tests and settings docs; remove temporary restore file if any
    (stays deleted).
    [drive_controller.py, drive_screen.py, hoverboard_axis_drive.py, settings.py, test_hover_forward_pulse.py, test_hover_straight_prime.py]
2026-05-15 Default forward pulse hold to 1.3s per cycle
    Lower pulse_series_fwd_sec default from 2.0 to 1.3 (NINA_HOVER_PULSE_SERIES_FWD_SEC).
    Align HoverboardAxisDrive getattr fallback and test fixtures.
    [hoverboard_axis_drive.py, settings.py, test_hover_straight_prime.py]
2026-05-15 Forward pulse: coast lean by percent per pulse (NINA_HOVER_PULSE_COAST)
    Near-brake pose is brake-to-forward interpolation: initial percent from
    NINA_HOVER_PULSE_COAST (default 10), plus NINA_HOVER_PULSE_COAST_STEP (default 10)
    each pulse, capped at 100%. Ramps use prev_coast for continuous motion.
    Add pulse_series_coast_initial_pct / pulse_series_coast_step_pct to settings;
    pulse_forward_coast_blend no longer drives the series loop.
    [hoverboard_axis_drive.py, settings.py, test_hover_forward_pulse.py, test_hover_straight_prime.py]
2026-05-15 Default forward pulse hold to 0.6s per cycle
    Set pulse_series_fwd_sec / NINA_HOVER_PULSE_SERIES_FWD_SEC default from 1.3 to 0.6;
    align HoverboardAxisDrive getattr fallback and test fixtures.
    [hoverboard_axis_drive.py, settings.py, test_hover_straight_prime.py]
2026-05-15 Forward pulse: 0.9s hold per cycle, 8 pulses by default
    Raise NINA_HOVER_PULSE_SERIES_FWD_SEC default to 0.9 and
    NINA_HOVER_PULSE_SERIES_MAX default to 8; align getattr fallbacks
    and test fixtures.
    [hoverboard_axis_drive.py, settings.py, test_hover_straight_prime.py]
2026-05-15 Forward pulse: constant coast blend; zero default ramp/coast blend
    Use pulse_forward_coast_blend only for series near-brake pose (remove
    per-pulse percent fields). Default NINA_HOVER_PULSE_COAST_BLEND and
    NINA_HOVER_PULSE_SERIES_MIN_RAMP_SEC to 0. Update docs, env example, and tests.
2026-05-15 Forward pulse: drop coast dwell increment; default coast blend 0.3
    Remove pulse_series_coast_increment_sec / NINA_HOVER_PULSE_COAST_INCREMENT_SEC.
    Near-brake dwell uses only pulse_series_coast_initial_sec every pulse.
    Default NINA_HOVER_PULSE_COAST_BLEND to 0.3 for constant coast lean.
2026-05-15 Hover pulse: coast blend 0.2, series max 12, Straight bench timing
    - Default NINA_HOVER_PULSE_COAST_BLEND and pulse_series_max to 0.2 and 12.
    - Add estimate_forward_pulse_series_duration_sec for pulse-series duration.
    - Drive Straight bench uses estimated duration (+ slack) when pulse is on and test ms unset.
    - Update env example, tests, and Straight button label/tooltip.
2026-05-15 Straight pulse: backward series + Straight front UI label
    - HoverboardAxisDrive: shared symmetric pulse loop; start_pulse_straight_backward;
    pulse thread renamed to series halt for FWD/BACK; is_straight_pulse_series_active.
    - DriveController: D-pad back from stop and bench call backward pulse when enabled;
    start_backward_pulse_bench; supports_forward_pulse requires backward entrypoint.
    - Drive screen: Straight back timer uses pulse estimate when unset; copy says Straight front.
    - Settings doc for symmetric straight pulse; tests for backward pulse + fix ramp test.
    [drive_controller.py, drive_screen.py, hoverboard_axis_drive.py, settings.py, test_hover_forward_pulse.py]
2026-05-16 Add MPU-9250 IMU drift readout during Drive straight tests.
    I2C driver and background monitor integrate gyro Z (bias at startup)
    for yaw drift study. NinaService starts the monitor when
    NINA_IMU_MPU9250_ENABLE is set. Drive HUD shows degrees and left/right
    indicators while Straight or Straight back runs; docs and env test included.
    [drive_screen.py, mpu9250.py, nina_service.py, test_mpu9250_enable.py]
2026-05-16 Hoverboard: unify straight/turn motion across UI, autonomy, and HTTP
    - HoverboardAxisDrive: timed turn_left/turn_right with prime plus asymmetric
    duties (NINA_HOVER_TURN_SLOW_WHEEL_PCT); pivot goal blending for unequal L/R.
    - DriveController: route all drive_wheels straight segments through pulse series
    when enabled (gated per segment so autonomy ticks do not restart pulses);
    equal-speed pivots match turn duty split; D-pad L/R and live speed use outer/slow;
    autonomy/goto pairing aligned for lean convention.
    - Android momentary forward/back/stop uses _do_drive_wheels/_do_stop on worker.
    - Docs and drive screen tooltips for new env defaults (turn duration, slow wheel).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
2026-05-16 Hoverboard: increase pivot turn goal offset ticks 5 → 20
2026-05-16 Hoverboard: fix pivot turn extra ticks — nudge from brake, not raw +Δ
    Uniform +OFFSET on both corner goals could move a target onto that side's
    brake; blended timed turns then computed delta=0 and servos did not move.
    Apply _TURN_PIVOT_GOAL_OFFSET_TICKS via _nudge_goal_from_brake per axis.
    [hoverboard_axis_drive.py]
2026-05-16 Hoverboard: pivot turn brake-nudge offset 20 → 50 ticks
2026-05-16 Hoverboard: pivot turn brake-nudge offset 50 → 100 ticks
2026-05-16 Default timed turn duration 5s -> 3s (NINA_NAV_TURN_SEC and clients)
    Align Jetson navigation, Drive screen, Android companion, docs, and tests.
2026-05-16 Default NINA_HOVER_TURN_PUSH_TICKS to 100 (was 20)
    Stronger pivot lean away from brake by default; still 0-100 clamp. Docs and calibration test fixtures updated.
    [drive_screen.py, settings.py]
2026-05-16 Motion calibration: turn left/right pivots + turn duration (1–5 s)
    Persist pivot goals and turn_duration_sec in hover_calibration.json;
    merge at load_settings. Optional per-turn absolute goals override FWD/REV
    derivation. Drive timed pivots read duration from nav config after env
    overrides. HoverboardAxisDrive: hover_computed_turn_pivot_goals, update_navigation_settings.
2026-05-16 Timed turn default 0.2 s; motion cal duration range 0.1–1 s
    NINA_NAV_TURN_SEC default 0.2; hover_calibration turn_duration_sec clamp
    0.1–1. Android companion turn pulse 200 ms. Docs and Drive tooltips updated.
2026-05-16 Timed turn buttons: full pivot lean (equal blend) + log brake no-op
2026-05-16 Point Drive IMU monitor at i2c-7 on Orin Nano header pins 3/5.
    Default NINA_IMU_I2C_BUS to 7, accept MPU-6050 and MPU-9250 WHO_AM_I,
    enable IMU in the kiosk unit, add smbus2 to requirements-link, and tests.
2026-05-16 config(nav): shorten default timed turn hold to 0.12 s
    Reduces Drive Turn left/right and NINA_NAV_TURN_SEC default from 0.2 s to 0.12 s (40% shorter). Motion calibration saved duration still overrides.
    [drive_controller.py, drive_screen.py, hoverboard_axis_drive.py, navigation_manager.py, settings.py]
2026-05-16 fix(hover): faster tap turns and correct saved turn duration
    Default timed pivot hold is 0.05 s; turn_left/right skip post-stop settle. Fix hover_calibration.json read clamp that forced turn_duration_sec to at least 1.0 s.
    [drive_controller.py, drive_screen.py, hover_calibration.py, hoverboard_axis_drive.py, navigation_manager.py, nina_service.py, settings.py]
2026-05-16 config(nav): shorten default timed turn hold to 0.08 s
    Turn left/right pivot duration reduced from 0.15 s to 0.08 s (NINA_NAV_TURN_SEC).
    [drive_controller.py, drive_screen.py, hoverboard_axis_drive.py, navigation_manager.py, settings.py]
2026-05-16 config(nav): set default timed turn hold to 0.01 s
    Lower turn_duration_sec default and calibration floor from 0.05 s to 0.01 s for near-instant return to brake after Turn left/right.
2026-05-16 feat(hover): timed turn buttons use ~30° partial pivot lean
    Turn left/right blend toward pivot goals at 33% by default (NINA_DRIVE_TURN_PIVOT_DEG=30). Equal sub-100% pivot speeds now interpolate from brake; held D-pad asymmetric pivots unchanged.
2026-05-16 fix(drive): Turn left/right ignore Motion-cal hold duration
    Drive Turn buttons use NINA_DRIVE_TURN_90_SEC / NINA_NAV_TURN_SEC only (default 0s, no sleep). Stops hover_calibration turn_duration_sec from forcing long pivots. Log effective hold on each tap.
    [drive_controller.py, drive_screen.py, hoverboard_axis_drive.py]
2026-05-16 config(drive): Turn left/right default hold 0.2 s
    NINA_NAV_TURN_SEC default for Drive Turn buttons is 0.2 s (still ignores Motion-cal turn_duration_sec).
2026-05-16 config(drive): Turn left/right default hold 0.3 s
    Raise NINA_NAV_TURN_SEC default for Drive Turn buttons from 0.2 s to 0.3 s.
2026-05-16 config(drive): default turn pivot 5 deg and hold 0.2 s
    Reduce timed Turn left/right from 30 deg/0.3 s to 5 deg blend (6%) and 0.2 s hold for gentler yaw taps on Drive buttons.
2026-05-16 config(drive): Turn left/right hold default 1.5 s
    Increase Drive button software hold from 0.2 s to 1.5 s (NINA_NAV_TURN_SEC).
2026-05-16 feat(battery): ADS1115 on I2C2 pins 27/28 with bench test
    Wire pack ADC to header I2C2 (not IMU bus 7): 218k/33k divider, bus discovery, jetson-io helper script, and ads1115_bench_test for live V_pack readout.
2026-05-16 fix(battery): default ADS1115 to i2c-7 on header pins 3/5
    Orin NX carrier uses physical pins 3 SDA and 5 SCL for /dev/i2c-7 (0x48). Bench test and settings defaults updated; IMU may share the same bus at 0x68.
    [ads1115.py, ads1115_bench_test.py, settings.py, test_ads1115_bus_resolve.py]
2026-05-16 fix(battery): R1/R2 divider formula and DMM cal scale ~1.082
    V_pack = V_ain * (R1+R2)/R2 * cal_scale for 218k/33k divider; default cal matches bench DMM 26.3 V vs uncorrected 24.2 V.
    [ads1115.py, ads1115_bench_test.py, battery_ads1115_monitor.py, settings.py, test_battery_pack_voltage.py]
2026-05-16 fix(battery): define ratio before bench test header print
    [ads1115_bench_test.py]
2026-05-16 feat(sensors): ADS1115 pack voltage UI and AT42QT2120 touch reactions
    Expose live battery voltage on Home/Health/header with low-V latch at 23.5 V
    that parks motors 1-13 at 2048 and blocks playback. Add AT42QT2120 on shared
    i2c-7 (pins 3/5) with bench test, gTTS please dont touch me, and neutral park.
2026-05-16 feat(audio): bundled gTTS alerts for low battery and touch
    Add pre-generated US English MP3s under nina/audio/alerts and play them on
    sensor events, with gTTS fallback if files are missing. Update phrase constants
    and add generate-sensor-alert-audio.py for regeneration.
    Fix straight FWD/BACK pulse when it follows a pivot hold (drive_controller).
    [ads1115.py, at42qt2120.py, drive_controller.py, generate-sensor-alert-audio.py, nina_service.py, sensor_alert_audio.py, settings.py, test_drive_controller_polarity.py]
2026-05-16 feat(hover): MPU-9250 yaw-correction on straight pulses + post-turn settle
    Wire the existing Mpu9250DriftMonitor into HoverboardAxisDrive so straight
    forward/back legs self-correct toward zero yaw drift. NinaService threads the
    sampler + begin/end straight hooks into the drive on monitor start (and at
    lazy drive construction when the monitor is already up); the drive layer
    auto-resets/stops the integrator on every entry/exit of a symmetric straight
    key, so D-pad, bench buttons, and autonomy all benefit without UI plumbing.
    During the main and coast holds of both pulse series the drive re-polls the
    yaw sampler at ~20 Hz and biases the lean goals asymmetrically (slow one
    wheel, speed the othe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
    [drive_controller.py, hoverboard_axis_drive.py, nina_service.py, test_hover_imu_correction.py]
2026-05-16 fix(battery): enable ADS1115 monitor by default for UI pack voltage
    Bench test worked but UI showed no reading because the background monitor
    defaulted off. Enable by default, set kiosk env vars, and refresh Drive HUD.
    [drive_screen.py, nina_service.py, settings.py]
2026-05-16 feat(hover): discrete IMU pause-pivot-resume drift correction
    The previous IMU correction biased lean goals asymmetrically every ~50 ms
    mid-pulse so the bot self-yawed back toward straight. The operator perceived
    the resulting wheel-speed differential as uncommanded little turns and "the
    bot picking up speed" during the forward burst, which was not the goal.
    Replace it with discrete pause-pivot-resume inside the pulse holds: when
    |yaw_drift| crosses NINA_HOVER_IMU_CORR_THRESHOLD_DEG the drive brakes, runs
    a closed-loop in-place pivot (same lean geometry as the timed Turn buttons)
    until drift returns inside NINA_HOVER_IMU_CORR_DEADBAND_DEG (or
    NINA_HOVER_IMU_CORR_PIVOT_MAX_SEC elapses), brak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
    [hoverboard_axis_drive.py, test_hover_imu_correction.py]
2026-05-16 feat(sensors): motion-gated IR obstacle stop on I2C-7, drop HC-SR04 monitor
    Replace forward HC-SR04 obstacle stop with GP2Y0E02B on the shared header bus; poll only while driving, stop at 100 cm, and play bundled obstacle alert TTS.
    [drive_controller.py, generate-sensor-alert-audio.py, gp2y0e02b.py, ir_obstacle_stop_monitor.py, nina_service.py, sensor_alert_audio.py, settings.py]
2026-05-16 tune(hover): gentler IMU drift correction + post-pivot cooldown
    Initial pause-pivot-resume defaults were too aggressive on the real bot:
    20% pivot blend + 0.4s pivot cap could yaw the chassis 30+ degrees per
    correction event, and with no rest between events the loop would fire
    another correction the moment the bot started moving forward again. The
    operator saw it as "the bot going crazy with little turns".
    Softer defaults (override per-bot via env if needed):
    THRESHOLD_DEG 3.0 -> 6.0 (only act on noticeable drift)
    DEADBAND_DEG 1.0 -> 1.5 (exit pivot earlier, less overshoot)
    PIVOT_BLEND_PCT 20 -> 8 (about half the timed Turn-button blend)
    PIVOT_MAX_SEC 0.4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
    [hoverboard_axis_drive.py, test_hover_imu_correction.py]
2026-05-16 debug(hover): NINA_LOG_LEVEL gate + per-cycle pulse loop trace
    Adds an opt-in diagnostic for the Straight front/back early-stop regression
    (robot halts at 5-8s instead of running the full ~14s pulse series even with
    IMU correction and every external monitor disabled).
    * sirena_ui.__main__ now honours NINA_LOG_LEVEL=INFO/DEBUG and calls
    logging.basicConfig(force=True) so log.info() messages from the drive,
    hover and sensor stack actually reach stderr. The UI never configured
    the root logger, so prior debug attempts produced no output.
    * HoverboardAxisDrive logs ENTER/EXIT plus a per-cycle "fwd cycle N done
    dt=Xs total=Ys" line for both _forward_pulse_loop and _backward_pulse_loop,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
    [hoverboard_axis_drive.py]
2026-05-16 debug(hover): trim per-cycle INFO spam, keep DEBUG fallback
    The per-cycle ENTER/EXIT/cycle-N log lines added to track the kiosk-vs-bench
    double-instance early-stop have served their purpose. Confirmed root cause was
    a stale kiosk service still bound to the Dynamixel bus while a second
    ``python3 -m sirena_ui`` was launched manually for testing; pulse loop itself
    is correct and runs the full 12 cycles when only one process owns the bus.
    * Drop ENTER / EXIT / "cycle N done dt=..." / "halt SET after ramp-..." /
    "imu_hold returned True" / EXCEPTION INFO lines from both
    ``_forward_pulse_loop`` and ``_backward_pulse_loop``. Operational logs are
    back to the one-line ``hover forward/backward p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
    [hoverboard_axis_drive.py]
2026-05-16 fix(hover): NINA_HOVER_IMU_CORR_INVERT_SIGN + wrong-direction bail
    On-bot diagnostic with everything enabled showed every IMU pivot correction
    adding drift in the *same* direction it was trying to undo:
    drift=+8.20 deg -> pivot left -> drift now +11.18 deg
    drift=+17.97 deg -> pivot left -> drift now +19.32 deg
    drift=+6.97 deg -> pivot left -> drift now +9.26 deg
    The pivot direction is geometrically correct in the un-swapped wheel
    geometry but this chassis runs with NINA_HOVER_SWAP_TURN_LR=1, and the
    MX-28 mount orientation combined with the MPU-9250 mount orientation
    flips the effective drift sign relative to the lean geometry. Until now
    the only escape hatch was editing the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
    [hoverboard_axis_drive.py, test_hover_imu_correction.py]
2026-05-17 refactor(hover): iterative micro-step IMU realign (replace single pivot)
    A single one-shot pivot couldn't reliably zero the bot's natural drift:
    weak settings (8% / 0.12s) undershot and let drift keep growing; aggressive
    settings (40% / 0.5s) slammed the chassis through 30-120° in one event.
    Replace _perform_pivot_correction's middle "apply one big pivot" with a
    closed loop of small ~1° steps that each:
    1. sample drift (with the invert-sign flip),
    2. exit if |drift| <= deadband, overshoots past zero, or grows past
    |initial|+deadband for two consecutive samples (sign-mismatch bail),
    3. RE-EVALUATE pivot direction from the latest sample (so micro-
    overshoots correct on the n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
    [hoverboard_axis_drive.py, test_hover_imu_correction.py]
2026-05-17 tune(hover): stronger micro-steps + momentum-aware IMU realign bail
    Field test with the original micro-step defaults (12% / 0.10s) showed two
    issues:
    1. The pivots were too gentle to physically rotate the chassis — the
    MX-28 servos take >100ms to slew to the goal, so a 0.10s pulse barely
    started motion before being commanded back to brake. The bot didn't
    visibly turn, and in the one realign that ran a full 25 steps, drift
    only moved +0.15° in 5s of micro-stepping (i.e. just *holding* against
    natural drift, never actually correcting it).
    2. The wrong-direction bail fired prematurely on pre-brake angular
    momentum. When the realign brakes from forward motion, the chassis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
    [hoverboard_axis_drive.py, test_hover_imu_correction.py]
2026-05-17 fix(hover): IMU bail must not fire on correct-direction overshoot
    The wrong-direction bail compared |yaw_now| to |yaw_after_warmup| +
    margin, which also triggers when a CORRECT pivot over-rotates the chassis
    past zero: the magnitude grows after the sign flip even though the pivot
    is doing exactly the right thing. With strong micro-step defaults this
    made an over-shooting realign look identical to a wrong-direction
    runaway, and the bail would kill an otherwise-good correction (then the
    next event would re-trigger from a new fresh drift, oscillating).
    Fix: require ``drift_deg * yaw_now > 0`` (same sign as the original
    drift) before considering the wrong-direction bail. Opposite-sign growth
    is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
    [hoverboard_axis_drive.py, test_hover_imu_correction.py]
2026-05-17 feat(hover): proportional micro-step duration (~1 deg-at-a-time realign)
    The fixed-duration micro-step realign worked but always rotated ~5 deg
    per step at the 20% blend defaults. That landed cleanly on big drifts
    (20+ deg) but routinely over-shot small drifts (4-7 deg → -3 to -5 deg
    on the other side). The user's original spec called out exactly this:
    "turn the robot in almost one degree at a time", with the per-step
    amount scaled to the remaining drift.
    Each micro-step's duration is now computed per-iteration as:
    this_step_dur = clamp(
    |last_yaw| / step_rate_dps,
    [step_min_sec, pivot_max_sec],
    )
    aiming to land ~0.5 * deadband short of zero on the next sample so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
    [hoverboard_axis_drive.py, test_hover_imu_correction.py]
2026-05-17 feat(hover): no-progress safeguard for stuck IMU realign loops
    Field test of the proportional-step realign showed an asymmetric failure
    mode: some events converge cleanly in 6 steps (+4.89 -> +1.04 in 1.5 s),
    others get stuck for the full MAX_STEPS budget (15 micro-steps in 3.6 s
    with drift held at start +/-0.3 deg). The stuck case is the MX-28 not
    slewing reliably on short proportional pulses (~50 ms slew latency means
    a 0.10 s pulse can produce <1 deg of rotation), so per-step correction
    gets matched or beaten by natural drift accumulating during the
    brake-settle window.
    Add a no-progress safeguard so a stuck realign exits cleanly instead of
    burning the full step budget:
    * NEW: NINA_HO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
    [hoverboard_axis_drive.py, test_hover_imu_correction.py]
2026-05-17 tune(drive): bump bench-test Straight front/back default 20 s -> 40 s
    User wants longer bench runs to evaluate IMU correction behaviour over
    more cycles. The 20 s fallback in _straight_sequence_spec and
    _straight_back_sequence_spec is the value used when both
    NINA_STRAIGHT_TEST_MS / NINA_STRAIGHT_BACK_TEST_MS are unset AND the
    hoverboard pulse-bench estimator isn't in play, so bumping it to 40 s
    covers fallback path and any non-hoverboard chassis using these
    buttons.
    Note: on the hoverboard build the actual duration usually comes from
    estimate_forward_pulse_series_duration_sec(axis), which is the
    pulse_series_max × per-cycle estimate (~20 s with default settings).
    To force 40 s there, set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
    [drive_screen.py]
2026-05-17 log(drive): tag IMU realign log lines with (forward)/(backward)
    The IMU pivot-correction code path is symmetric: _backward_pulse_loop
    already calls _imu_corrective_hold the same way _forward_pulse_loop does
    (only the is_forward flag differed, and it was a documented no-op since
    pivot direction is derived from world-frame drift sign). Operator
    nevertheless could not tell from a grep whether backward corrections
    were firing at all -- every log line just said "hover IMU correction:".
    Thread is_forward through _imu_corrective_hold into
    _perform_pivot_correction (new optional kwarg, default True to keep
    existing tests / callers untouched) and prepend a "(forward)" or
    "(backward)" tag to all five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
    [hoverboard_axis_drive.py, test_hover_imu_correction.py]
2026-05-17 feat(drive): direction-aware IMU correction tunables for the backward leg
    Tagged backward logs revealed that the chassis has ~30 deg/s natural yaw
    rate while reversing vs ~0.2 deg/s while going forward (~150x asymmetry,
    mechanical). The forward-only IMU correction tunables (4 deg threshold,
    1.0 s cooldown, 30 deg/s step-rate calibration) let ~30 deg of natural
    drift accumulate between backward corrections, forcing each backward
    realign to do a large catch-up pivot that overshoots and bounces the
    chassis the other way -- the snake pattern the operator described.
    Add three new env vars so the backward leg can be tuned more
    aggressively without disturbing the forward leg (which is currently
    wo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
    [hoverboard_axis_drive.py, test_hover_imu_correction.py]
2026-05-17 feat(drive): IMU stuck detector to break out of no-progress feedback loop
    After tightening the backward cooldown to 0.30 s, field testing exposed
    a second failure mode: when the chassis is STATIONARY the pivot lean
    can't rotate the wheels (the hub motors only push asymmetrically when
    they're already turning), so every realign exits as "no progress". The
    0.30 s cooldown then immediately fires another equally-doomed realign,
    and the bot locks in place spending ~75% of its time pivoting without
    producing any rotation -- and the remaining ~25% isn't enough for the
    pulse loop to build wheel momentum and break the chassis free.
    Add a streak-based stuck detector controlled by two new env vars: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
    [hoverboard_axis_drive.py, test_hover_imu_correction.py]
2026-05-17 tune(drive): lock in field-tested backward IMU defaults (Option B)
    After three field-test iterations on the hoverboard chassis the
    backward-leg IMU correction settled on what the operator called
    "Option B" -- meaningfully better than both the previous defaults
    ("snake" pattern from forward-inherited tunables) and the first
    aggressive backward override ("stuck thrashing" pattern from a 0.3 s
    cooldown that didn't give the bot time to translate between
    corrections). Bake these values in as the in-code defaults so a fresh
    deploy doesn't need any backward-specific env vars to get good
    behaviour:
    - NINA_HOVER_IMU_CORR_BACK_THRESHOLD_DEG 4.0 -> 6.0
    - NINA_HOVER_IMU_CORR_BACK_STEP_RATE_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
    [hoverboard_axis_drive.py, test_hover_imu_correction.py]
2026-05-17 feat(drive,battery): drift-abort safety stop + raise low-battery default to 25.5 V
    * New NINA_HOVER_IMU_CORR_ABORT_DRIFT_DEG (default 30 deg) halts the pulse
    series and announces "I can't move steadily any further, stopping now"
    via TTS the moment the IMU sees catastrophic drift. Brakes cleanly,
    sets the pulse halt event, fires on both forward and backward legs.
    Set to 0 to disable.
    * Low-battery defaults: 23.0 V -> 25.5 V, clear 23.6 V -> 26.1 V
    (preserves 0.6 V hysteresis so a sagging pack does not ping-pong the
    spoken alert). Synced legacy fallback constants in nina/sensors/ads1115.py.
    * New tests for both behaviours; legacy "stuck high" realign tests now
    pin ABORT_DRIFT_DEG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
    [ads1115.py, hoverboard_axis_drive.py, settings.py, test_battery_ads1115_debounce.py, test_hover_imu_correction.py]
2026-05-17 feat(battery): repeating "I'm low on battery" warnings + block all motion until charged
    Operator-facing behaviour:
    * On the first low-battery latch (pack <= 25.5 V), the bot now speaks
    the short phrase "I'm low on battery" via espeak.
    * While the latch is held, every 0.2 V further sag re-speaks the same
    warning so the operator knows the pack is still draining. Step is
    configurable via NINA_BATTERY_REPEAT_STEP_V (set to 0 to disable).
    * All user-initiated motion is refused while latched and speaks the
    same warning: D-pad drive/turn, bench forward/back pulse, asymmetric
    drive_wheels (when non-zero), arm playback, and recording. Brake,
    emergency stop, and the safety neutral-park sta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
    [ads1115.py, battery_ads1115_monitor.py, drive_controller.py, nina_service.py, playback_worker.py, record_worker.py, sensor_alert_audio.py, test_battery_ads1115_debounce.py]
2026-05-17 fix(battery): route low-battery alert through bundled MP3 instead of espeak
    The operator preferred the natural gTTS voice in
    ``nina/audio/alerts/low_battery.mp3`` over the espeak-ng rendering, so
    ``maybe_speak_low_battery`` now plays the bundled clip via
    ``play_low_battery_alert`` (with a gTTS fallback only when the asset is
    missing on a fresh dev box). This applies to all three call sites the
    previous commit unified — the initial latch announcement, the per-0.2 V
    repeat warnings, and the worker refusal alerts — so the operator hears
    the same voice no matter which subsystem fired the alert.
    Playback still runs on a daemon thread so the battery monitor poll
    loop and Qt workers never bloc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
    [ads1115.py, sensor_alert_audio.py, test_sensor_alert_audio.py]
2026-05-17 fix(drive): silence the boot-time "BLDC init failed" male-voice espeak
    On every reboot, ``DriveController._do_init`` was calling
    ``maybe_speak_bldc_alert(f"BLDC init failed. {exc}")`` whenever the
    backend couldn't open — and the exception text often namechecked the
    Dynamixel / servo wiring, so the operator heard a male espeak voice
    announce "BLDC init failed. <some Dynamixel-flavoured traceback>" on
    every cold start. The status pill in the drive screen already shows
    "BLDC not connected" with the driver_message, so the audible alert is
    pure noise.
    Also drop the three sibling user-action alerts ("Drive ignored. Motors
    not ready ...", "Turn ignored. Motors not ready ...", "Straight or
    drive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
    [drive_controller.py]
2026-05-17 feat(audio): add cant_move drift-abort alert MP3
    Generate US English gTTS clip for IMU drift-abort safety stop and play it via sensor_alert_audio instead of espeak.
    [generate-sensor-alert-audio.py, hoverboard_axis_drive.py, sensor_alert_audio.py, test_hover_imu_correction.py]
2026-05-17 feat(drive): closed-loop 90° turns reusing forward IMU micro-step algo
    The Drive screen "Turn left" / "Turn right" buttons used an open-loop
    timed pivot (held the legacy ~15° lean for NINA_DRIVE_TURN_90_SEC,
    default 0.3 s) which produced wildly inconsistent yaw across battery
    levels and floor surfaces. Replaces that path with pulse_turn_90, a
    closed-loop iterative micro-step turn that reuses the exact same
    machinery the forward straight-leg drift correction has been tuned
    with:
    * per-step geometry via _goals_for_wheels (honours operator-tuned
    forward / backward lean positions)
    * proportional per-step duration (rotation_target / step_rate clamped
    to [step_min, step_dur_cap]) — same f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
    [drive_controller.py, hoverboard_axis_drive.py, test_hover_pulse_turn_90.py]
2026-05-17 refactor(drive): remove Motion calibration UI + persisted lean JSON
    The runtime calibration surface (Motion calibration screen, persisted
    hover_calibration.json under ~/.config/sirena/, NinaService persist
    plumbing, hover_calibration loader/merger module) was a moving target
    that confused field debugging — operators would tune lean values via
    the UI, hot-restart, and end up with mismatched defaults vs JSON vs
    env vars. Replaces it with a single source of truth: HoverboardAxisSettings
    defaults in nina/config/settings.py, overridable only via
    NINA_HOVER_* env vars in /etc/nina-link/navigation.env.
    Bakes the operator-validated tune (2022 / 2080 / 2068 / 2028 for
    forward L/R + backward L/R) i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
    [drive_controller.py, drive_screen.py, hover_calibration.py, hoverboard_axis_drive.py, nina_service.py, settings.py]
2026-05-18 refactor(drive): drive-then-check forward loop with at-standstill drift correct
    Replaces the legacy pulse-series + in-motion IMU correction for forward
    motion with a simpler, deterministic cycle: drive forward 1 s at the
    calibrated lean, brake, settle, sample drift at standstill, correct
    with proportional micro-step pivots if needed, then repeat until the
    operator releases the button (or |drift| exceeds 90° -- in which case
    the bot brakes, plays cant_move.mp3, and halts).
    Sampling drift at standstill removes the wrong-direction realigns the
    in-motion algorithm produced: the integrator no longer races with
    active wheel rotation, so each post-leg sample is a clean measurement
    of how much the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
    [hoverboard_axis_drive.py, test_hover_forward_pulse.py]
2026-05-18 fix(drive): drive-then-check drift correction at full pivot lean
    The standstill drift-correct micro-steps were inheriting the legacy
    NINA_HOVER_IMU_CORR_PIVOT_BLEND_PCT=20 — a ~6-8 tick offset from
    brake that hoverboard hub-motor static friction wins against, so
    each correction step logged motion but the chassis never actually
    rotated. Drift would then accumulate across cycles instead of
    shrinking.
    Switch the correction to drive each step at the FULL calibrated
    pivot pose (same lean turn_left / turn_right / pulse_turn_90 use,
    which we've confirmed actually rotates the bot). "Micro" now comes
    from the per-step duration, not from a watered-down lean.
    - New env knobs (dedicated to standstil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
    [hoverboard_axis_drive.py, test_hover_forward_pulse.py, test_hover_imu_correction.py]
2026-05-18 fix(drive): bail drift correction if step makes |drift| worse
    Field test on the bot showed a 9-step runaway: a +5.4 deg drift
    sample triggered a RIGHT pivot, which sent drift to +8.9 -> +23.2
    -> +57.8 deg ... -> +384.9 deg. The pivot direction was wrong
    (operator's NINA_HOVER_IMU_CORR_INVERT_SIGN was lingering from
    earlier tuning), and the correction loop kept compounding the
    error because it only exited on deadband or max_steps.
    Add a "wrong-direction" safety check: if any correction step
    increases |drift| by more than max(0.5 deg, deadband), abort the
    correction loop immediately. The next forward leg samples fresh,
    so the bot rotates at most one bad step (~9 deg cap) instead of
    spinning i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
    [hoverboard_axis_drive.py, test_hover_forward_pulse.py]
2026-05-18 tune(drive): chassis-matched defaults for standstill drift correction
    Field-measured the reference chassis pivot rate at 100% calibrated
    lean: ~140 deg/s (4-5x the inherited 30 deg/s estimate). At the old
    30 deg/s rate the algorithm sized each step expecting a 9 deg
    worst-case rotation, but the bot was actually doing ~43 deg per
    capped step, so a single 5 deg drift would overshoot the deadband
    by ~6 deg and bounce.
    Bump the standstill correction defaults to match measured reality:
    step_rate_dps 30 -> 140
    step_dur_cap 0.30 -> 0.05 (now ~7 deg actual rotation cap)
    step_min 0.08 -> 0.015 (now ~2 deg actual rotation floor)
    deadband 1.5 -> 2.5 (wider, no longer chas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
    [hoverboard_axis_drive.py, test_hover_forward_pulse.py]
2026-05-18 fix(drive): active settle on IMU yaw rate before drift sample/correction
    Field test surfaced the root cause of the "correction commanded left,
    bot kept turning right" runaway: the 0.30 s fixed brake-settle isn't
    long enough for the hoverboard chassis to actually stop rotating
    after a forward leg, so the drift sample and subsequent 47 ms
    correction pivot were happening while the chassis was still mid-spin
    from the previous leg. The brief pivot can't punch through the
    ongoing rotation, drift compounds, and the bot ends up spinning.
    Replace the fixed-timer brake settle (and the per-step settle between
    correction micro-steps) with an active settle that polls the IMU
    yaw rate and only proceeds o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
    [hoverboard_axis_drive.py, nina_service.py, test_hover_forward_pulse.py]
2026-05-18 fix(drive): bake-in swapped pivot-direction mapping for drift correction
    Field test with active settle in place: chassis confirmed still
    before correction (last yaw_rate ~+/-2 deg/s logged every cycle),
    yet commanding "pivot LEFT" (L=FWD, R=BACK at the dynamixel-lean
    level) consistently rotates the chassis to the RIGHT — the bot ran
    a full circle while every correction step was logged as pivot LEFT
    making drift more positive (more right rotation).
    With the active settle eliminating the "still-spinning when
    correction starts" hypothesis, the only remaining unknown is the
    pivot-label-to-goals mapping. Hardcode the swap as the default: a
    "pivot_left" decision now applies L=BACK, R=FWD goals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
    [hoverboard_axis_drive.py, test_hover_forward_pulse.py]
2026-05-18 tune(drive): halve straight-forward leg duration default to 0.5 s
    Field test of the swap-pivot-dir fix shows the drift-correct loop
    now reliably pulls drift back to deadband every cycle, and most
    cycles stay within deadband without any correction at all. With
    the per-leg drift accumulation on this chassis sitting in the
    10–25 deg range over a 1 s leg, the correction loop is doing
    larger excursions per cycle than necessary — and the operator has
    to hold the bot at the end of each leg if a correction misses.
    Drop the default forward-leg duration from 1.0 s to 0.5 s:
    - Halves the worst-case drift the correction has to chase each
    cycle (the bot deviates ~half as far before being pulled ba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
    [hoverboard_axis_drive.py, test_hover_forward_pulse.py]
2026-05-18 tune(drive): widen straight-forward drift deadband default 2.5 -> 3.5 deg
    Field test with the 0.5 s leg + swap-pivot-dir fix runs straight
    for 38 of 40 cycles. Of the 7 corrections that fired, one (cycle 2:
    +8.65 deg) was a real drift that resolved in a single decisive
    0.050 s kick; the other six were all near-deadband cases (drift
    +/- 2.88..3.92 deg) that ground through 4-6 minimum-floor
    0.015 s kicks chasing IMU noise. One of those (cycle 40, drift
    -3.47 deg) ended with the chassis kicking sideways below the
    slop threshold and the active-settle timeout bailing — visible to
    the operator as "a small pivot in the wrong direction at the fag
    end".
    Root cause: at drifts within ~1.5 deg of the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
    [hoverboard_axis_drive.py, test_hover_forward_pulse.py]
2026-05-18 fix(drive): target zero in standstill correction + retune deadband to 3.0 deg
    Operator report: bot seems to not correct drift when drifting to
    the right. Data review of the prior run shows two failure modes
    that fit:
    1. Per-step kick is too weak near the deadband edge. The duration
    formula targeted ``|drift| - 0.5*deadband`` of rotation (aim to
    land half-deadband short of zero) which, at the 3.5 deg
    deadband, gave only ~1.85 deg of rotation budget for a 3.6 deg
    drift — hit the 0.015 s step floor (2.1 deg theoretical at
    140 dps) and chassis stiction defeated it. Field log showed
    left-drift corrections grinding through 4-6 minimum-floor steps
    at ~10 dps effective rate w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
    [hoverboard_axis_drive.py, test_hover_forward_pulse.py]
2026-05-18 fix(drive): raise step-min floor to 0.030 s to overcome chassis stiction
    Field log of a 45-cycle straight-forward run shows the failure
    mode in sharp relief. Cycle 1 with drift +7.41 deg ran one 0.044 s
    kick and pulled drift cleanly to +2.18 deg (5.23 deg of rotation,
    119 dps effective — chassis fully responded to the commanded
    pivot). Cycle 8 with drift -3.25 deg ran *15 consecutive 0.015 s
    kicks* commanding the same direction and the chassis went the
    WRONG way most of the time — net effect was drift *worsening*
    from -3.25 deg to -4.35 deg before max_steps fired.
    Root cause: the 0.015 s minimum-floor step is below the chassis's
    "reliably responds to a commanded pivot" threshold. At a 1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
    [hoverboard_axis_drive.py, test_hover_forward_pulse.py]
2026-05-18 tune(drive): smaller multi-step corrections (60% blend, 30 ms cap)
    Field-tested 70e5743 (step_min raised to 0.030 s) showed a new
    failure mode: corrections now over-rotate. Multiple cycles with
    moderate drift (3-7 deg) ran one 0.030-0.050 s kick and produced
    9-26 deg of actual rotation, overshooting to the opposite side
    of the deadband. Worst cases observed in the log:
    - +11.47 deg drift, one 0.050 s kick -> -4.77 deg (over 4.77 deg)
    - +8.54 deg drift, one 0.050 s kick -> -17.46 deg (wrong dir, bailed)
    - +3.46 deg drift, one 0.030 s kick -> -5.71 deg (over 5.71 deg)
    - +7.50 deg drift, one 0.050 s kick -> -4.89 deg (over 4.89 deg)
    Root cause: at 100% calibrated pivot lean, the ki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
    [hoverboard_axis_drive.py, test_hover_forward_pulse.py]
2026-05-18 fix(drive): correct drift back to ~0 (residual hysteresis), not just to deadband edge
    Each forward leg + correction was leaving 0.5–2.2° of residual heading
    drift inside the 3° deadband. Same-sign residuals compounded
    cycle-after-cycle into a mild curve over time, despite per-cycle
    corrections looking "decent" in isolation.
    Decouple the trigger threshold from the exit threshold:
    - DEADBAND_DEG (3.0°, unchanged) fires correction
    - RESIDUAL_DEG (1.0°, new) ends correction
    Once correction starts, it now continues stepping until |drift| ≤ 1.0°
    instead of stopping anywhere ≤ 3.0°. This gives a 2.0° hysteresis
    buffer — drift can wander up to 3.0° before the next correction
    fires,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
    [hoverboard_axis_drive.py, test_hover_forward_pulse.py]
2026-05-18 fix(drive): track CUMULATIVE drift from movement start (not per-leg)
    The per-leg integrator reset was masking the curve. Each forward leg
    was adding +1–2° of yaw bias in the same direction, but because the
    IMU integrator was reset at the start of every leg, the "drift after
    leg" sample never crossed the 3° deadband and no correction fired —
    all while the bot's real-world heading was slowly accumulating that
    bias into the mild curve operators kept observing.
    Field log (cycles 4–21 of 02:03:54 → 02:04:19): drift readings of
    +1.96, +2.10, +1.91, +0.92, +0.77, +0.86, +1.25, +1.49, +1.31,
    +1.50, +0.13, +0.24, +1.40, +2.83, +1.97 — all reported as "within
    deadband, no correction neede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
    [hoverboard_axis_drive.py, test_hover_forward_pulse.py]
2026-05-18 feat(drive): apply drift-corrected algorithm to backward motion too
    Backward motion (Straight back bench + D-pad backward) now uses the
    exact same algorithm as forward: cumulative IMU drift tracking from
    movement start, drive-then-check cycles with active-settle gating,
    and at-standstill micro-step pivot correction with deadband/residual
    hysteresis. The only thing that differs between forward and backward
    is the drive leg's direction (FWD vs REV goals) — pivots, settle,
    abort, and all tuning knobs are direction-invariant by physics.
    Refactor:
    - Rename ``_forward_drift_correct_loop`` → ``_drift_correct_loop(self,
    is_forward: bool)``. The body computes ``direction_label`` and
    ``drive_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
    [hoverboard_axis_drive.py, test_hover_forward_pulse.py, test_hover_imu_correction.py]
2026-05-19 feat(drive): align 90° turn with drift-corrected straight motion
    Bring `pulse_turn_90` (UI Turn Left / Turn Right) and the timed
    `turn_left` / `turn_right` fallback into alignment with the
    drift-corrected straight loop:
    1. Apply `swap_pivot` to the turn geometry. The same chassis-physics
    field finding that motivated `NINA_HOVER_STRAIGHT_CORR_SWAP_PIVOT_DIR`
    applies to the in-place 90° pivot: on the reference chassis,
    commanding `L=BACK, R=FWD` rotates the bot LEFT (not right as the
    conventional convention says). Without the swap, pressing Turn
    Right would rotate the chassis left and the no-progress
    safeguard would bail the turn. New env knob:
    `NINA_HOVER_TURN_SWAP_PIV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
    [hoverboard_axis_drive.py, test_hover_pulse_turn_90.py]
2026-05-19 tune(drive): softer backward drift-correction steps (forward untouched)
    Field logs showed the unified standstill drift correction over-pushes
    when correcting after a backward leg: the same 0.030 s kick that
    produces ~2.5° of clean rotation on forward correction produces 5–8°
    backward, causing visible wobble + multi-step overshoot during the
    correction loop. The chassis has an asymmetric pre-pivot momentum
    profile (backward leg releases more energy through the brake into the
    subsequent pivot than the forward leg does), so the forward-tuned
    0.030 s cap / 0.030 s floor is too aggressive for backward.
    Fix: add `NINA_HOVER_STRAIGHT_CORR_BACK_STEP_DUR_CAP_SEC` (default
    0.020 s) and `NINA_HOVE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
    [hoverboard_axis_drive.py, test_hover_forward_pulse.py]
2026-05-19 fix(drive): nudge backward straight 5 ticks past calibrated lean
    Field observation: the unified drift-corrected backward leg was
    visibly torquing the MX-28 lean stack but not breaking the chassis
    loose into rolling. The forward straight path already commands a
    14-tick push past the calibrated ``forward_pos_*`` (via
    ``_STRAIGHT_FWD_EXTRA_TICKS``); the backward branch of
    ``_goals_for_wheels`` was sending the bare calibrated
    ``backward_pos_*`` with no extra push, which was the source of the
    pre-rolling stiction the operator reported.
    Add ``_STRAIGHT_BACK_EXTRA_TICKS = 5`` and route the backward goals
    through the same ``_nudge_goal_from_brake`` helper the forward branch
    uses. Backward's nudge i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
    [hoverboard_axis_drive.py, test_hover_forward_pulse.py]
2026-05-19 fix(drive): backward push 5→2 + abort on settle-timeout
    Field run with the +5-tick backward nudge spun the chassis out:
    wheel asymmetry on the BLDC side meant the higher-stiction wheel
    broke loose at a different lean magnitude than the lower-stiction
    one, and the +5 push crossed exactly that breakaway gap. Symptom in
    the log was a -668° cumulative drift before the abort finally fired
    at cycle 7 (six full backward legs spent compounding the spin),
    plus a second run that accumulated +81° in three legs and entered a
    correction loop that ran the max 15 steps without converging.
    Two fixes:
    1. Backward nudge default: 5 → 2 ticks. Made tunable via the
    ``NINA_HOVER_STRAIGHT_BACK_EXTRA_TIC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
    [hoverboard_axis_drive.py, test_hover_forward_pulse.py]
2026-05-19 tune(drive): default backward push 2 → 0 (bare calibrated lean)
    Operator wants to baseline at the calibrated backward lean (no nudge)
    to isolate the wheel-asymmetry diagnosis from any extra-push variable.
    At 5 ticks the chassis spun out; at 2 ticks it was still surfacing
    the BLDC-side asymmetry. Default 0 means
    ``_goals_for_wheels(left_dir=DIR_BACKWARD, right_dir=DIR_BACKWARD)``
    commands the operator-tuned ``backward_pos_*`` exactly as calibrated.
    The env-tunable surface stays — operators whose chassis genuinely
    can't break stiction at the calibrated lean can opt in via
    ``NINA_HOVER_STRAIGHT_BACK_EXTRA_TICKS`` (in
    ``/etc/nina-link/navigation.env`` per the reference service config)
    witho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
2026-05-19 tune(drive): backward leg 0.5 → 1.0 s (forward untouched)
    Operator wants a longer perceptible amount of travel between
    standstill drift samples for backward motion — the reference build
    travels less per second backward than forward at the same lean
    magnitude, so the forward-tuned 0.5 s leg feels too short on
    backward.
    Adds ``NINA_HOVER_STRAIGHT_BACK_LEG_SEC`` (default 1.0 s) as an
    independent knob, separate from ``NINA_HOVER_STRAIGHT_LEG_SEC``
    (forward, default 0.5 s). ``_drift_correct_loop`` dispatches on
    ``is_forward`` to pick the right getter; forward branch resolves
    the same getter it always did so the forward path is bit-identical.
    Tests:
    - ``test_straight_back_leg_sec_default_is_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
    [hoverboard_axis_drive.py, test_hover_forward_pulse.py]
2026-05-19 tune(drive): per-side asymmetric BACK trim (L+2, R+3) + leg 1.0 → 0.5 s
    The symmetric ``_STRAIGHT_BACK_EXTRA_TICKS`` model (one magnitude, both
    sides pushed equally further from brake) couldn't address the field-
    observed BLDC wheel asymmetry: pushing both wheels harder by the same
    amount still left the right wheel running faster than the left,
    yawing the chassis. The fix is a SIGNED per-motor trim added straight
    onto the calibrated ``backward_pos_*`` — Motor 12 (left) +2,
    Motor 13 (right) +3 on the reference build. On this chassis the
    combination drives the right wheel slightly CLOSER to brake
    (``backward_pos_right < brake`` → +3 reduces backward lean) and the
    left slightly FURTHER fr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
    [hoverboard_axis_drive.py, test_hover_forward_pulse.py]
2026-05-19 tune(drive): backward per-side trim L+2→+7, R+3→+8 (operator bench bump)
    Bench iteration: at L+2 / R+3 the chassis still showed a small
    residual yaw on backward, so the operator bumped both per-side
    offsets by 5 ticks. New baked-in defaults are L+7 / R+8.
    Concretely on the reference build:
    - Motor 12 (left): 2068 + 7 = 2075 commanded (was 2070).
    - Motor 13 (right): 2028 + 8 = 2036 commanded (was 2031).
    The 1-tick asymmetry between the two sides (right > left by 1) is
    preserved — that was the working bias against the BLDC wheel
    asymmetry; the bump just scales the absolute lean both motors are
    seeing.
    Operators can still override per side via the existing env vars
    ``NINA_HOVER_STRAIG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
2026-05-19 fix(drive): backward per-side trim = nudge from brake, not raw add
    Operator observed at the bench: with the L+7 / R+8 raw-add offsets,
    motor 12 leaned further backward as intended, but motor 13 didn't get
    pushed and the chassis spun on the left wheel only. The bug was the
    "raw signed add" model: on the reference chassis backward_pos_right
    (2028) sits BELOW brake (2048), so adding +8 to it moved the goal
    CLOSER to brake (2036) — i.e. LESS backward lean, not more.
    Switch the per-side BACK offsets to the same `_nudge_goal_from_brake`
    mechanism the forward branch already uses, with independent per-side
    magnitudes. Positive offset is now "more lean" (further from brake)
    regardless of which sid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
    [hoverboard_axis_drive.py, test_hover_forward_pulse.py]
2026-05-19 tune(drive): reset backward per-side trim to 0 / 0 (bare calibrated lean)
    The earlier L+7 / R+8 defaults were dialed against the now-fixed
    raw-add bug; on the corrected nudge-from-brake semantics they were
    too aggressive. Operator reset both per-side offsets to 0 to re-tune
    asymmetric BLDC-wheel compensation from a clean baseline.
    Knobs (NINA_HOVER_STRAIGHT_BACK_{LEFT,RIGHT}_TICKS_OFFSET) and the
    signed nudge-from-brake mechanism are unchanged — only the in-tree
    defaults move. With 0 / 0 the backward leg now drives the bare
    calibrated backward_pos_* (no trim on either side).
    [hoverboard_axis_drive.py, test_hover_forward_pulse.py]
2026-05-19 tune(drive): backward per-side trim 0 / 0 → +5 / +5 (symmetric baseline)
    Operator converged on symmetric +5 ticks of additional backward lean
    on both sides as the clean baseline after restarting from 0 / 0 on
    the (now-fixed) nudge-from-brake semantics. Both wheels get the same
    magnitude of nudge AWAY from brake — no per-side asymmetry by
    default; the env-var knobs remain for chassis-specific bias.
    On the reference chassis (backward_pos_left=2068, backward_pos_right=
    2028, brake=2048) the +5 / +5 defaults now produce:
    - motor 12: 2068 + 5 = 2073 (above brake, MORE lean)
    - motor 13: 2028 - 5 = 2023 (below brake, MORE lean)
    [hoverboard_axis_drive.py, test_hover_forward_pulse.py]
2026-05-19 fix(config): backward calibrated default 2068/2028 → 2000/2000 (bench truth)
    The in-tree backward_pos_* defaults were stale leftovers from an
    earlier tuning iteration (settings.py history: ±400 → ±200 → ±114 →
    ±57 → ±20 → 2068/2028). The operator's bench-validated calibration
    is actually 2000 / 2000 on both wheels — the fast test fixture had
    been carrying the correct values all along, but production was still
    shipping the old ±20 mirror.
    Also reset per-side BACK trims to 0 / 0 so the commanded goal on the
    wire is exactly the calibrated 2000 / 2000 (operator wants no
    additional nudge on top of the bench-validated lean). Knobs
    (NINA_HOVER_STRAIGHT_BACK_{LEFT,RIGHT}_TICKS_O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
    [hoverboard_axis_drive.py, settings.py, test_hover_forward_pulse.py]
2026-05-19 tune(config): asymmetric backward lean L=2005 / R=1995 (operator bench)
    Symmetric 2000 / 2000 was an interim baseline; operator dialed in a
    5-tick asymmetry on the calibrated source itself — left wheel 5 ticks
    above the previous symmetric value (closer to brake) and right 5
    below (further from brake). Per-side trim offsets stay at 0 / 0, so
    the commanded goal on the wire is exactly L=2005 / R=1995.
    Sync the two docstrings (settings.py module doc + nav.env.example)
    that quoted the stale 2000 / 2000 and the controller comment block
    referencing the calibrated source. Test fast fixture is independent
    of these production defaults so the hover suite is unaffected.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
    [hoverboard_axis_drive.py, settings.py]
2026-05-19 tune(config): backward lean L=2010 / R=1990 (operator bench)
    Wider asymmetric BACK lean — left bumped from 2005 → 2010 (further
    above brake), right from 1995 → 1990 (further below brake). Both
    wheels get +5 more ticks of lean past the prior asymmetric pose;
    per-side trim (_STRAIGHT_BACK_*_TICKS_OFFSET) stays at 0 / 0 so the
    commanded goal on the wire is exactly 2010 / 1990.
2026-05-19 tune(config): backward lean L=2051 / R=2043 (mild, near-brake)
    Operator bench iteration: tighten backward lean to a very mild
    near-brake pose — L=2051 (just 3 ticks above brake=2048), R=2043
    (just 5 ticks below brake). Per-side trim
    (_STRAIGHT_BACK_*_TICKS_OFFSET) stays at 0 / 0 so the commanded
    goal on the wire is exactly 2051 / 2043.
    [settings.py]
2026-05-19 tune(config): backward lean L=2054 / R=2043 (+3 left, R unchanged)
    Operator bench iteration: bump left a touch further above brake
    (2051 → 2054, now 6 ticks above brake=2048) to compensate for a
    slight curve; right stays at 2043. Per-side trim
    (_STRAIGHT_BACK_*_TICKS_OFFSET) remains 0 / 0 so commanded goal on
    the wire is exactly 2054 / 2043.
2026-05-19 tune(config): backward lean L=2056 / R=2043 (+2 left, R unchanged)
    Operator bench iteration: nudge left a touch further above brake
    (2054 → 2056, now 8 ticks above brake=2048); right stays at 2043.
2026-05-20 tune(config): backward lean L=2060 / R=2040 (+4 left, -3 right)
    Operator bench iteration: bump both sides further from brake — L
    2056 → 2060 (12 ticks above brake=2048), R 2043 → 2040 (8 ticks
    below). Symmetric-ish around brake (~12 / ~8 tick spread).
2026-05-20 tune(config): backward lean L=2070 / R=2040 (operator bench)
    Bump L further above brake (now 22 ticks above), R stays 8 ticks
    below. Operator iterating asymmetric trim during a bench session.
2026-05-20 tune(config): backward lean L=2080 / R=2040 (operator bench)
    Bump L further above brake (now 32 ticks above), R stays 8 ticks
    below. Operator iterating asymmetric backward trim during bench.
2026-05-20 tune(config): backward lean L=2090 / R=2040 (operator bench)
    Bump L further above brake (now 42 ticks above), R stays 8 below.
2026-05-20 tune(config): backward lean L=2110 / R=2040 (operator bench)
    Bump L further above brake (now 62 ticks above), R stays 8 below.
2026-05-20 tune(config): backward lean L=2150 / R=2000 (operator bench)
    Big asymmetric step: L=2150 (102 ticks above brake=2048), R=2000
    (48 ticks below). Operator bench-iterating heavy left bias.
2026-05-20 Add Android companion parity with kiosk drive and tablet gateway.
    Wire hold/turn/straight drive APIs, health export, shell polish, and confirm dialogs; extend nina-link for volume, vision, and straight bench without changing drive_controller.
2026-05-20 feat(ui): lean cal screen — bench MX-28 backward lean tuning, no persistence
    Live preview screen for finding the MX-28 lean tick values that make
    the chassis drive straight backward. Sidebar entry "Lean Cal" opens
    two motor rows (left id12 / right id13), each with explicit "−" / "+"
    buttons for ±1-tick steps plus a slider (0..4095-clamped to brake
    ±300) for coarse sweeps. The spinbox on the right shows the current
    tick value; a Δ-from-brake label keeps the operator oriented.
    Mechanism:
    - Every commit (button tap, slider released, spinbox commit, big
    APPLY button) immediately pushes BOTH goal positions to the bus via
    NinaService.preview_hover_lean_positions — the same low-level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
2026-05-20 Fix Android Drive BLDC status stuck on checking.
    Kick lazy BLDC init from the gateway drive/status poll (same as kiosk Drive enter) and improve tablet UI for initializing vs unreachable states.
    [LinkClient.kt]
2026-05-20 feat(ui): SAVE button on Lean Cal — persist L/R into navigation.env
    Adds a SAVE TO ENV action next to APPLY / BRAKE / RESET on the Lean
    Cal screen. Clicking it persists the current slider values into
    /etc/nina-link/navigation.env as NINA_HOVER_REV_POS_LEFT and
    NINA_HOVER_REV_POS_RIGHT, so the bench-tuned lean survives the next
    service restart (the systemd unit reads the env file BEFORE the
    Python code starts, so it's the runtime source of truth).
    Helper module nina/config/navigation_env.py handles the file
    update:
    - Replaces existing NINA_HOVER_REV_POS_* lines in place; appends them
    under a header comment if missing. All unrelated lines (polarity,
    IMU flags, comments, etc.) pass throu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
    [lean_cal_screen.py, navigation_env.py, test_navigation_env_update.py]
2026-05-20 fix(ui): Lean Cal screen 20s entry hang — stop re-initializing the bus
    on_enter was calling NinaService.ensure_bus() on the GUI thread.
    That call doesn't just guard a first-time init — it re-runs
    run_health_check + ensure_joint_mode_for_ids + set_torque_all on
    EVERY invocation, while holding bus_lock. On a bus with multiple
    MX-28/MX-64 joints the health check easily takes 15–20 s, and the
    GUI thread is frozen the whole time.
    The bus is already brought up at app start by MainWindow's
    _BusInitThread (a proper background QThread). By the time the
    operator can click "Lean Cal" the bus is ready. The screen just
    needs to check service.bus_ready — no second init.
    After the fix:
    - on_enter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
    [lean_cal_screen.py]
2026-05-20 Prime tablet HTTP drive without requiring kiosk Drive screen.
    Ensure Dynamixel bus and BLDC init on gateway bootstrap and all drive commands, with clear errors while hardware is still starting.
2026-05-20 feat(audio): add MAX98357A I2S setup support
    Add the repo-side support needed to run Nina audio through a
    MAX98357A I2S amplifier once the Jetson I2S sound card is exposed by
    Jetson-IO / device tree.
    Changes:
    - Honor NINA_GREET_APLAY_DEVICE for WAV playback too, so MP3 playback,
    WAV playback, and silence warmup all target the same ALSA PCM.
    - Add scripts/setup-max98357a-audio.sh to list ALSA devices, write the
    Nina audio env vars into /etc/nina-link/navigation.env, and play a
    test tone through the selected PCM.
    - Document MAX98357A wiring, Jetson I2S enablement, ALSA verification,
    Nina env setup, and troubleshooting.
    - Add test coverage for WAV playback honoring the configured ALSA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
2026-05-20 fix(ui): pin Qt platform plugins away from OpenCV cv2 bundle
    Jetson launch.log showed Qt trying to load xcb from the pip OpenCV
    bundle under ~/.local/lib/python3.10/site-packages/cv2/qt/plugins,
    then aborting with exit 134. The launcher already attempted to pin
    QT_QPA_PLATFORM_PLUGIN_PATH, but it pointed at the Qt plugin root and
    OpenCV can still overwrite the env var as an import side-effect.
    Fix both layers:
    - launch-sirena.sh now pins QT_QPA_PLATFORM_PLUGIN_PATH directly to
    the platforms directory containing libqxcb.so, not the parent plugin
    root.
    - sirena_ui.__main__ re-pins the same value in-process immediately
    before QApplication is constructed, after any earlier cv2 import had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
    [test_qt_plugin_pin.py]
2026-05-20 fix(audio): support MP3 decode-to-WAV playback for Jetson APE I2S
    On the Orin Nano MAX98357A path, speaker-test and aplay can produce a
    clean tone through plughw:CARD=APE,DEV=0, but direct mpg123 ALSA output
    (`mpg123 -o alsa -a ...`) fails or produces garbage. The working path
    is to decode MP3 to a WAV file and play that with aplay.
    Add NINA_AUDIO_MP3_VIA_APLAY=1. When enabled, AudioPlayer handles MP3s
    by spawning a small shell pipeline: mpg123 -w <temp.wav> then aplay -D
    <NINA_GREET_APLAY_DEVICE> <temp.wav>, with cleanup via trap. This keeps
    the existing background Popen contract while using aplay as the only
    ALSA client.
    Update the MAX98357A setup script and docs to enable this mode by
    d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
    [audio_player.py, test_audio_player.py]
2026-05-20 fix(audio): route MAX98357A MP3 playback to left I2S slot
    Bench testing on Orin Nano showed the MAX98357A breakout is listening
    only to the left I2S slot: left-only WAV plays, right-only WAV is
    silent. Direct mpg123 ALSA output is already bypassed via
    NINA_AUDIO_MP3_VIA_APLAY=1, but decoded mono MP3s still needed to be
    placed into the slot the amp actually listens to.
    Add NINA_AUDIO_APLAY_STEREO_MODE with values:
    - none: keep decoded WAV as-is
    - left: convert to stereo with audio on L, silence on R
    - right: convert to stereo with silence on L, audio on R
    - dual/both/stereo: duplicate audio to both slots
    The MP3-via-aplay shell path now optionally runs a small Python wave
    conversion before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
    [audio_player.py, test_audio_player.py]
2026-05-20 fix(ui): import AudioPlayer for action audio preview
    The Actions screen preview button calls NinaService.preview_audio(),
    which instantiates AudioPlayer, but nina_service.py did not import the
    symbol. Add the missing import so action audio preview no longer raises
    NameError: AudioPlayer is not defined.
    [nina_service.py]
2026-05-20 fix(audio): apply Jetson APE route for MAX98357A startup
2026-05-20 fix(audio): normalize MAX98357A MP3 WAV output
    [audio_player.py, test_audio_player.py]
2026-05-20 fix(audio): use absolute playback commands for MP3 decode
    [audio_player.py, test_audio_player.py]
2026-05-20 fix(audio): correct MP3 decode shell branch syntax
    [audio_player.py, test_audio_player.py]
2026-05-20 fix(audio): preserve decoded MP3 WAV sample rate
    [audio_player.py, test_audio_player.py]
2026-05-20 fix(audio): soften Nina volume boost clipping
    [audio_player.py, settings_screen.py, test_audio_player.py]
2026-05-20 Fix tablet drive/status HTTP 500 during kiosk polling.
    Stop blocking the Qt GUI thread on Android polls, sanitize NaN/Inf for JSON encoding, and return structured JSON errors instead of bare 500 so the companion Drive pill can update.
    [test_drive_http_brake.py]
2026-05-20 fix(audio): cap app volume at original level
    [audio_player.py, settings_screen.py, test_audio_player.py]
2026-05-20 Fix drive/status import error: add hover_calibration module.
    Move drive_status_payload to drive_http so GET /v1/robot/drive/status does not import tablet_drive_extras (missing nina.config.hover_calibration broke kiosk gateway).
    [hover_calibration.py, test_hover_calibration.py]
2026-05-20 Android drive: skip straight-ready poll when BLDC already connected.
    When drive status is green, straight front/back use a single status fetch instead of up to 5s of polling so timed moves start faster over Wi-Fi.
2026-05-20 Android drive: fix stuck controls, fast HTTP, immediate brake on stop.
    Non-blocking D-pad hold, parallel halt+brake on STOP/E-stop, 8s drive timeouts, straight watchdog, and clearer HTTP 500 handling. Turn no longer locks the whole panel.
    [LinkClient.kt]
2026-05-20 Android drive: fix straight/turn cancelled before motion starts.
    Wait for straight_pulse_active to go true before treating idle as done; remove status poll that cleared straightRunning early; use longer HTTP timeouts for straight/turn POST.
    [LinkClient.kt]
2026-05-20 Add motor system reference doc and improve Android drive responsiveness.
    Document all 13 Dynamixels and hoverboard-only locomotion. On the companion app, use longer HTTP timeouts for hold/turn, prefetch drive status, reduce status-poll contention, and surface Jetson volume errors when pairing or ALSA is missing.
    [LinkClient.kt]
2026-05-20 fix(ir): stop and neutralize at 40cm obstacles
    [ir_obstacle_stop_monitor.py, nina_service.py, settings.py, test_ir_obstacle_motion_gating.py]
2026-05-20 feat(ir): show obstacle sensor status in UI
2026-05-20 Reduce tablet drive latency and make stop/E-stop immediate.
    Fast-path hardware prime when BLDC is warm, urgent command-plane queue for halt commands, and kiosk-parity E-stop via DriveController. Android sends stops first and avoids status polls blocking drive POSTs.
    [LinkClient.kt]
2026-05-20 fix(ir): speak obstacle alert immediately
    [nina_service.py, sensor_alert_audio.py, test_nina_service_obstacle_stop.py, test_sensor_alert_audio.py]
2026-05-20 fix(android): avoid blocking Nina UI during drive polling
    [test_drive_http_brake.py]
2026-05-20 fix(vision): default detectors off for fast screen open
    Face and object detection now opt in via toggles (or NINA_VISION_*_AUTO env)
    so Vision opens the camera preview without blocking on YOLO/TensorRT startup.
    [test_vision_screen_defaults.py, vision_screen.py]
2026-05-20 fix(touch): one-shot AT42QT2120 reactions without alert loops
    Use rising-edge debounce, release-gated re-arm, post-reaction blind window,
    and cooldown after the reaction completes. Speak on a background thread
    before parking servos so polling stays responsive.
    [nina_service.py, sensor_alert_audio.py, settings.py, test_touch_at42qt2120_debounce.py, touch_at42qt2120_monitor.py]
2026-05-20 fix(touch): retry AT42QT2120 bring-up after reboot
    Probe I2C with backoff, retry monitor start for two minutes, enable touch
    in the kiosk unit, and allow idempotent restarts when the bus is late.
    [at42qt2120.py, nina_service.py, settings.py, test_touch_at42qt2120_bringup.py, touch_at42qt2120_monitor.py]
2026-05-20 fix(touch): suppress stuck-high STATUS and require idle baseline
    When the electrode reads continuously true with mask=0 (back coupled to
    metal), latch stuck-high after 2s, block reactions until clear, and show
    raw vs effective state in the bench test.
    [at42qt2120.py, at42qt2120_bench_test.py, settings.py, test_touch_at42qt2120_bringup.py, test_touch_at42qt2120_debounce.py, touch_at42qt2120_monitor.py]
2026-05-20 feat(drive): IMU straight FWD/BACK, micro-step turns, exclusive D-pad
    Manual forward and back always use drift-corrected straight pulse on hoverboard.
    Held left/right and Turn buttons fire closed-loop micro-steps; kiosk and Android
    grey out other D-pad arrows while one direction is active.
    [drive_controller.py, drive_screen.py, hoverboard_axis_drive.py, test_drive_controller_polarity.py, test_hover_forward_pulse.py]
2026-05-20 fix(gateway): harden FD limits and reduce tablet poll socket pressure
    Raise RLIMIT_NOFILE in Python and systemd, guard the gateway when FD use is
    high, serve drive status without blocking the Qt plane, and release Drive
    camera on screen leave.
    [drive_screen.py]
2026-05-20 fix(actions): exclude hoverboard lean motors 12–13 from record/playback
    Recorded actions and torque release during posing should only touch arm
    motors so BLDC lean axes stay under drive control.
    [dynamixel_manager.py, main.py, motor_ids.py, record_worker.py, test_action_motor_ids.py]
2026-05-20 Add remote action recording countdown and progress like kiosk Actions.
    Expose live record phase, countdown, and frame progress on record/status; Android polls faster and shows countdown, progress bar, and status line.
2026-05-20 fix(ir): probe GP2Y0E02B at startup and stop open-failure log spam
    Skip the obstacle monitor when I2C does not respond at 0x40, and rate-limit
    retries with backoff so a missing sensor no longer floods launch.log.
    [gp2y0e02b.py, ir_obstacle_stop_monitor.py, nina_service.py, test_gp2y0e02b_probe.py]
2026-05-20 fix(fd): close I2C bus on failed GP2Y0E02B open and harden MJPEG gateway
    Failed IR cliff open retries were leaking SMBus fds until EMFILE on port 8787.
    Also tear down vision MJPEG on tablet disconnect and cap uvicorn keep-alive.
    [gp2y0e02b.py, test_gp2y0e02b_open.py]
2026-05-20 fix(osk): show onboard on touch tap and raise hidden keyboard via D-Bus
    Touchscreens often skip FocusIn on spinboxes and line edits; also re-show
    onboard when the process is alive but the window was dismissed.
    [osk.py, test_osk.py]
2026-05-20 fix(osk): prevent duplicate onboard keyboards on touch activation
    Debounce mouse/focus events, prefer D-Bus Show over a second spawn, and
    disable onboard AT-SPI auto-show so only Nina controls the OSK.
    [osk.py, test_osk.py]
2026-05-20 feat(esp32): play namaste when GPIO trigger goes high on BCM 17
    Poll physical pin 11 (E-stop pad) for a debounced rising edge from the ESP32,
    stop drive, and run the namaste gesture with manifest audio. Keep the pad as
    input-only so it does not conflict with right-wheel DIR on pin 16.
2026-05-21 feat(audio): default Jetson HDMI playback and stop Pulse before kiosk
    Seed tegra-HDA ALSA settings via setup-hdmi-audio.sh on kiosk install, disable
    I2S keepalive flags that caused EBUSY on HDMI, and add ExecStartPre to release
    PipeWire/Pulse so Nina can open plughw:CARD=HDA,DEV=3 on fleet boards.
2026-05-21 feat(vision): install ultralytics on every kiosk setup
    Run install-vision-jetson.sh from install-nina-ui-kiosk.sh so fleet Jetson
    boards get YOLO deps in .venv-link without a separate manual step.
2026-05-21 fix(ui): wait for background QThreads before shutdown
    Reduces abort on kiosk restart when bus init or home health threads are
    still running when the main window is destroyed.
2026-05-21 fix(vision): prevent apt sympy from breaking YOLO in kiosk
    Prepend .venv-link site-packages on PYTHONPATH before dist-packages,
    unset PYTHONHOME from bashrc, and import YOLO before torch.load patch.
    Adds kiosk import diagnostics and install checks for from ultralytics import YOLO.
    [vision_pipeline.py]
2026-05-21 feat(jetson): install gTTS/ffmpeg for Actions audio generation
    Add install-action-audio-jetson.sh and run it from install-nina-ui-kiosk
    so the kiosk .venv-link can generate action clips from the Actions screen.
2026-05-21 fix(ui): import AudioGenerator in NinaService for action audio generation.
    [nina_service.py]
2026-05-21 feat(ui): kiosk settings, Wi-Fi scan, volume, and coming-soon gates
    Improve Sirena UI on the Jetson panel: reworked network settings with
    nearby/saved Wi-Fi lists and scan API, fix power actions via gateway,
    header system volume control, separate audio sliders, and disable map/
    autonomy until those features ship (Android parity).
    [drive_screen.py, map_screen.py, perception_screen.py]
2026-05-21 fix(ui): splash video, power sudo probe, and kiosk UI polish
    Add startup splash from assets/nina_splash.mp4, require install-nina-host-power
    sudoers before shutdown/reboot (with clear Settings feedback), fix Drive
    screen import typo, and tidy Wi-Fi list selection, header volume, and Vision rail.
    [drive_screen.py, settings_screen.py, vision_screen.py]
2026-05-21 fix(ui): prevent QThread abort on kiosk startup after splash
    Defer MainWindow construction until after the splash, parent background
    threads to the UI instead of deleteLater, and disable ffplay fullscreen by
    default to stop exit 134 (QThread destroyed while still running).
    [home_screen.py, settings_screen.py]
2026-05-21 feat(ui): saved drive sequences with IMU-scaled turns
    Add Movements screen to author and run named forward/back/turn/U-turn
    sequences. Turns use new pulse_turn_degrees (pulse_turn_90 unchanged);
    straight legs reuse existing IMU straight pulse. Persist to
    nina/actions/saved_movements.json.
2026-05-21 fix(android): clearer Actions audio errors and generate UX
    Validate pairing/URL/text before mutate calls, surface FastAPI detail via linkApiErrorMessage, use a longer OkHttp read for gTTS generate, and show busy/progress plus static-actions gating on the Audio tab.
    [LinkClient.kt]
2026-05-21 Improve kiosk startup splash and header power/Wi-Fi UX.
    Block on a branded splash before the gateway and MainWindow, add header
    speaker icon and Power off/Reboot menu, and filter stale nmcli scan rows.
    [settings_screen.py]
2026-05-21 Fix splash path, add hidden dev quit, remove Settings quit.
    Pin startup splash to repo assets/nina_splash.mp4, add 8-tap logo
    password exit (NINA_UI_DEV_QUIT_PASSWORD), and drop Quit from Power.
    [settings_screen.py]
2026-05-21 fix(drive): swap forward/back hall mapping in software
    Cross-map FWD/REV env vars at load so UI motion matches swapped chassis
    wiring; reset turn pivot defaults and align Lean Cal persistence.
    [hoverboard_axis_drive.py, lean_cal_screen.py, navigation_env.py, settings.py, test_hover_forward_pulse.py, test_hover_pulse_turn_90.py, test_navigation_env_update.py]
2026-05-21 chore(battery): temporarily lower low-voltage latch to 24 V
    Set kiosk and navigation.env.example thresholds for bench testing;
    revert to 25.5 / 26.1 when the pack tune is finalized.
2026-05-21 fix(jetson): isolate kiosk ML deps in .venv-link
    Ignore ~/.local site-packages in launch-sirena, force pip into the venv,
    install sympy in vision setup, and add fix-jetson-kiosk-deps.sh for
    boards with polluted user installs.
2026-05-21 fix(kiosk): install fastapi/uvicorn for tablet gateway on Jetson
    Kiosk-only installs were missing requirements-link.txt, causing
    ModuleNotFoundError: fastapi at sirena_ui startup.
2026-05-21 fix(jetson): force fastapi into venv when ~/.local shadows pip
    Use pip --force-reinstall so requirements-link installs into
    .venv-link; pin setuptools<82 for torch; match kiosk PYTHONNOUSERSITE check.
2026-05-21 fix(drive): align hover FWD/REV env with hall-swap bench table
    FWD_* and REV_* now map directly to UI forward/backward with exchanged
    defaults (2150/2000 vs 2022/2080), auto-swap for legacy navigation.env,
    REV keys for backward lean cal, and straight-forward per-side trim.
    [hoverboard_axis_drive.py, lean_cal_screen.py, navigation_env.py, settings.py, test_hover_forward_pulse.py, test_hover_fwd_rev_load.py, test_navigation_env_update.py]
2026-05-21 fix(drive): hardcode fleet hover lean defaults (FWD 2022/2080, REV 2100/2000)
    Use direct FWD/REV mapping with swap disabled by default; remove legacy
    auto-detect so unmigrated navigation.env no longer overrides the bench tune.
    [settings.py, test_hover_fwd_rev_load.py]
2026-05-22 fix(drive): use full pivot blend for all turn micro-steps
    Hardcode 100% lean on closed-loop turns, timed pivots, and IMU drift
    correction during straight forward/back so partial blends are no longer used.
    [hoverboard_axis_drive.py, test_hover_forward_pulse.py, test_hover_imu_correction.py, test_hover_pulse_turn_90.py]
2026-05-22 fix(drive): soften held D-pad turns to 50% pivot lean
    Held left/right micro-steps were using full pivot goals (1822/1800 and
    2300/2280); reduce to half blend so mechanical swing is gentler while
    straight-line IMU correction stays at 100%.
    [hoverboard_axis_drive.py, test_hover_pulse_turn_90.py]
2026-05-22 fix(drive): soften turn pacing and reduce held-pivot lean to 30%
    Use turn-specific step duration/settle defaults, slower step rate, longer
    D-pad interval and timed fallback; align timed pivot fallback with the same
    30% lean blend and log when IMU hold-turn is unavailable.
    [drive_controller.py, drive_screen.py, hoverboard_axis_drive.py, settings.py, test_hover_pulse_turn_90.py]
2026-05-22 fix(drive): align in-motion yaw correction with held D-pad turn lean
    Forward/back pulse drift realign now uses 30% pivot blend and NINA_HOVER_TURN_*
    step timing instead of the legacy 100% IMU_CORR pivots.
    [hoverboard_axis_drive.py, test_hover_imu_correction.py]
2026-05-22 fix(drive): oppose in-motion yaw drift with swapped pivot mapping
    Default NINA_HOVER_IMU_CORR_SWAP_PIVOT_DIR=1 so FWD/BACK pulse corrections
    rotate against drift instead of with it on the reference chassis.
    [hoverboard_axis_drive.py, test_hover_imu_correction.py]
2026-05-22 fix(drive): align straight drift correction with held D-pad pivots
    Use the same remaining-sign → goals mapping as held L/R (30% blend) instead
    of a separate swap default that over-corrected opposite to drift.
    [hoverboard_axis_drive.py, test_hover_forward_pulse.py, test_hover_imu_correction.py]
2026-05-22 fix(drive): use hold-turn motor goals for IMU drift correction
    Route FWD/BACK standstill and in-motion yaw realign through
    _pivot_goals_for_hold_turn_step so servos 12/13 match held L/R micro-steps.
    [hoverboard_axis_drive.py, test_hover_forward_pulse.py]
2026-05-22 fix(drive): hold straight drift correction as long as D-pad turn steps
    Reuse hold-turn step duration (~0.26s) instead of 0.03s straight-correction
    kicks so the same pivot lean actually rotates the chassis.
    [hoverboard_axis_drive.py, test_hover_forward_pulse.py]
2026-05-22 fix(drive): use smaller yaw steps for straight drift correction only
    Default NINA_HOVER_STRAIGHT_CORR_STEP_DEG=5 so FWD/BACK correction rotates
    less per step than D-pad turns (15°), reducing oscillation while keeping
    the same pivot lean goals.
    [hoverboard_axis_drive.py, test_hover_forward_pulse.py]
2026-05-22 fix(android): use block body in postActionAudioGenerate
    Kotlin disallows return inside expression-bodied try; fixes assembleDebug compile.
2026-05-22 fix(drive): make saved movement sequences safe for U-turn and return legs
    Use 180° U-turns instead of 360° spins, run sequence turns with gentle
    D-pad-style micro-steps, cap correction when drift is huge, and settle
    after each turn to avoid BLDC overload after a missed heading change.
    [hoverboard_axis_drive.py, movements_screen.py, test_saved_sequence_drive.py]
2026-05-22 fix(android): safe-call movement run status on failure
    Use nullable JSONObject access in the failed-run poll branch so assembleDebug compiles.
2026-05-22 fix(ui): make on-screen keyboard appear reliably on text entry
    Recover when onboard D-Bus Show fails, auto-focus dialogs and editor
    fields, skip read-only inputs, and install gsettings for onboard stacking.
    [movements_screen.py, osk.py, test_osk.py]
2026-05-22 fix(drive): stop runaway spins during saved movement sequences
    Pivot sequence turns toward remaining yaw instead of a fixed L/R label,
    and brake with cant_move when overshoot, yaw rate, or remaining growth
    indicates an autonomous spin. Refuse open-loop timed turns in sequences.
    [hoverboard_axis_drive.py, test_saved_sequence_drive.py]
2026-05-22 fix(ui): keep Drive screen within 1024×600 kiosk bounds
    Size the kiosk window to the visible screen, give manual controls more
    column width, and trim D-pad and status pills so the right edge is not clipped.
    [drive_screen.py]
2026-05-22 feat(movements): add brake step to saved drive sequences
    Allow brake as an ordered step in movement CRUD on kiosk and Android, with engage_brake execution and release before subsequent motion steps.
2026-05-22 fix(ui): readable movement list selection and E-STOP on Movements screen
    Use visible selected-row styling so sequence names stay legible, and add
    an emergency stop control that halts an in-flight saved sequence.
    [movements_screen.py]
2026-05-22 fix(battery): persist low-battery latch and repeat warnings across restarts
    Keep motion blocked after UI restart, track pack minimum for 0.2 V step
    alerts, add timed reminders while latched, and fast-latch when the pack
    is still low on startup.
    [battery_ads1115_monitor.py, battery_latch_store.py, nina_service.py, settings.py, test_battery_ads1115_debounce.py, test_battery_latch_store.py]
2026-05-22 fix(ui): stop Drive screen right-edge clipping on 1024×600 kiosk
    Clamp kiosk window to the physical panel, narrow the sidebar, cap the
    camera column width, and reflow the HUD so manual controls keep full width.
    [drive_screen.py]
2026-05-22 fix(drive): halve straight drift-correction step to 2.5°
    Gentler standstill yaw corrections during forward/back pulse legs reduce
    overshoot; override still via NINA_HOVER_STRAIGHT_CORR_STEP_DEG.
    [hoverboard_axis_drive.py, test_hover_forward_pulse.py]
2026-05-22 fix(ui): force 1024×600 kiosk window and disable HiDPI shrink
    Size the frameless kiosk to fleet panel dimensions instead of a small
    availableGeometry, remove showFullScreen/showNormal fighting, and turn off
    Qt high-DPI scaling in fullscreen mode.
2026-05-22 Gate IR obstacle stop to motion and improve ESP32 GPIO trigger reliability.
    IR polls only while the drive is moving (including saved sequences); ESP32 gets faster debounce, Orin pin mapping, Health status, a bench probe, and clearer startup logs.
2026-05-22 chore(robot): sync Nina actions, greetings, and Jetson test scripts
    Update action audio/recordings and manifest for handshake gestures, add
    saved movements and face/greeting assets, and add local sensor/IMU test
    helpers used during Jetson bring-up.
2026-05-22 fix(touch): stop AT42QT2120 false retriggers from mask noise and motor vibration.
    Use STATUS-only detection by default, lengthen debounce/cooldown, and hold the monitor disarmed for 30s after each reaction.
    [at42qt2120.py, settings.py, test_at42qt2120_touch_active.py, test_touch_at42qt2120_bringup.py, test_touch_at42qt2120_debounce.py, touch_at42qt2120_monitor.py]
2026-05-22 fix(ui): make onboard OSK show reliably on touchscreen text fields.
    Force-show on tap, retry when D-Bus Show leaves the keyboard hidden, quit stale sessions, and use Compact layout defaults in the kiosk unit.
    [osk.py, test_osk.py]
2026-05-22 fix(audio): keep persistent aplay silence to stop HDMI idle hiss.
    Default NINA_AUDIO_PERSISTENT_PIPE on so one stream stays open with digital silence between clips; update HDMI setup and docs.
    [audio_player.py, test_audio_player.py]
2026-05-22 fix(audio): idle-mute and direct HDA when stuck on ALSA default.
    Enable soft-mute for default/HDMI paths, auto-resolve plughw:CARD=HDA at launch, and run the persistent pipe at 48 kHz.
    [audio_player.py, test_audio_player.py]
2026-05-22 fix(ui): make onboard OSK spawn reliably on the Jetson kiosk.
    Quit stale D-Bus onboard sessions, resolve /usr/bin/onboard under minimal PATH, pin keyboard geometry, and add focusChanged + wmctrl raise fallbacks.
    [osk.py, test_osk.py]
2026-05-22 fix(ui): restore _split_args and _env_int broken in OSK refactor.
    Fixes NameError on startup that prevented Nina from launching after d419618.
    [osk.py]
2026-05-22 fix(ui): respawn onboard on every text-field tap after it hides.
    Reap exited processes, delay spawn after D-Bus quit, always force-show on activation, and stop retry Hide that dismissed the keyboard.
    [osk.py, test_osk.py]
2026-05-22 fix(ui): respawn onboard when hidden; exclude Wi-Fi list false triggers.
    QListWidget taps no longer steal the first keyboard spawn. Real text fields
    respawn when wmctrl shows no onboard window; kiosk defaults to always-on OSK.
    [osk.py, test_osk.py]
2026-05-23 fix(touch): restore key-mask detection and limit stuck-high to phantom STATUS.
    STATUS-only mode missed real electrode touches on mask-only wiring; stuck-high
    suppression now applies only when STATUS is high with mask=0 so mask touches
    still fire.
    [at42qt2120.py, settings.py, test_at42qt2120_touch_active.py, test_touch_at42qt2120_bringup.py, test_touch_at42qt2120_debounce.py, touch_at42qt2120_monitor.py]
2026-05-23 fix(touch): learn idle mask and fire on mask change, ignore latched STATUS.
    Constant STATUS=0x01 with idle mask=0x001 prevented baseline from ever clearing;
    now capture the idle fingerprint at boot and trigger only when the mask changes.
    [test_touch_at42qt2120_debounce.py, touch_at42qt2120_monitor.py]
2026-05-23 fix(touch): fire only on new mask bits above idle, not mask drops.
    Idle leakage at 0x001 was triggering reactions when the mask glitched to
    0x000; require (masked & ~idle_mask) != 0 so only added channels count.
    [test_touch_at42qt2120_debounce.py, touch_at42qt2120_monitor.py]
2026-05-23 fix(touch): detect dip-then-rise presses and log mask transitions.
    Idle leakage at 0x001 can dip to 0x000 then rise above idle on a real press;
    accept recovery above idle and emit INFO lines when the mask changes for bench
    diagnosis on the Jetson.
    [test_touch_at42qt2120_debounce.py, touch_at42qt2120_monitor.py]
2026-05-23 fix(touch): treat mask drop below idle as press on inverted channel 0.
    Bench logs show real touches as 0x001 -> 0x000 while idle; firing only on
    mask above idle never activated. Accept masked < idle_mask as touch-active.
    [test_touch_at42qt2120_debounce.py, touch_at42qt2120_monitor.py]
2026-05-23 fix(touch): grace debounce for inverted 0x001↔0x000 mask oscillation.
    Press clears bit 0 but the line bounces back within one poll; accumulate
    press edges across a 180ms grace window with debounce=2 instead of
    requiring five consecutive low reads.
    [settings.py, test_touch_at42qt2120_debounce.py, touch_at42qt2120_monitor.py]
2026-05-23 fix(touch): fire immediately on inverted press edge (0x001->0x000).
    Press edges were logged but debounce=5 from navigation.env blocked reactions;
    inverted idle wiring now triggers on the first falling-edge without debounce.
    [test_touch_at42qt2120_debounce.py, touch_at42qt2120_monitor.py]
2026-05-23 fix(touch): arm after stable idle post-boot; drop instant edge fire.
    Boot calibration caused a spurious 0x001->0x000 edge and 30s cooldown blocked
    real touches. Wait 15 idle polls before arming, require press from idle, use
    grace debounce=2, and shorten cooldown to 15s.
    [settings.py, test_touch_at42qt2120_bringup.py, test_touch_at42qt2120_debounce.py, touch_at42qt2120_monitor.py]
2026-05-23 fix(touch): require 0.6s sustained inverted press, ignore noise edges.
    Electrical noise oscillates 0x001↔0x000 every ~100ms; edge detection false
    triggered constantly. Fire only after mask stays below idle for hold_sec,
    with brief bounce tolerance during the hold.
    [settings.py, test_touch_at42qt2120_bringup.py, test_touch_at42qt2120_debounce.py, touch_at42qt2120_monitor.py]
2026-05-23 fix(touch): repair startup log format and log when hold begins.
    Startup log had mismatched format args; add INFO when sustained press
    accumulation starts so operators can confirm a real hold vs noise edges.
    [touch_at42qt2120_monitor.py]
2026-05-23 fix(touch): use poll-count hold so inverted bounce does not delay alerts.
    Replace wall-clock hold with a poll accumulator that tolerates brief 0x001
    glitches, keep counting through cooldown, and fire when quiet ends if the
    hold threshold was already met.
    [settings.py, test_touch_at42qt2120_bringup.py, test_touch_at42qt2120_debounce.py, touch_at42qt2120_monitor.py]
2026-05-23 fix(touch): use DMR keystatus detection to stop false triggers.
    Match Nino firmware: read KEY_STATUS with 0xFF idle, level debounce at 1 Hz,
    release re-arm, and 2s cooldown; keep key_mask mode for legacy inverted wiring.
    [at42qt2120.py, settings.py, test_at42qt2120_touch_active.py, test_touch_at42qt2120_bringup.py, test_touch_at42qt2120_debounce.py, touch_at42qt2120_monitor.py]
2026-05-23 fix(vision): restore Hello greetings via AudioPlayer and face auto-start.
    Auto-enable face recognition on kiosk Vision open and route greeting playback
    through the shared persistent ALSA pipe instead of direct mpg123.
    [face_greeter.py]
2026-05-23 Ease ESP32-triggered actions to neutral when GPIO line goes low.
    Keep polling the trigger pin during playback, interrupt smooth motion on a debounced falling edge, and ramp arms to the neutral pose instead of stopping abruptly. Document the drive-then-check straight loop and simplify the neutral recording used for release.
2026-05-23 Match ESP32 action tempo to UI playback and improve forward debug.
    Share action_playback_speed() (default 0.5) across Actions screen and ESP32 trigger so GPIO-triggered gestures no longer run at 2× speed. Add forward-motion diagnose script and log why straight drive falls back to kick/cruise.
    [action_runner.py, drive_controller.py, nina_service.py, playback_worker.py, test_action_playback_speed.py]
2026-05-23 Increase straight-forward lean trim on motor 13 by 10 ticks.
    Raise the default NINA_HOVER_STRAIGHT_FWD_RIGHT_TICKS_OFFSET from +10 to +20 so forward legs push the right hoverboard lean harder against observed yaw bias.
2026-05-23 Retune straight-forward lean goals to L=2010 and R=2104.
    Set motor 12 offset to +2 and revert motor 13 to +10 so fleet FWD 2022/2080 with the standard nudge yields the bench-validated forward lean targets.
    [hoverboard_axis_drive.py, test_hover_forward_pulse.py]
2026-05-23 Fix straight-leg drift correction pivoting the wrong way.
    Counter-yaw now maps drift sign through swap-aware remaining yaw so +drift
    uses hold-right and -drift uses hold-left on the default mount; standstill
    correction also retries once with the opposite hold turn when a step grows
    |drift| before bailing.
    [hoverboard_axis_drive.py, test_hover_forward_pulse.py, test_hover_imu_correction.py]
2026-05-23 chore(actions): map each gesture to audio/ in manifest
    Wire explicit file + audio paths for all actions that have MP3s under
    nina/actions/audio/, using audio/<action_name>.mp3 like introduction.
    Add handshake_left/right MP3s aligned to manifest action names.
2026-05-23 fix(android): movements brake compile and rebuild sideload APK
    Fix SirenaMovementsScreen + Brake onClick so release builds succeed.
    Improve build-companion-apk.ps1 (JDK/SDK detection, shareable copy).
2026-05-26 Add local edge voice assistant (ASR, Ollama LLM, TTS) for Jetson Nina.
    Ports the sirena-repo voice microservices into nina/voice with a Python
    orchestrator wired into NinaService, loopback launch scripts, and docs —
    no cloud gateway or vision dependencies.
2026-05-27 Fix whisper-tiny download and add Voice screen with push-to-talk.
    The installer was pulling whisper-large-v3-turbo into the wrong cache path;
    download now uses Systran/faster-whisper-tiny (~75 MB) into models/whisper-tiny.
    Adds sidebar Voice screen (hold mic → ASR → LLM → TTS) and Close app item.
    [download_whisper_model.py, nina_service.py, voice_screen.py]
2026-06-03 Add ESP8266 eye UART control, firmware, and touch sensor improvements.
    Jetson sends expression ids 0-33 over serial (CLI, kiosk, Android, HTTP, manifest offsets). Includes NodeMCU sketch, TFT_eSPI setup, and AT42QT2120 touch debounce.
2026-06-03 Add UART OK/ERR echo on eye firmware for Jetson link debug.
2026-06-03 Send UART OK ack before eye animation so Jetson read does not time out.
2026-06-03 Disable DTR/RTS on eye UART open for CP210x USB on Jetson.
2026-06-03 Fix action_playback_speed import so sirena_ui starts.
    [nina_service.py]
2026-06-03 Add formal ESP8266 eye deployment guide and document USB Jetson path.
2026-06-03 Document direct Jetson USB cable to NodeMCU as validated eye link.
2026-06-03 Clarify standard USB charger+data cable is the validated eye link.
2026-06-04 Auto-load navigation.env for eye UART; default ttyUSB0; stop kiosk THS1 override.
2026-06-04 Document USB-only eye link; comment out unused 40-pin UART (ttyTHS1) path.
